DeepSpace00/DeepSpace-KiCad-Global-Source/README.md

# DeepSpace-KiCad-Global-Source
DeepSpace global symbols and footprints for KiCad

# Licnese
Licenced under the [Creative Commons CC-BY-SA 4.0 Licence](https://github.com/Destination-SPACE/DS-KiCad-Global-Source/blob/main/LICENSE) or as referenced

(c) DeepSpace00 2024
