DeepSpace00/DeepSpace-KiCad-Global-Source/DS_models/Connector_JST/JST-XH SMD Parameter Editor.png

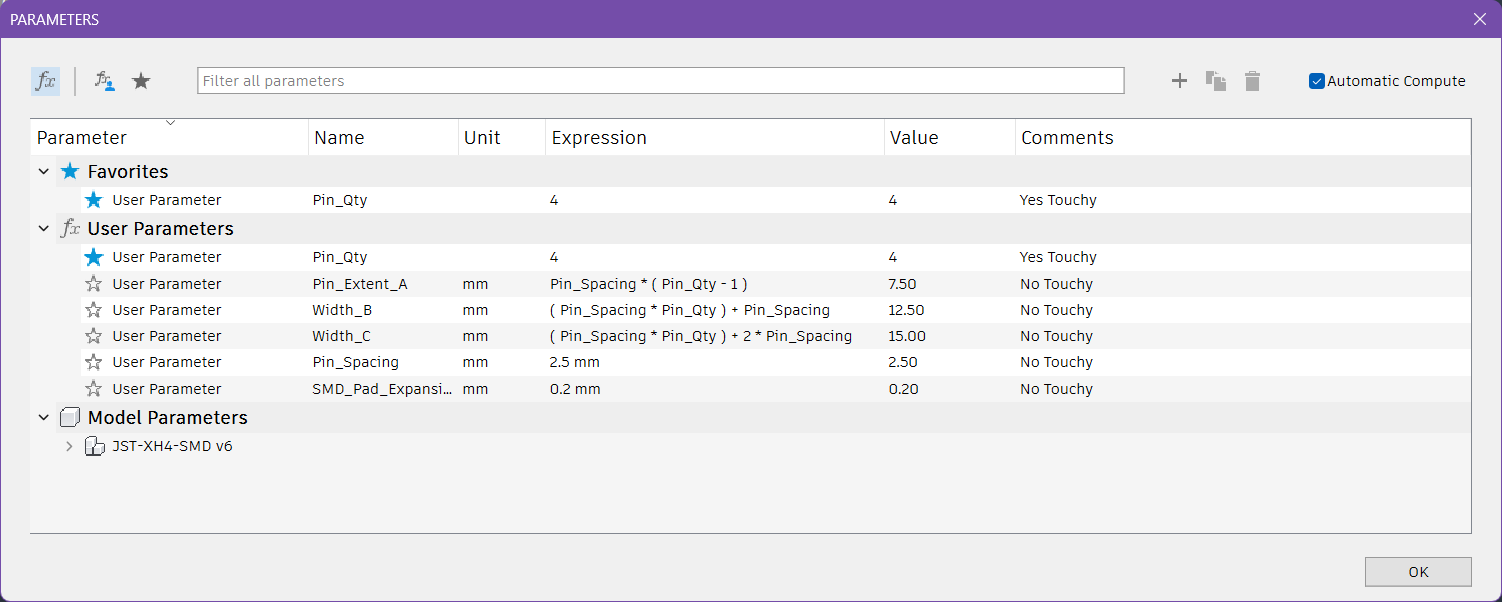
DS_models/Connector_JST/JST-XH SMD Parameter Editor.png
