DeepSpace00/DeepSpace-KiCad-Global-Source/DS_models/xiaoC6-Assembly.step

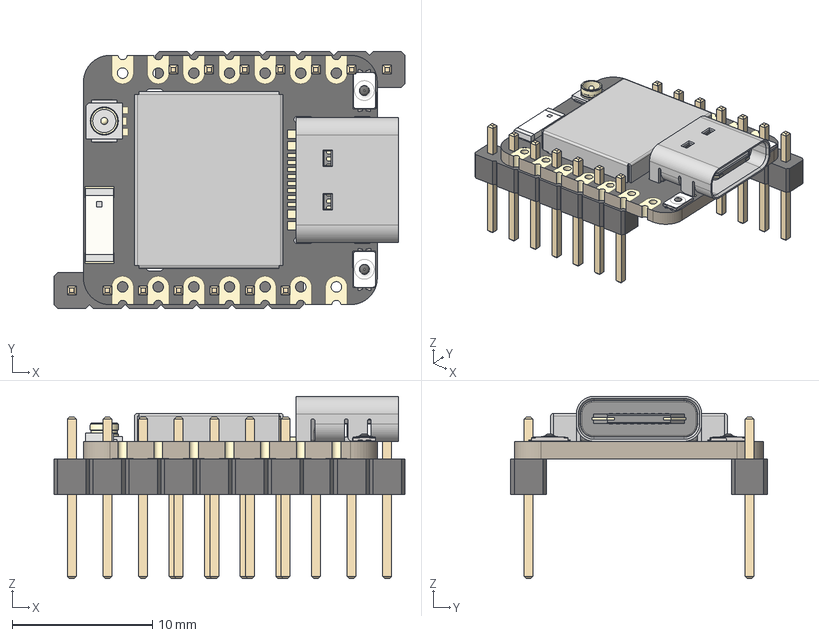
[picture p2: CAD file, 2025-07-27]
DS_models/xiaoC6-Assembly.step
25.0 x 18.3 x 13.0 mm
BOSS-EXTRUDE14_8_
BOSS-EXTRUDE7_4_
BOSS-EXTRUDE7_3_
BOSS-EXTRUDE14_4_
BOSS-EXTRUDE14_2_
BOSS-EXTRUDE14_11_
BOSS-EXTRUDE7_7_
BOSS-EXTRUDE14_9_
BOSS-EXTRUDE14_3_
BOSS-EXTRUDE14_7_
MIRROR2
BOSS-EXTRUDE14_5_
BOSS-EXTRUDE14_12_
BOSS-EXTRUDE7_8_
BOSS-EXTRUDE7_1_
BOSS-EXTRUDE14_10_
BOSS-EXTRUDE7_9_
BOSS-EXTRUDE14_6_
BOSS-EXTRUDE14_1_
BOSS-EXTRUDE7_6_
BOSS-EXTRUDE7_2_
CUT-EXTRUDE5
BOSS-EXTRUDE7_5_
U.FL Connector v1
U.FL Connector v002
U.FL Connector v003
Shield
SKTAAAE010 v1 x 2
KH5220-A36 (Ceramic Antenna) v2
KH5220-A36 (Ceramic Antenna) v003
KH5220-A36 (Ceramic Antenna) v004
KH5220-A36 (Ceramic Antenna) v005
PinHeader_1x07_P254mm_Vertical x 2
