DeepSpace00/DeepSpace-KiCad-Global-Source/DS_models/Battery/bh-98-1.stp

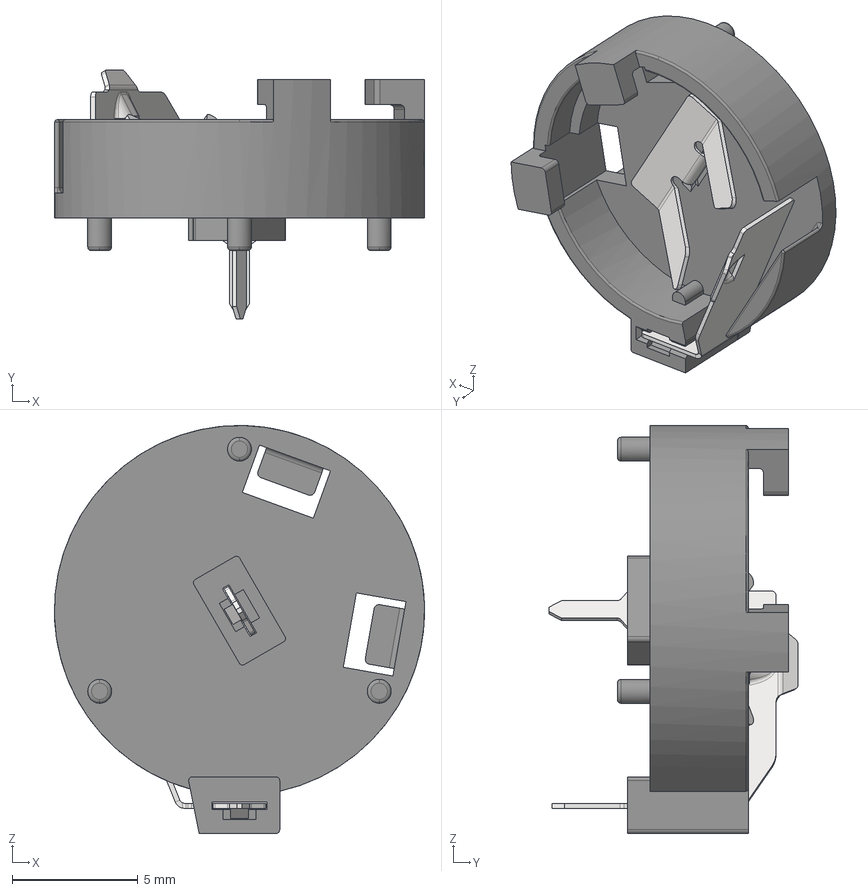
[picture p3: CAD file, 2024-09-05]
DS_models/Battery/bh-98-1.stp
14.7 x 9.88 x 16.2 mm
