DeepSpace00/DeepSpace-KiCad-Global-Source/DS_models/Button_Switch_SMD/PTS647SM38SMTR2LFS.stp

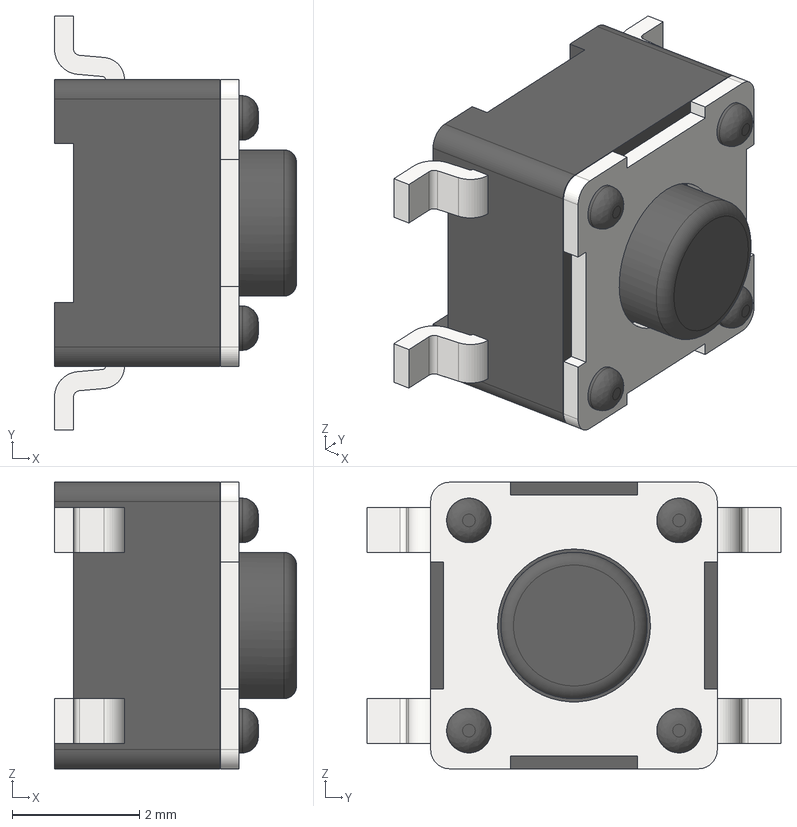
[picture p5: CAD file, 2024-09-05]
DS_models/Button_Switch_SMD/PTS647SM38SMTR2LFS.stp
3.80 x 6.50 x 4.50 mm
