DeepSpace00/DeepSpace-KiCad-Global-Source/DS_models/Buzzer/CUI_DEVICES_CMI-1240-SMT.step

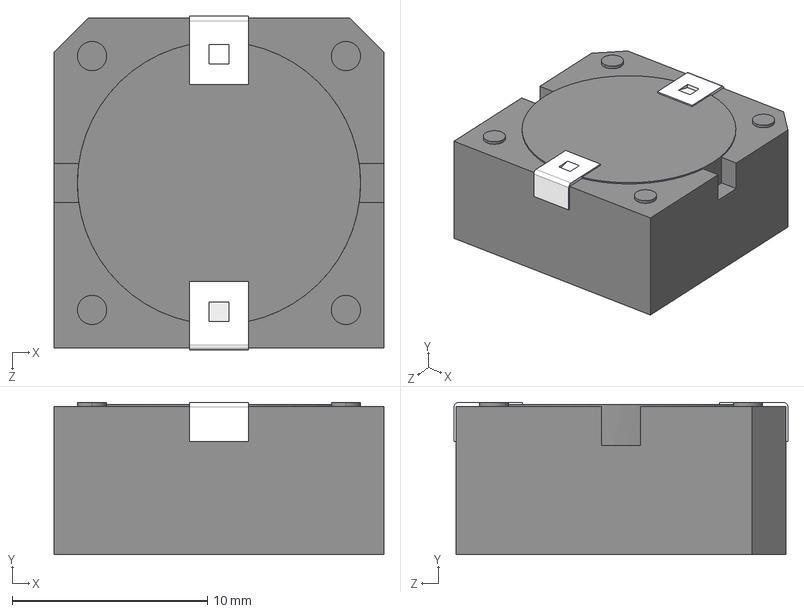
[picture p6: CAD file, 2024-09-05]
DS_models/Buzzer/CUI_DEVICES_CMI-1240-SMT.step
16.9 x 7.80 x 17.1 mm
