DeepSpace00/DeepSpace-KiCad-Global-Source/DS_models/Capacitor_Ceramic_SMD/GRM21BR71A475KE51K.STEP

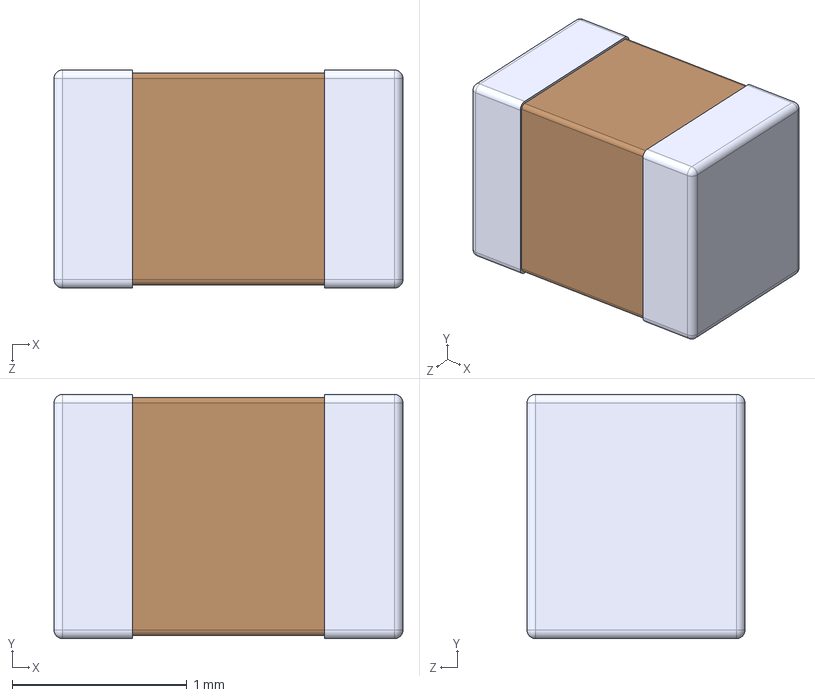
[picture p7: CAD file, 2025-07-27]
DS_models/Capacitor_Ceramic_SMD/GRM21BR71A475KE51K.STEP
2.00 x 1.40 x 1.25 mm
