DeepSpace00/DeepSpace-KiCad-Global-Source/DS_models/Capacitor_Electrolytic_SMD/EXV-9D_KEM.step

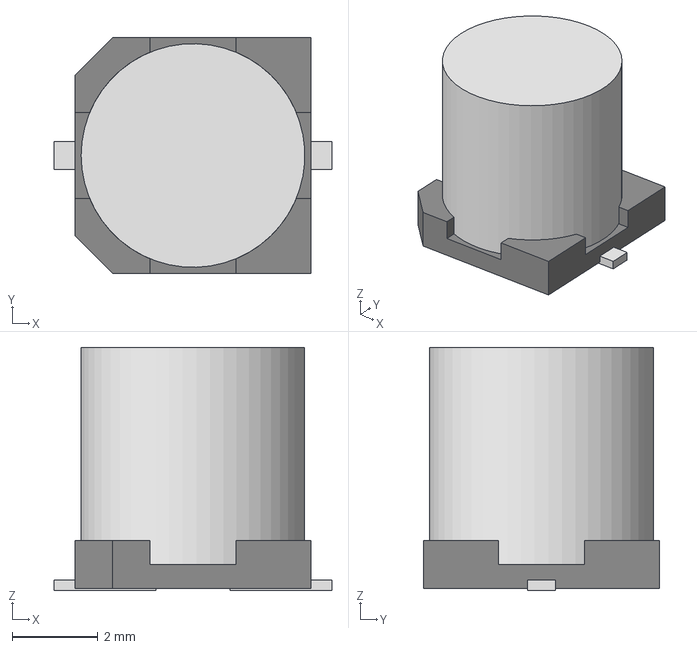
[picture p8: CAD file, 2024-09-05]
DS_models/Capacitor_Electrolytic_SMD/EXV-9D_KEM.step
6.50 x 5.51 x 5.69 mm
