DeepSpace00/DeepSpace-KiCad-Global-Source/DS_models/Connector_Card/XKTF-015-N.stp

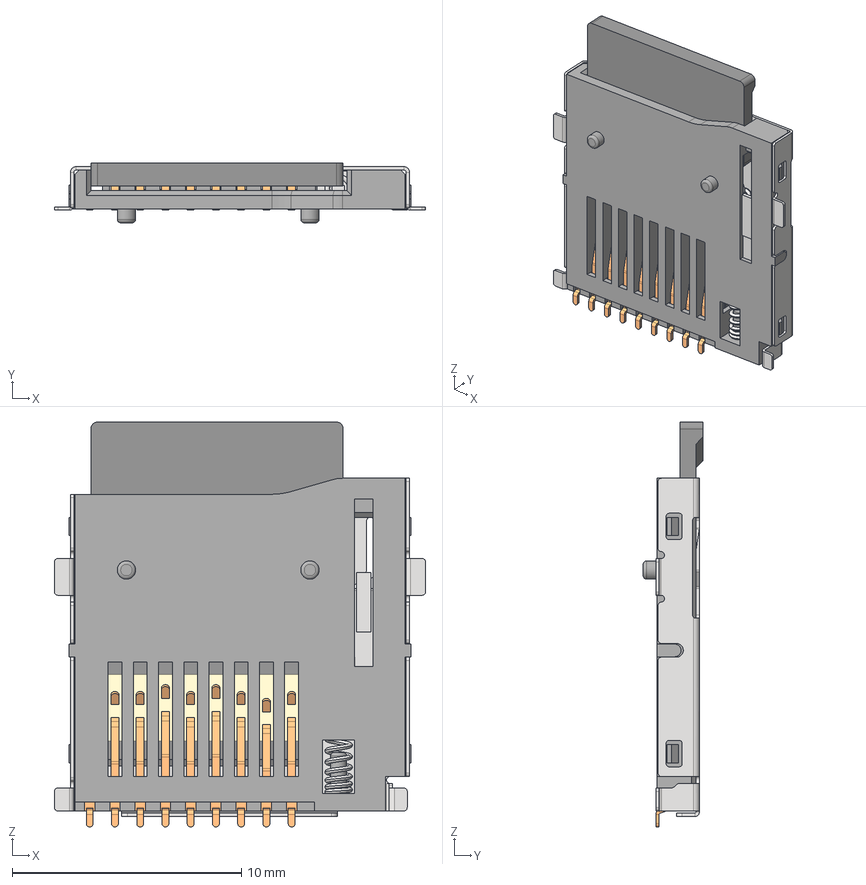
[picture p9: CAD file, 2024-09-05]
DS_models/Connector_Card/XKTF-015-N.stp
16.2 x 2.60 x 17.7 mm
HOUSING
SLIDER
CONNCD_AF0
CONN08_AF2
CONN08_AF4
CONN08_02 x 5
CONN08_03
BAR
SPRING
T-FLASH_CARD
