DeepSpace00/DeepSpace-KiCad-Global-Source/DS_models/Connector_JST/JST-XH4-SMD.step

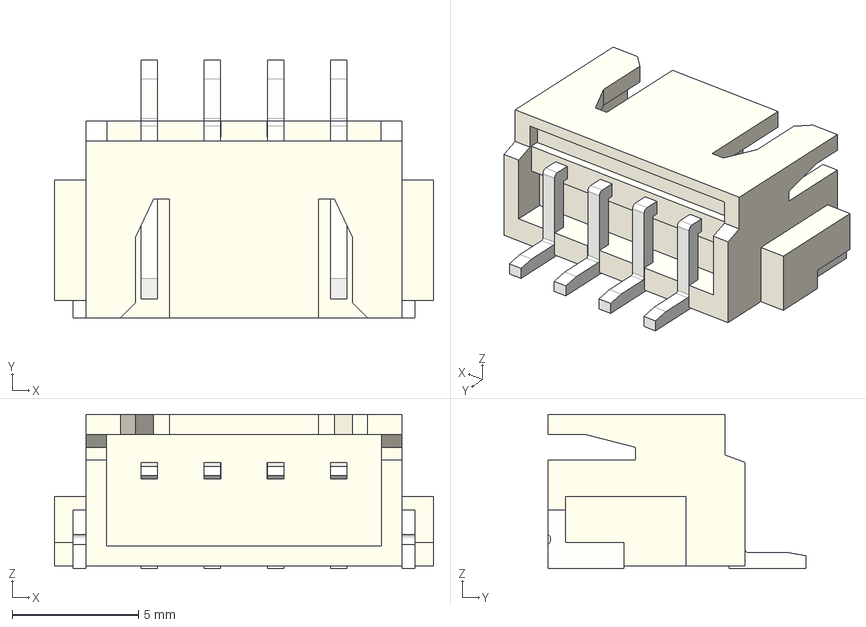
[picture p10: CAD file, 2024-11-03]
DS_models/Connector_JST/JST-XH4-SMD.step
15.0 x 10.2 x 6.10 mm
