DeepSpace00/DeepSpace-KiCad-Global-Source/DS_models/Connector_pinSocket_2.54mm/2041-1X08G00SA.STEP

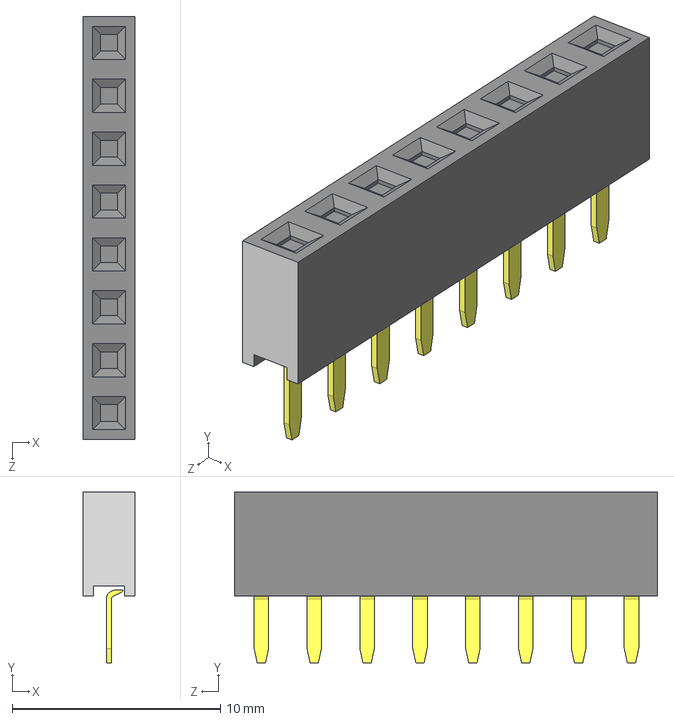
[picture p12: CAD file, 2024-09-05]
DS_models/Connector_pinSocket_2.54mm/2041-1X08G00SA.STEP
2.50 x 8.20 x 20.3 mm
2041-1XxxB_1
2041-Pin-S_1 x 8
