DeepSpace00/DeepSpace-KiCad-Global-Source/DS_models/Connector_USB/USB4105--3DModel-STEP-56544.STEP

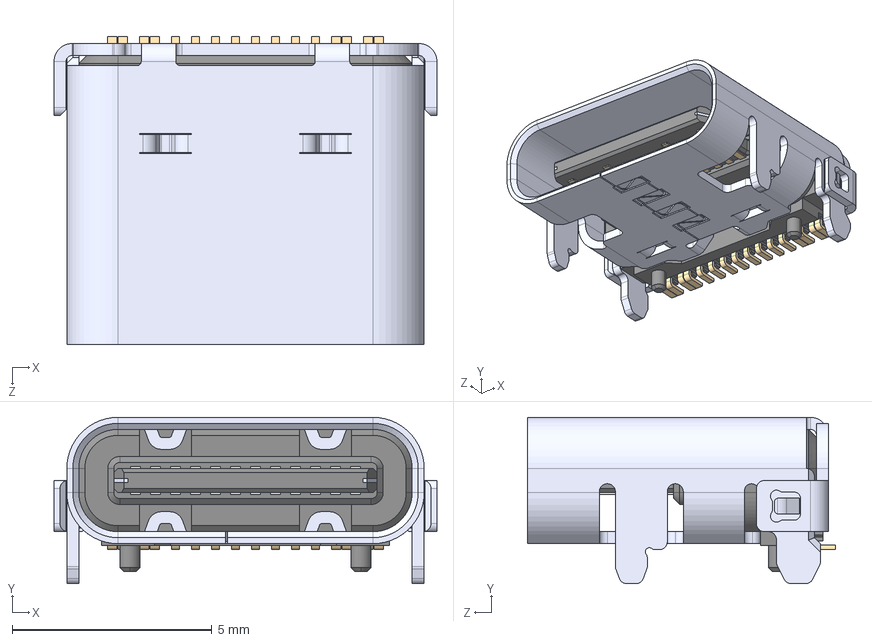
[picture p13: CAD file, 2024-09-05]
DS_models/Connector_USB/USB4105--3DModel-STEP-56544.STEP
9.58 x 4.16 x 7.71 mm
