DeepSpace00/DeepSpace-KiCad-Global-Source/DS_models/Crystal/445I23D12M00000_CTS.step

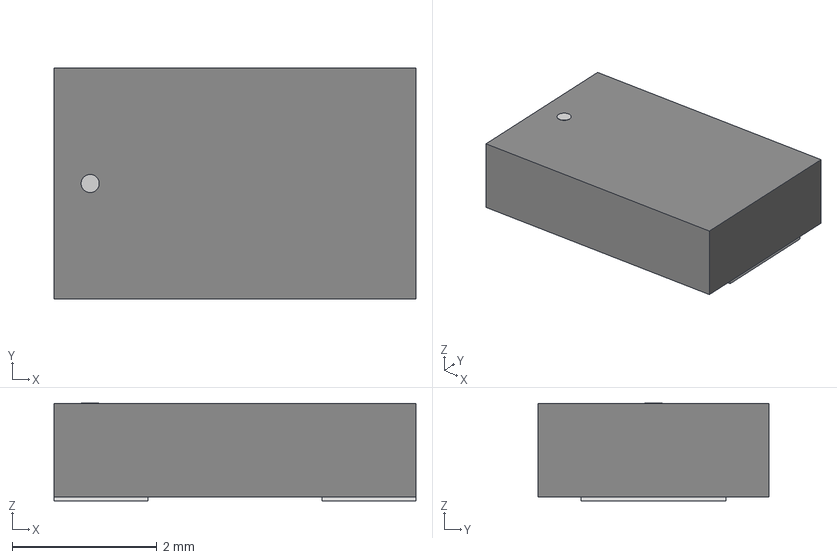
[picture p14: CAD file, 2024-09-05]
DS_models/Crystal/445I23D12M00000_CTS.step
5.00 x 3.20 x 1.35 mm
