DeepSpace00/DeepSpace-KiCad-Global-Source/DS_models/Diode_SMD/DFN1006-2.STEP

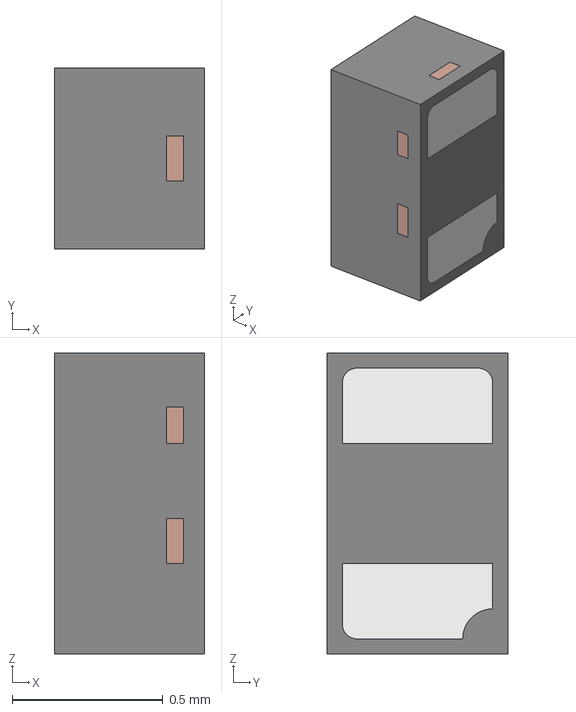
[picture p15: CAD file, 2025-04-04]
DS_models/Diode_SMD/DFN1006-2.STEP
0.5 x 0.6 x 1.00 mm
LDF
