DeepSpace00/DeepSpace-KiCad-Global-Source/DS_models/Display/ZJY114IPS.stp

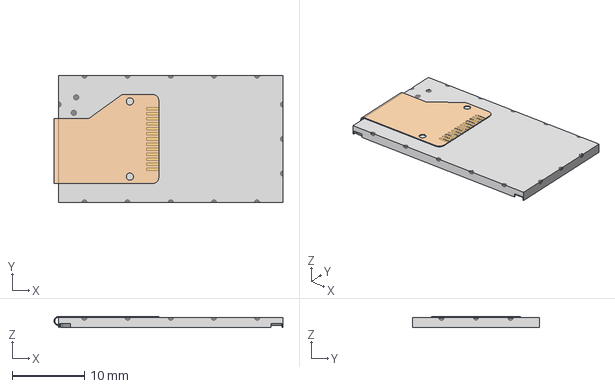
[picture p16: CAD file, 2024-09-05]
DS_models/Display/ZJY114IPS.stp
31.7 x 17.6 x 1.52 mm
