DeepSpace00/DeepSpace-KiCad-Global-Source/DS_models/Fuse/ERB-RD0R50X.STEP

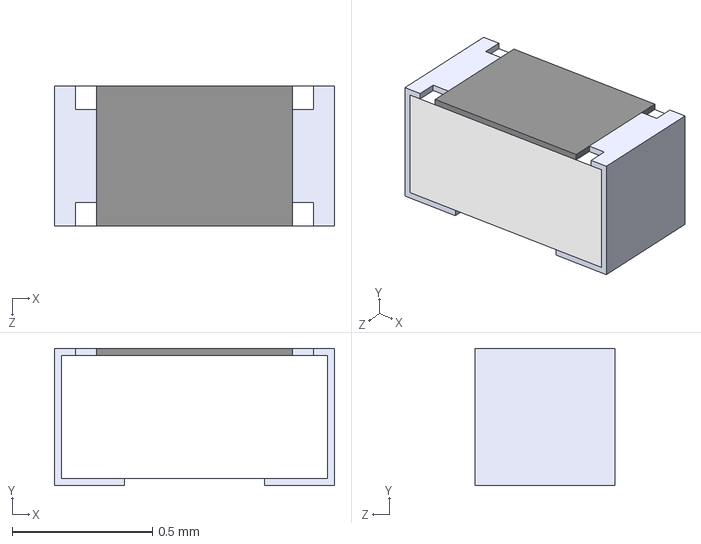
[picture p17: CAD file, 2024-09-05]
DS_models/Fuse/ERB-RD0R50X.STEP
1 x 0.49 x 0.5 mm
