DeepSpace00/DeepSpace-KiCad-Global-Source/DS_models/Inductor_SMD/WE-XHMI-4040.STEP

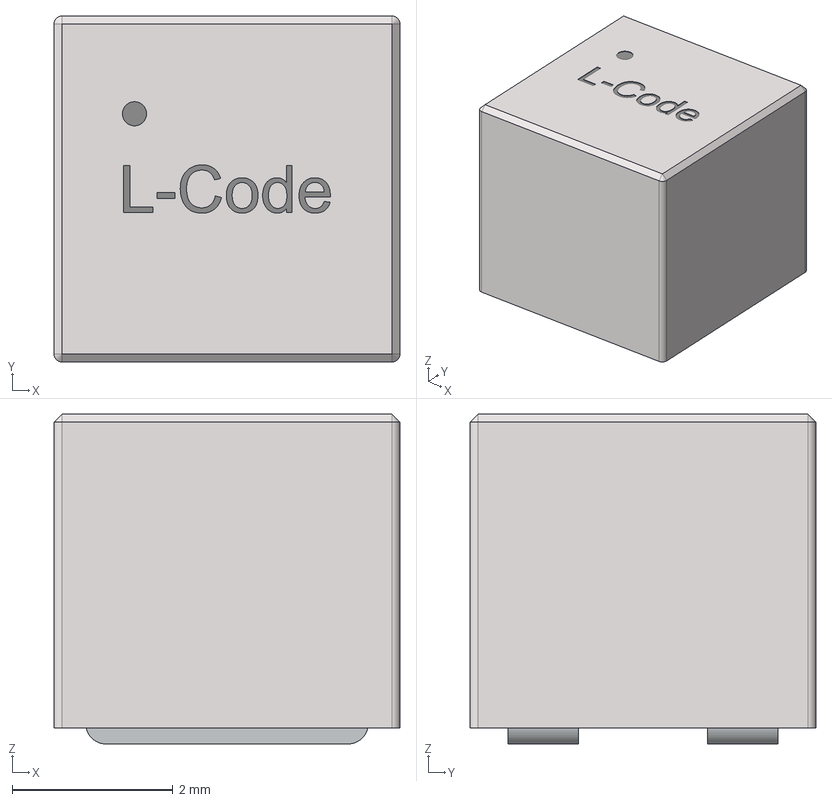
[picture p18: CAD file, 2025-04-14]
DS_models/Inductor_SMD/WE-XHMI-4040.STEP
4.30 x 4.30 x 4.10 mm
