DeepSpace00/DeepSpace-KiCad-Global-Source/DS_models/LED_SMD/LTST-C190K.STEP

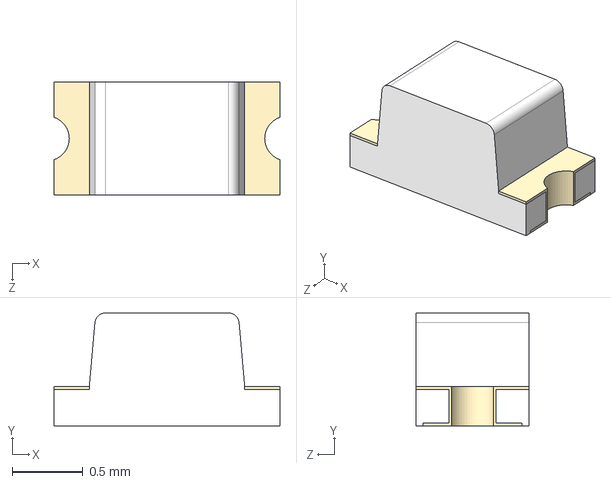
[picture p19: CAD file, 2025-07-27]
DS_models/LED_SMD/LTST-C190K.STEP
1.60 x 0.8 x 0.8 mm
