DeepSpace00/DeepSpace-KiCad-Global-Source/DS_models/Package_QFN/RTY0016A.stp

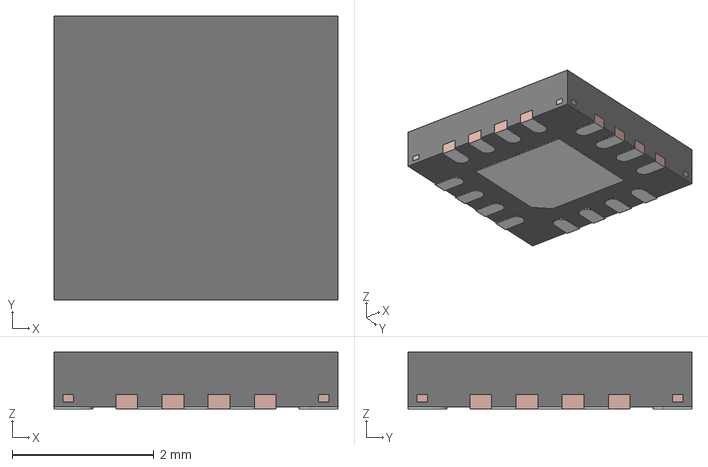
[picture p20: CAD file, 2024-09-05]
DS_models/Package_QFN/RTY0016A.stp
4.00 x 4.00 x 0.8 mm
FRAME
