DeepSpace00/DeepSpace-KiCad-Global-Source/DS_models/Package_SO/SOT23F.STEP

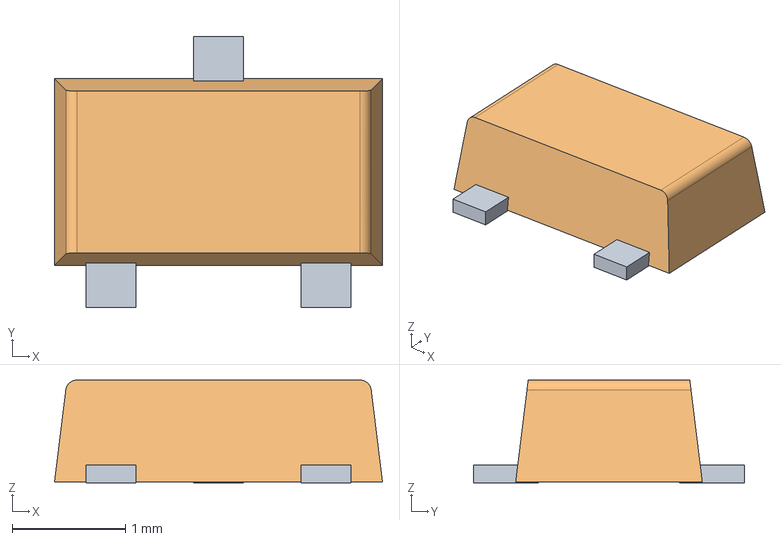
[picture p21: CAD file, 2025-04-04]
DS_models/Package_SO/SOT23F.STEP
2.90 x 2.40 x 0.91 mm
