DeepSpace00/DeepSpace-KiCad-Global-Source/DS_models/Package_SON/DRV8835DSSR--3DModel-STEP-56544.STEP

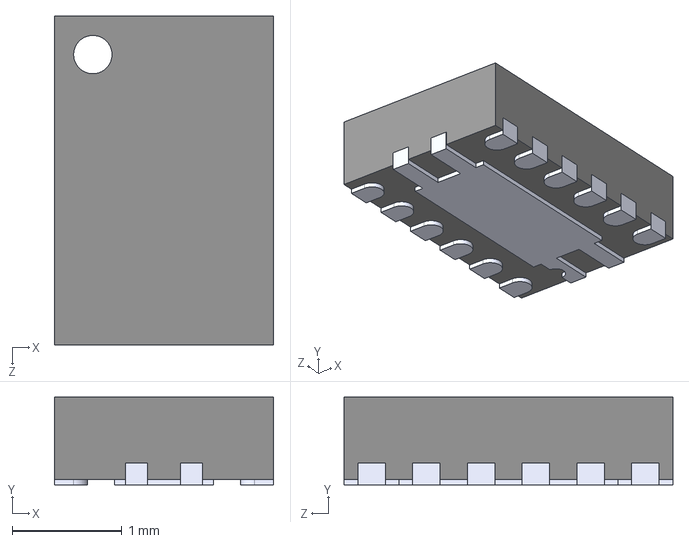
[picture p22: CAD file, 2024-09-05]
DS_models/Package_SON/DRV8835DSSR--3DModel-STEP-56544.STEP
2.00 x 0.8 x 3.00 mm
