DeepSpace00/DeepSpace-KiCad-Global-Source/DS_models/Package_TO_SOT_SMD/DMP2035UVTQ-7.stp

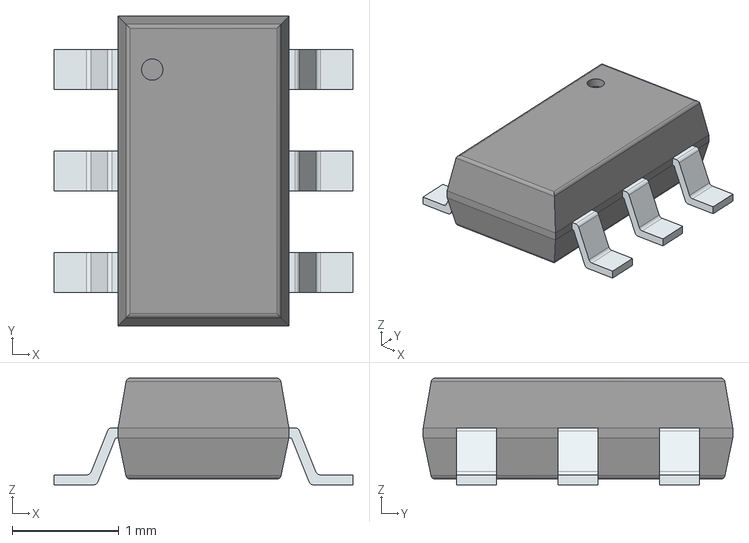
[picture p23: CAD file, 2024-09-05]
DS_models/Package_TO_SOT_SMD/DMP2035UVTQ-7.stp
2.80 x 2.90 x 1.00 mm
PinsArrayLR
