DeepSpace00/DeepSpace-KiCad-Global-Source/DS_models/Resistor_SMD/WSR4527.STEP

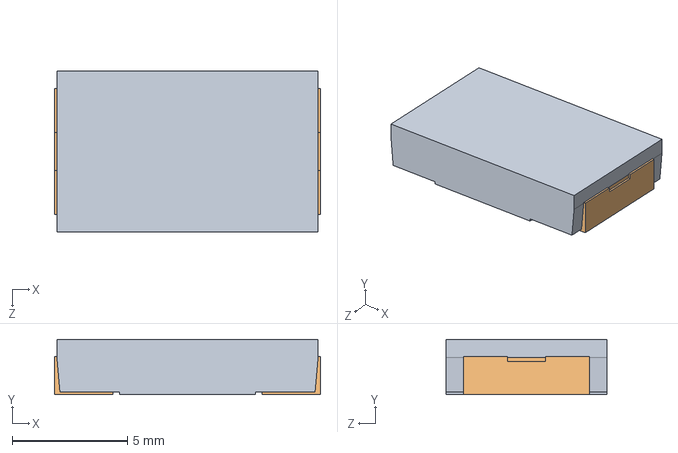
[picture p24: CAD file, 2025-04-04]
DS_models/Resistor_SMD/WSR4527.STEP
11.6 x 2.41 x 6.98 mm
