DeepSpace00/DeepSpace-KiCad-Global-Source/DS_models/RF_Module/ESP32-S3-MINI-1-N8--3DModel-STEP-1.STEP

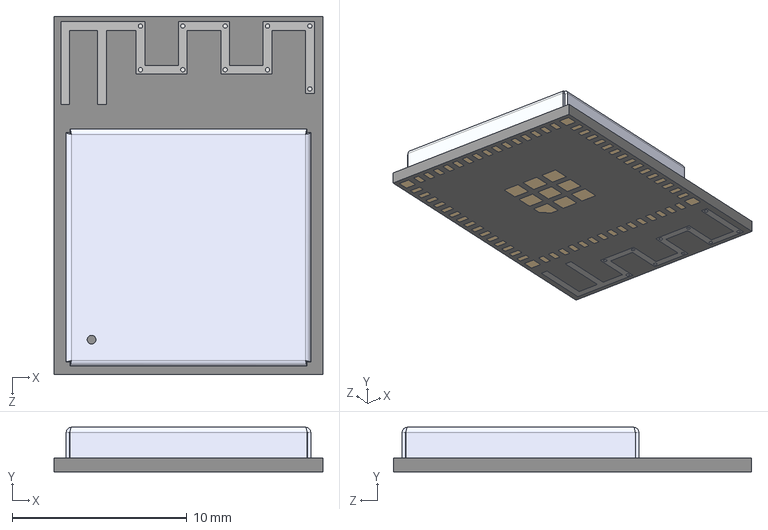
[picture p25: CAD file, 2024-09-05]
DS_models/RF_Module/ESP32-S3-MINI-1-N8--3DModel-STEP-1.STEP
15.4 x 2.55 x 20.5 mm
