DeepSpace00/DeepSpace-KiCad-Global-Source/DS_models/RF_Receivers/zed-f9p.STEP

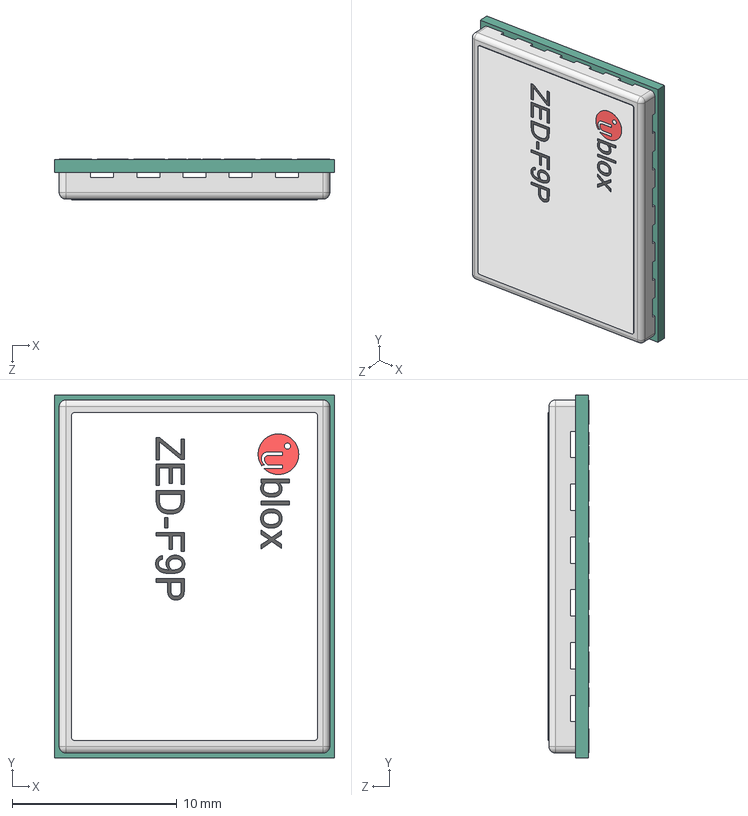
[picture p26: CAD file, 2024-09-05]
DS_models/RF_Receivers/zed-f9p.STEP
17.0 x 22.0 x 2.50 mm
Imported
Imported_2
Imported_3
Imported_4
Imported_5
Imported_6
