DeepSpace00/DeepSpace-KiCad-Global-Source/DS_models/Sensors_Environmental/SHT41-AD1B-R3--3DModel-STEP-369182.STEP

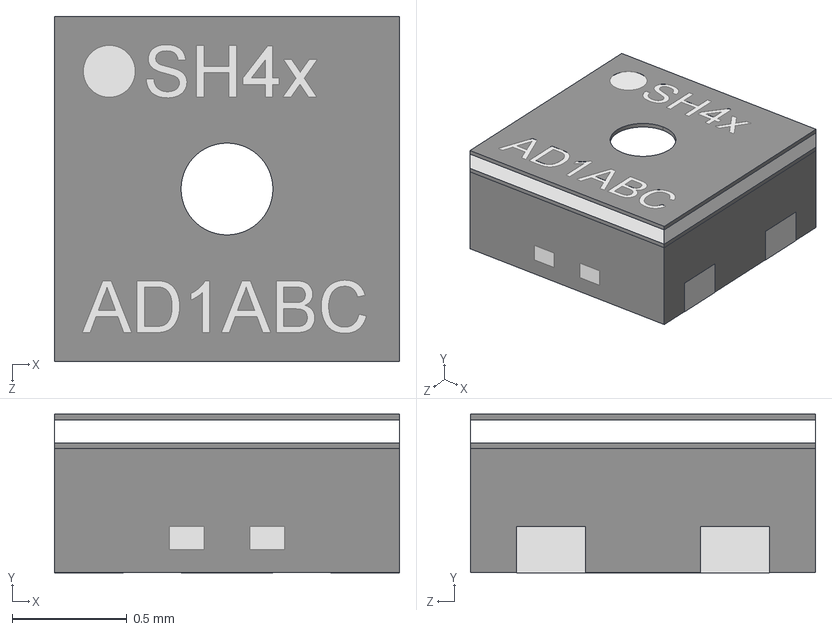
[picture p28: CAD file, 2024-09-05]
DS_models/Sensors_Environmental/SHT41-AD1B-R3--3DModel-STEP-369182.STEP
1.50 x 0.691 x 1.50 mm
