DeepSpace00/DeepSpace-KiCad-Global-Source/DS_models/Sensors_Inertial/LIS3MDLTR--3DModel-STEP-56544.STEP

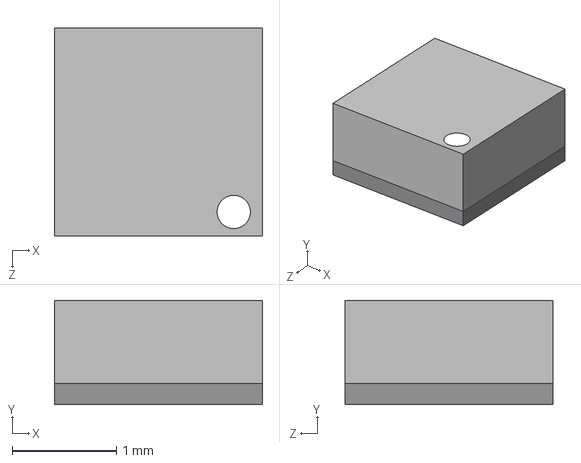
[picture p29: CAD file, 2024-09-05]
DS_models/Sensors_Inertial/LIS3MDLTR--3DModel-STEP-56544.STEP
2.00 x 1.00 x 2.00 mm
