DeepSpace00/DeepSpace-KiCad-Global-Source/DS_models/Battery/2479_short_leads.stp

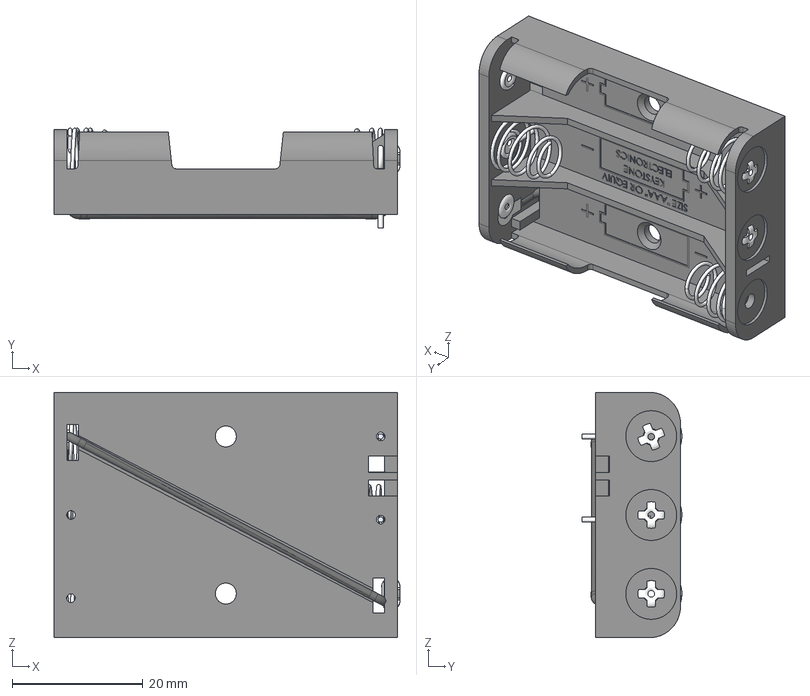
[picture p30: CAD file, 2024-09-05]
DS_models/Battery/2479_short_leads.stp
52.9 x 15.3 x 37.5 mm
