DeepSpace00/DeepSpace-KiCad-Global-Source/DS_models/Breakout_Board/xiaoRP2040.step

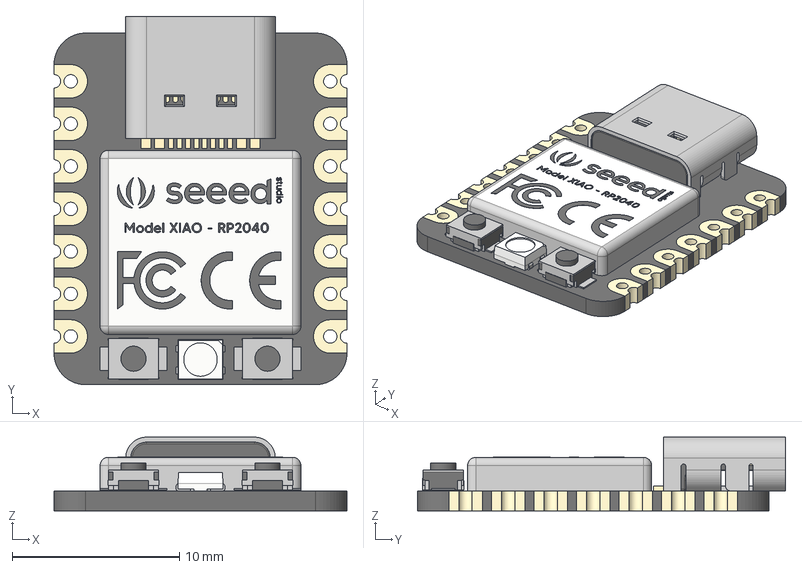
[picture p31: CAD file, 2024-09-05]
DS_models/Breakout_Board/xiaoRP2040.step
17.5 x 22.0 x 4.40 mm
type-c v2
smd_button v3
DOUT
DIN
VSS
VDD
smd_button v3(Mirror)
