DeepSpace00/DeepSpace-KiCad-Global-Source/DS_models/Button_Switch_SMD/KMR221GLFS.STEP

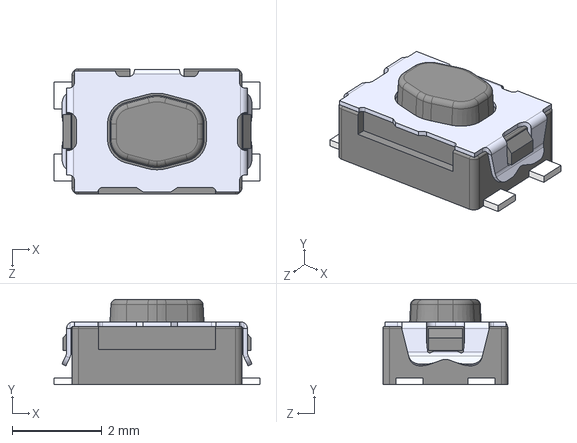
[picture p32: CAD file, 2024-09-05]
DS_models/Button_Switch_SMD/KMR221GLFS.STEP
4.60 x 1.90 x 2.80 mm
