DeepSpace00/DeepSpace-KiCad-Global-Source/DS_models/Capacitor_Ceramic_SMD/GCM32ER71E106KA57L.STEP

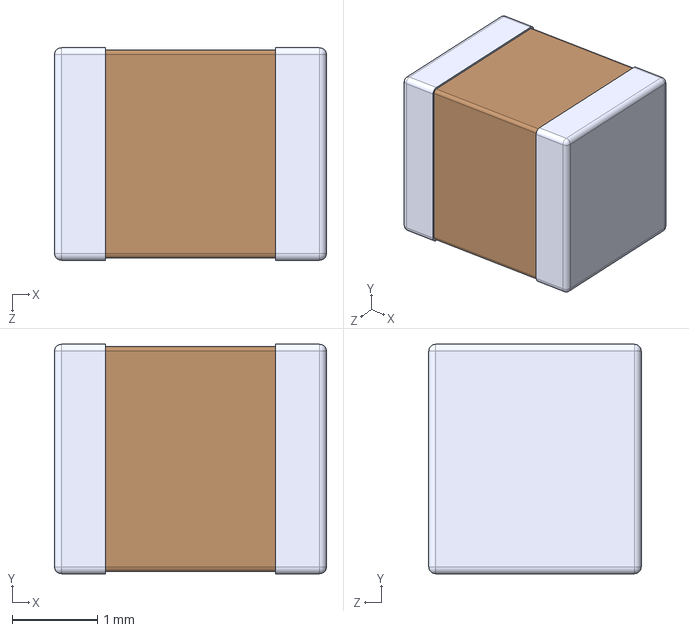
[picture p33: CAD file, 2025-04-04]
DS_models/Capacitor_Ceramic_SMD/GCM32ER71E106KA57L.STEP
3.20 x 2.70 x 2.50 mm
