DeepSpace00/DeepSpace-KiCad-Global-Source/DS_models/Connector_Card/MEM2051-00-195-00-A.step

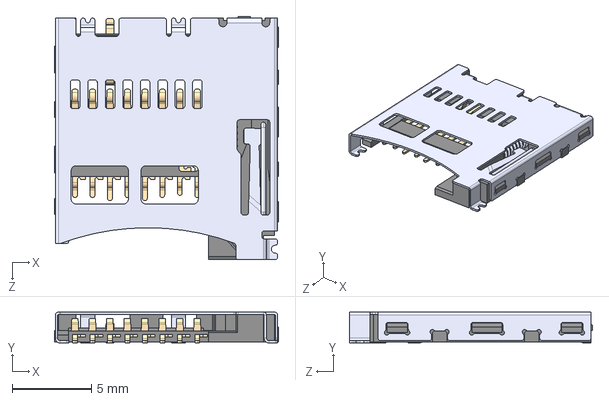
[picture p34: CAD file, 2024-09-05]
DS_models/Connector_Card/MEM2051-00-195-00-A.step
14.1 x 1.95 x 15.3 mm
