DeepSpace00/DeepSpace-KiCad-Global-Source/DS_models/Connector_JST/JST-XH3-SMD.step

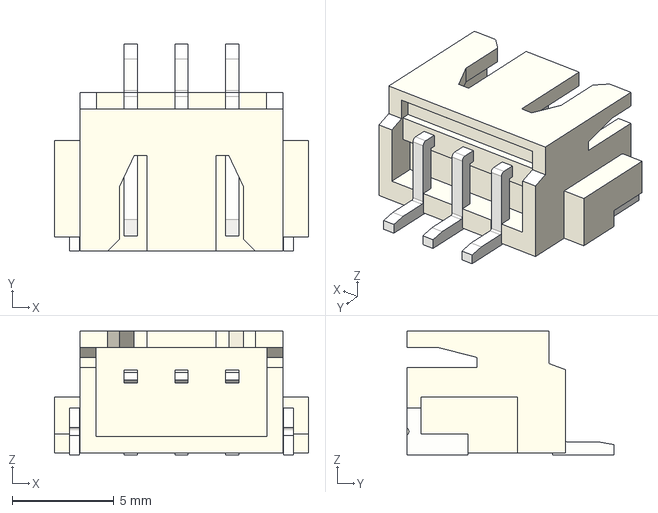
[picture p35: CAD file, 2024-11-03]
DS_models/Connector_JST/JST-XH3-SMD.step
12.5 x 10.2 x 6.10 mm
