DeepSpace00/DeepSpace-KiCad-Global-Source/DS_models/Connector_PinHeader_2.54mm/PinHeader_1x35_P2.54mm_Vertical_SMD_Pin1Right.step

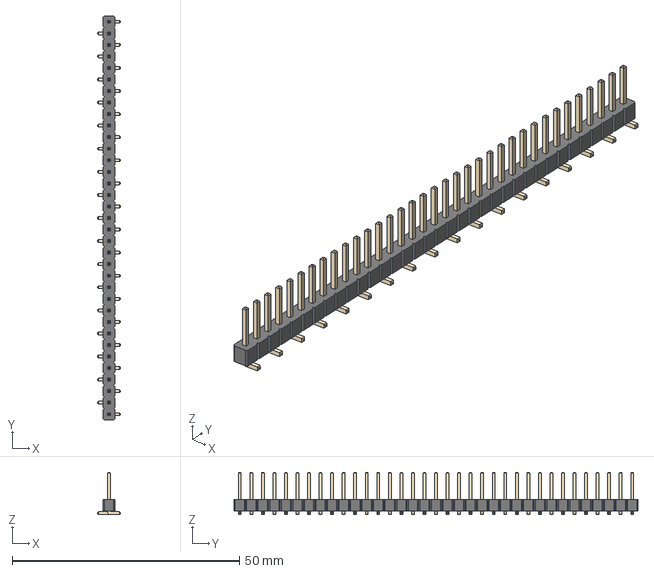
[picture p36: CAD file, 2025-07-27]
DS_models/Connector_PinHeader_2.54mm/PinHeader_1x35_P2.54mm_Vertical_SMD_Pin1Right.step
5.00 x 88.9 x 9.30 mm
