DeepSpace00/DeepSpace-KiCad-Global-Source/DS_models/Connector_pinSocket_2.54mm/1x12ShortHeader.stp

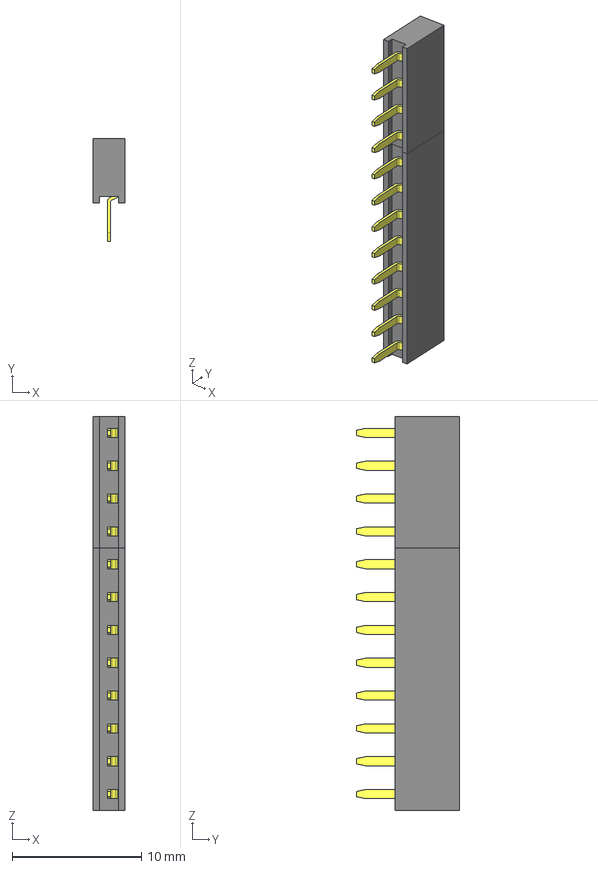
[picture p37: CAD file, 2024-09-05]
DS_models/Connector_pinSocket_2.54mm/1x12ShortHeader.stp
2.50 x 8.00 x 30.5 mm
2041-1XxxB_1
2041-Pin-S_1 x 12
2041-1XxxB_1_1
2041-Pin-S_1_1
2041-Pin-S_1_2
2041-Pin-S_1_3
2041-Pin-S_1_4
