DeepSpace00/DeepSpace-KiCad-Global-Source/DS_models/Connector_USB/1-292303-1.step

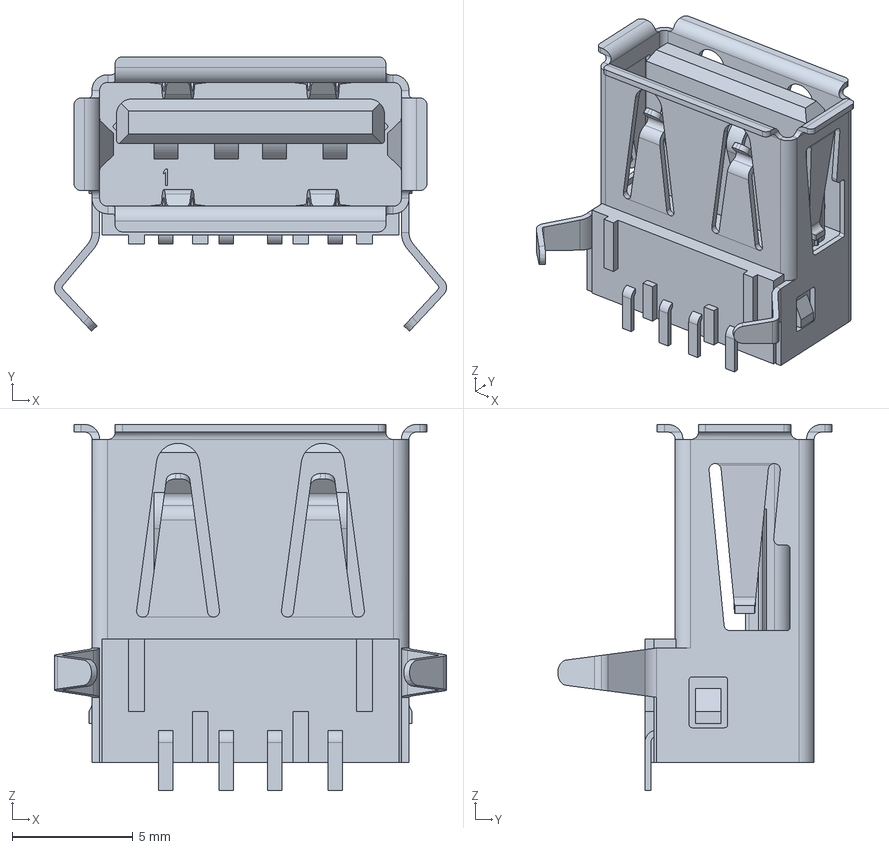
[picture p38: CAD file, 2024-09-05]
DS_models/Connector_USB/1-292303-1.step
16.2 x 11.4 x 15.2 mm
