DeepSpace00/DeepSpace-KiCad-Global-Source/DS_models/Crystal/CTS_-_445C25D12M00000.step

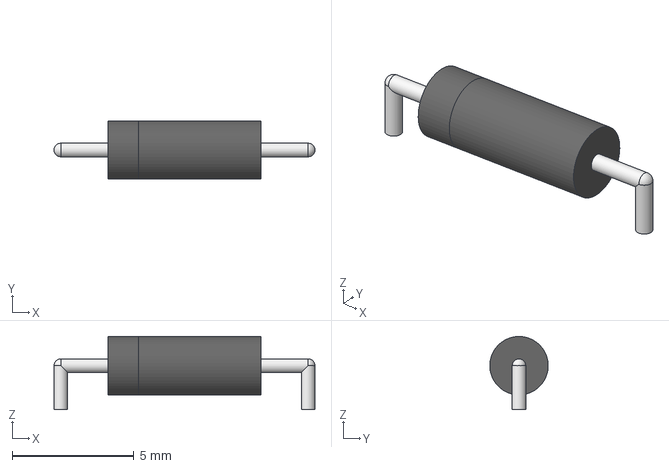
[picture p39: CAD file, 2024-09-05]
DS_models/Crystal/CTS_-_445C25D12M00000.step
10.7 x 2.40 x 3.00 mm
