DeepSpace00/DeepSpace-KiCad-Global-Source/DS_models/Diode_SMD/SOD523.STEP

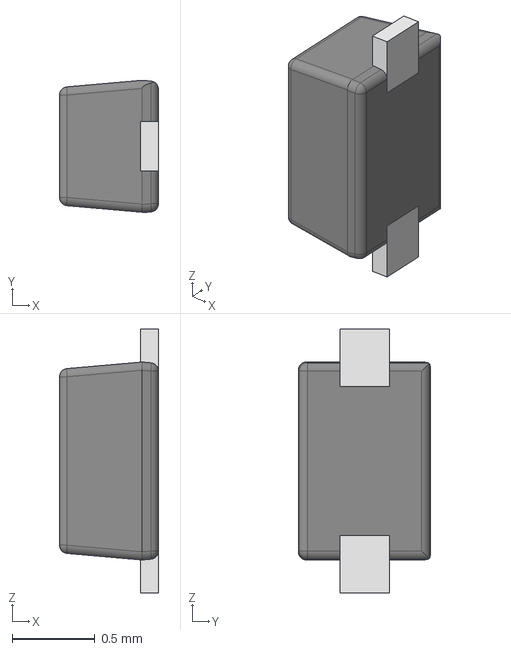
[picture p40: CAD file, 2025-04-04]
DS_models/Diode_SMD/SOD523.STEP
0.6 x 0.803 x 1.60 mm
SOD523 LF
SOD523 compound
