DeepSpace00/DeepSpace-KiCad-Global-Source/DS_models/Inductor_SMD/WE-XHMI-7070.STEP

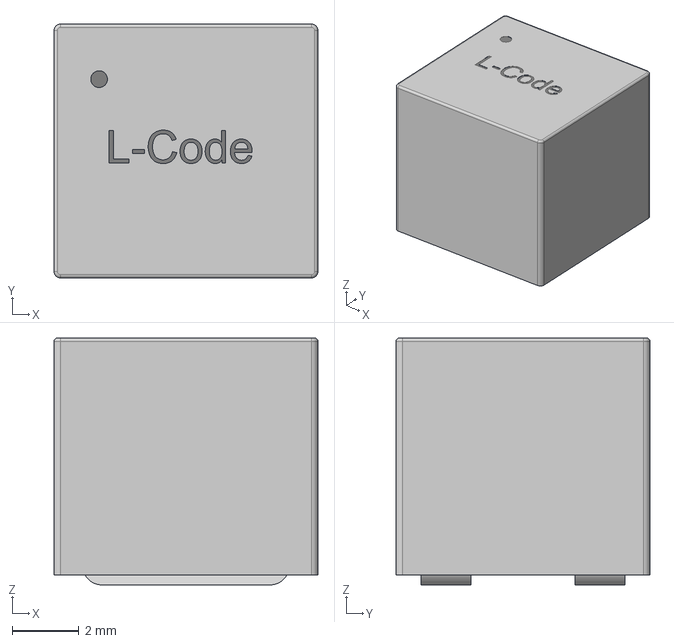
[picture p41: CAD file, 2025-04-14]
DS_models/Inductor_SMD/WE-XHMI-7070.STEP
7.90 x 7.60 x 7.39 mm
