DeepSpace00/DeepSpace-KiCad-Global-Source/DS_models/LED_SMD/LTST-C150.STEP

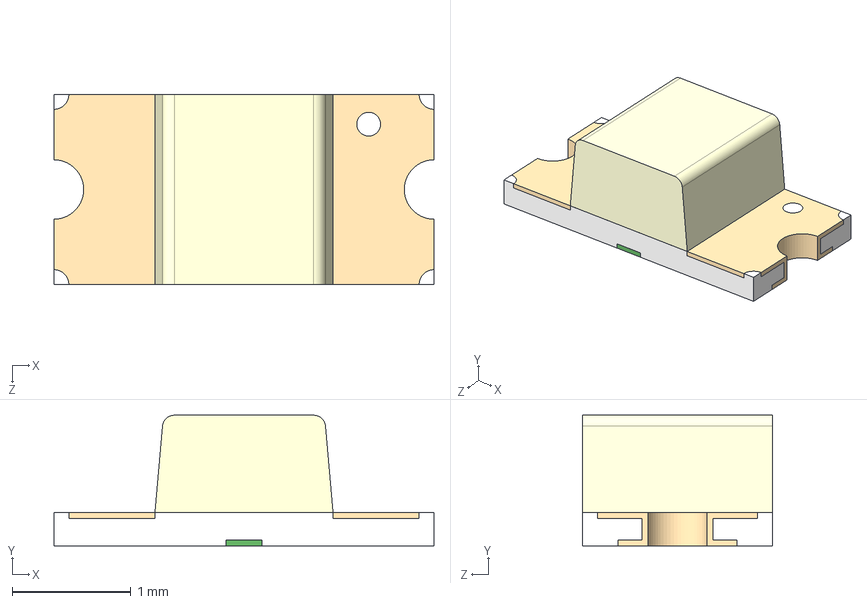
[picture p42: CAD file, 2024-11-03]
DS_models/LED_SMD/LTST-C150.STEP
3.20 x 1.10 x 1.60 mm
