DeepSpace00/DeepSpace-KiCad-Global-Source/DS_models/Package_QFN/RNR0011A.stp

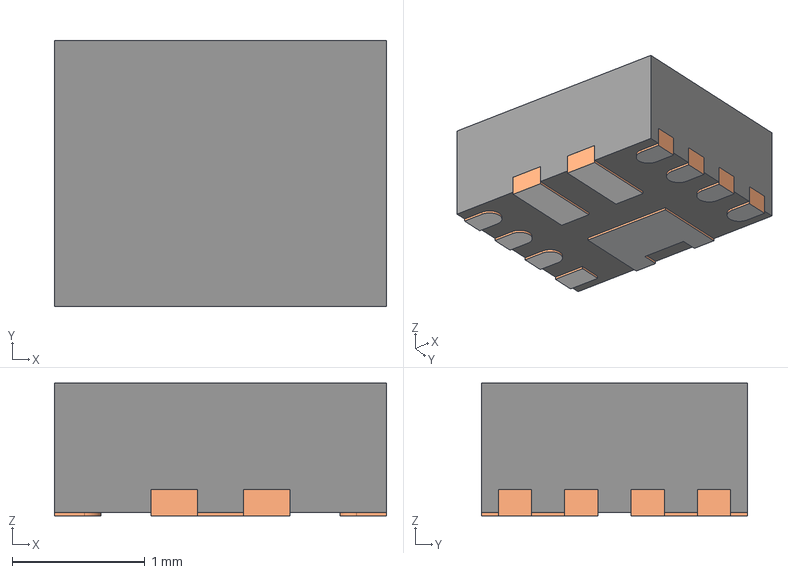
[picture p43: CAD file, 2024-09-05]
DS_models/Package_QFN/RNR0011A.stp
2.50 x 2.00 x 1.00 mm
FRAME-RNR0011A
BODY-QFN
PIN1-ID
