DeepSpace00/DeepSpace-KiCad-Global-Source/DS_models/Package_SO/SOT563.STEP

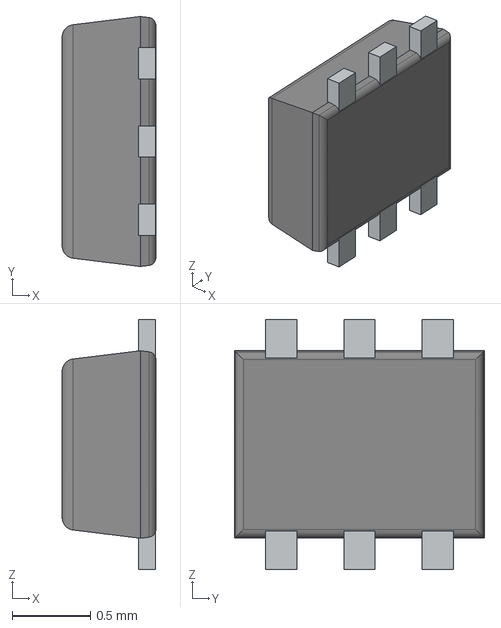
[picture p44: CAD file, 2025-04-04]
DS_models/Package_SO/SOT563.STEP
0.6 x 1.60 x 1.60 mm
LDF
Mold
