DeepSpace00/DeepSpace-KiCad-Global-Source/DS_models/Package_SON/USON_3X2_WIN.step

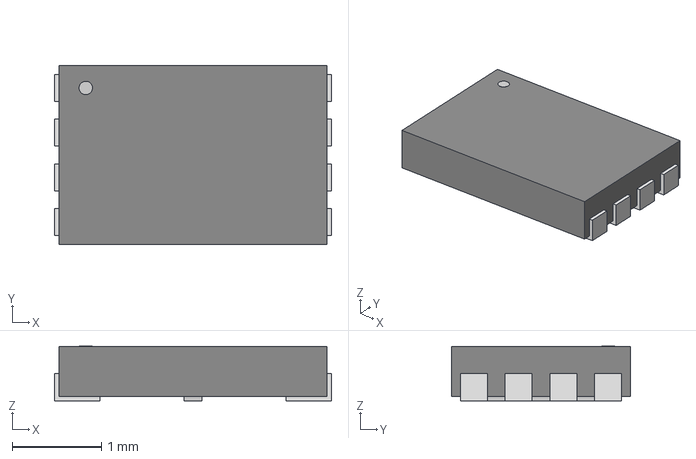
[picture p45: CAD file, 2024-09-05]
DS_models/Package_SON/USON_3X2_WIN.step
3.10 x 2.01 x 0.612 mm
