DeepSpace00/DeepSpace-KiCad-Global-Source/DS_models/Package_TO_SOT_SMD/DBV0005A.stp

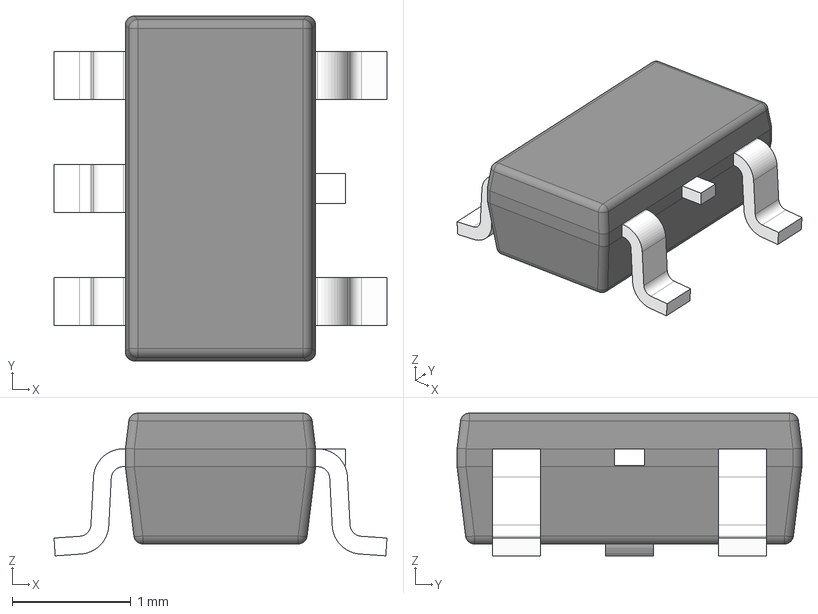
[picture p46: CAD file, 2024-09-05]
DS_models/Package_TO_SOT_SMD/DBV0005A.stp
2.80 x 2.90 x 1.20 mm
BODY-SOT
LEAD-SOT x 5
LEAD-DUMMY
