DeepSpace00/DeepSpace-KiCad-Global-Source/DS_models/Resistor_SMD/WSL1020.STEP

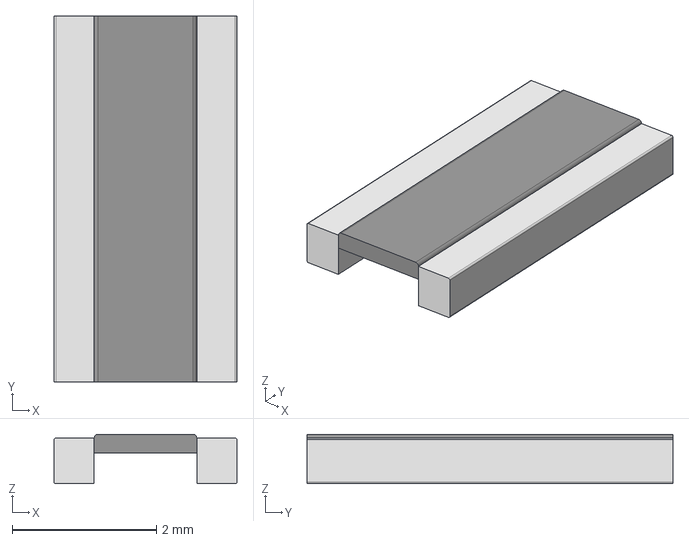
[picture p47: CAD file, 2024-12-22]
DS_models/Resistor_SMD/WSL1020.STEP
2.54 x 5.08 x 0.685 mm
