DeepSpace00/DeepSpace-KiCad-Global-Source/DS_models/Sensor_Current/INA3221AIRGVR--3DModel-STEP-56544.STEP

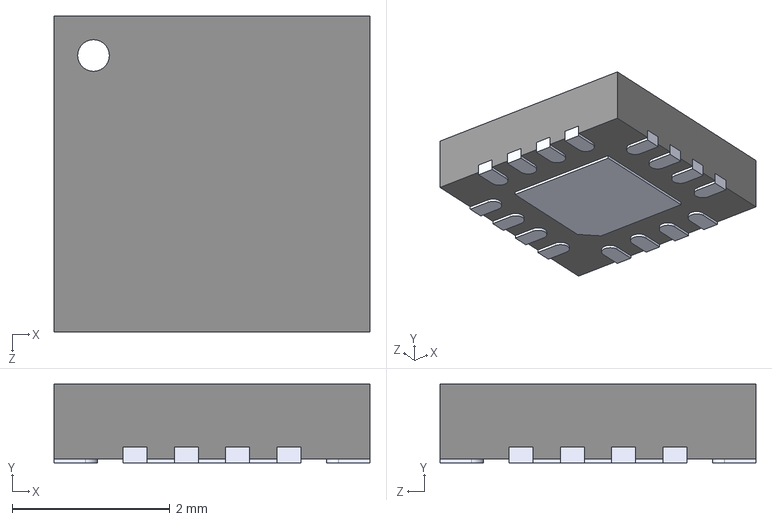
[picture p48: CAD file, 2024-09-05]
DS_models/Sensor_Current/INA3221AIRGVR--3DModel-STEP-56544.STEP
4.00 x 1.00 x 4.00 mm
