DeepSpace00/DeepSpace-KiCad-Global-Source/DS_models/Sensors_Environmental/LPS22HH.step

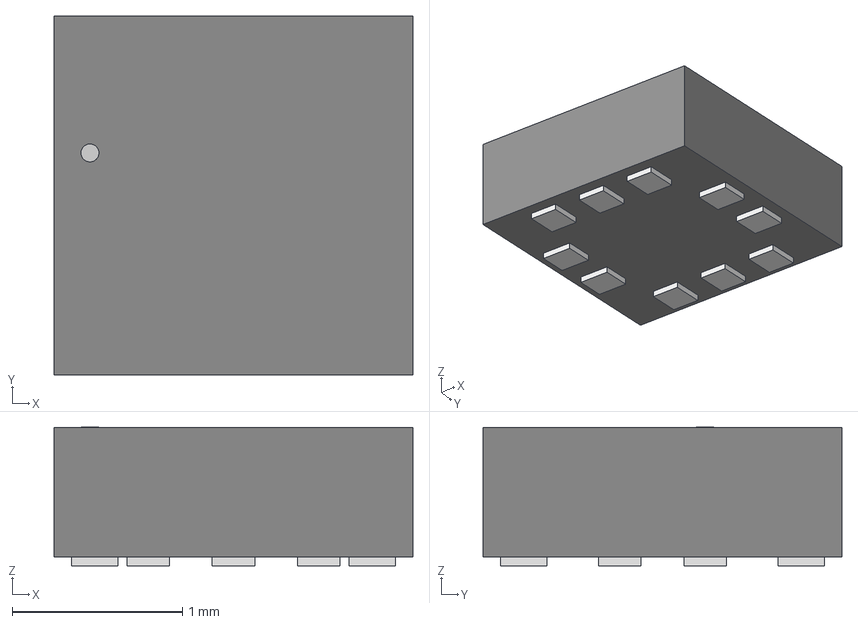
[picture p49: CAD file, 2024-09-05]
DS_models/Sensors_Environmental/LPS22HH.step
2.11 x 2.11 x 0.815 mm
