DeepSpace00/DeepSpace-KiCad-Global-Source/DS_models/Sensors_Inertial/BNO055--3DModel-STEP-56544.STEP

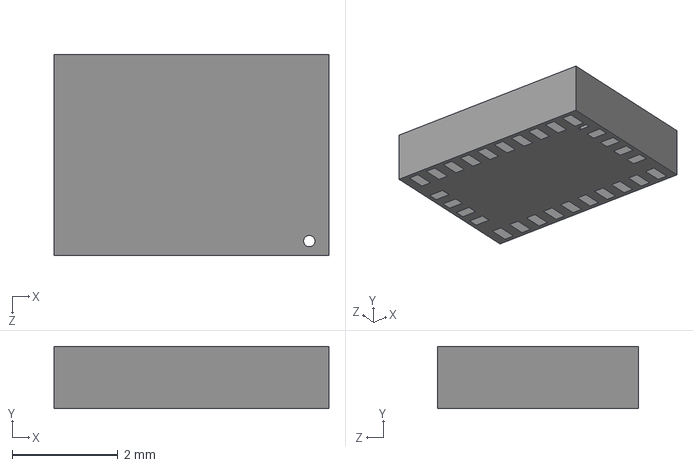
[picture p50: CAD file, 2024-09-05]
DS_models/Sensors_Inertial/BNO055--3DModel-STEP-56544.STEP
5.20 x 1.18 x 3.80 mm
