DeepSpace00/DeepSpace-KiCad-Global-Source/DS_models/Breakout_Board/qtpyRP2040_with_pins.stp

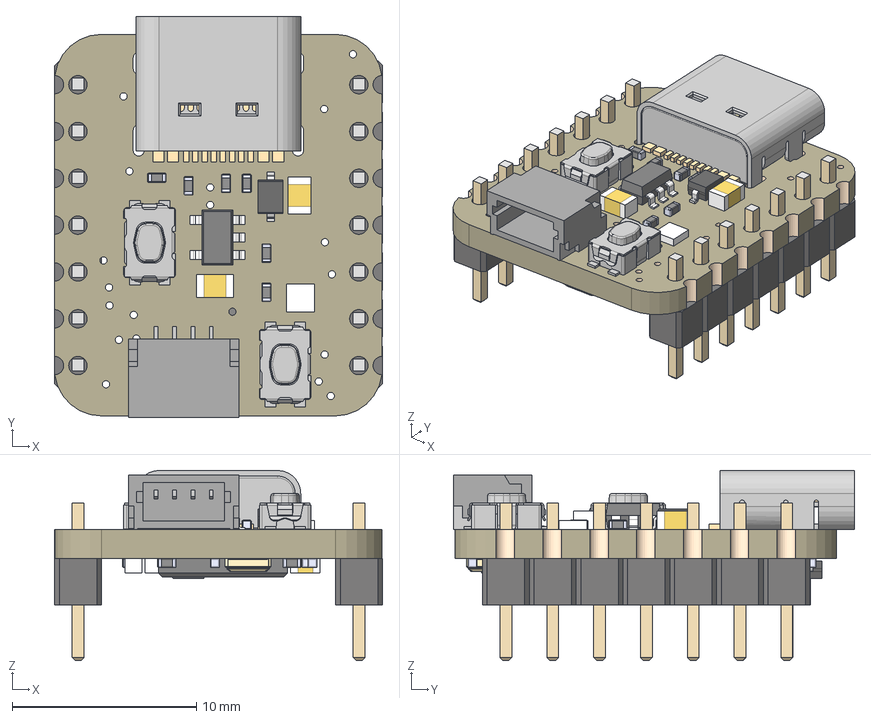
[picture p51: CAD file, 2024-09-05]
DS_models/Breakout_Board/qtpyRP2040_with_pins.stp
17.8 x 21.8 x 10.3 mm
4900 QTPY-RP2040
PinHeader_1x07_P254mm_Vertical
PinHeader_1x07_P254mm_Vertical_1
