DeepSpace00/DeepSpace-KiCad-Global-Source/DS_models/Capacitor_Ceramic_SMD/GCM31CR71A226ME02L.STEP

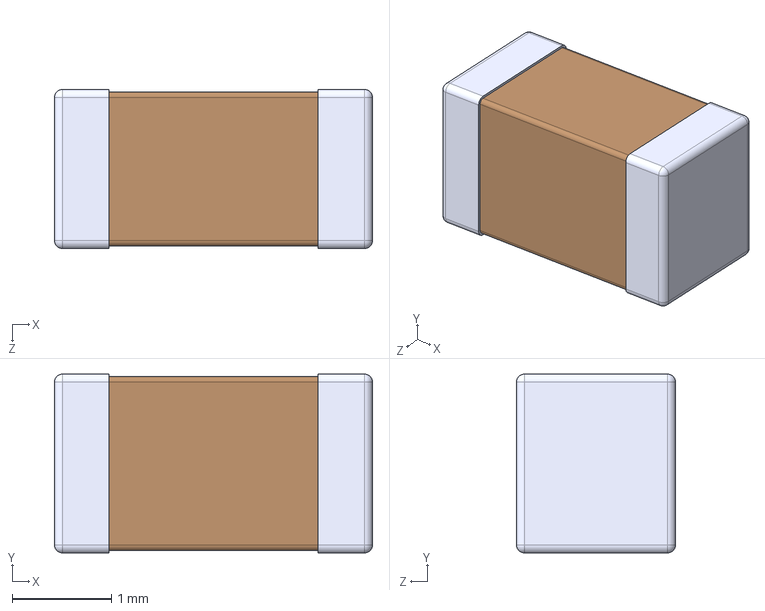
[picture p52: CAD file, 2025-04-04]
DS_models/Capacitor_Ceramic_SMD/GCM31CR71A226ME02L.STEP
3.20 x 1.80 x 1.60 mm
