DeepSpace00/DeepSpace-KiCad-Global-Source/DS_models/Connector_pinSocket_2.54mm/C161LFBN-RC.stp

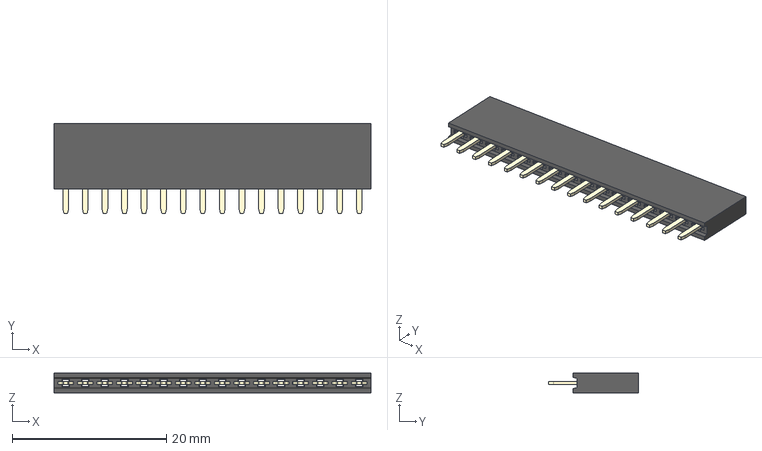
[picture p55: CAD file, 2024-09-05]
DS_models/Connector_pinSocket_2.54mm/C161LFBN-RC.stp
41.1 x 11.7 x 2.54 mm
