DeepSpace00/DeepSpace-KiCad-Global-Source/DS_models/Connector_USB/DX07S016JA1R1500.step

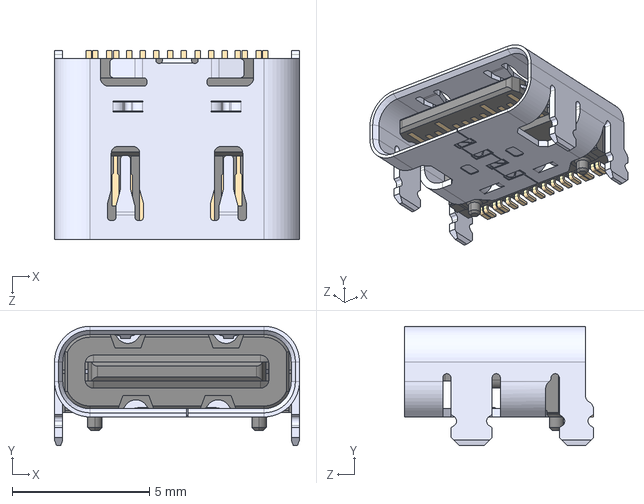
[picture p56: CAD file, 2024-09-05]
DS_models/Connector_USB/DX07S016JA1R1500.step
8.94 x 4.36 x 6.90 mm
