DeepSpace00/DeepSpace-KiCad-Global-Source/DS_models/Diode_SMD/B330B-13-F.STEP

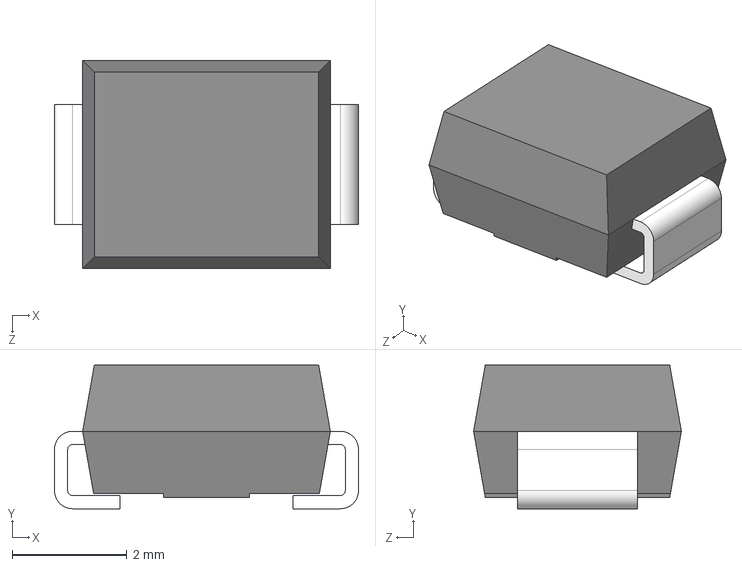
[picture p57: CAD file, 2024-09-05]
DS_models/Diode_SMD/B330B-13-F.STEP
5.30 x 2.50 x 3.62 mm
