DeepSpace00/DeepSpace-KiCad-Global-Source/DS_models/Inductor_SMD/WE-XHMI-1090.STEP

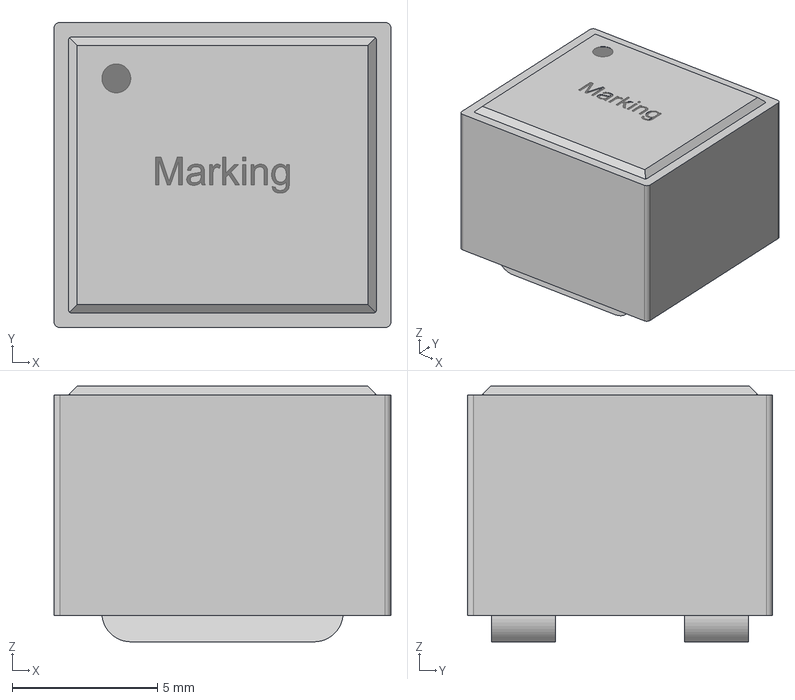
[picture p58: CAD file, 2025-04-04]
DS_models/Inductor_SMD/WE-XHMI-1090.STEP
11.6 x 10.5 x 8.80 mm
