DeepSpace00/DeepSpace-KiCad-Global-Source/DS_models/LED_SMD/OF-SMD3528WC--3DModel-STEP-269445.STEP

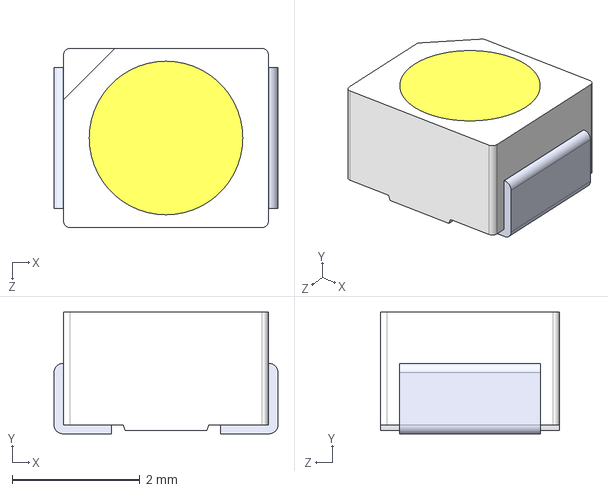
[picture p59: CAD file, 2024-09-05]
DS_models/LED_SMD/OF-SMD3528WC--3DModel-STEP-269445.STEP
3.50 x 1.90 x 2.80 mm
