DeepSpace00/DeepSpace-KiCad-Global-Source/DS_models/Package_QFN/IC57_RP2040.step

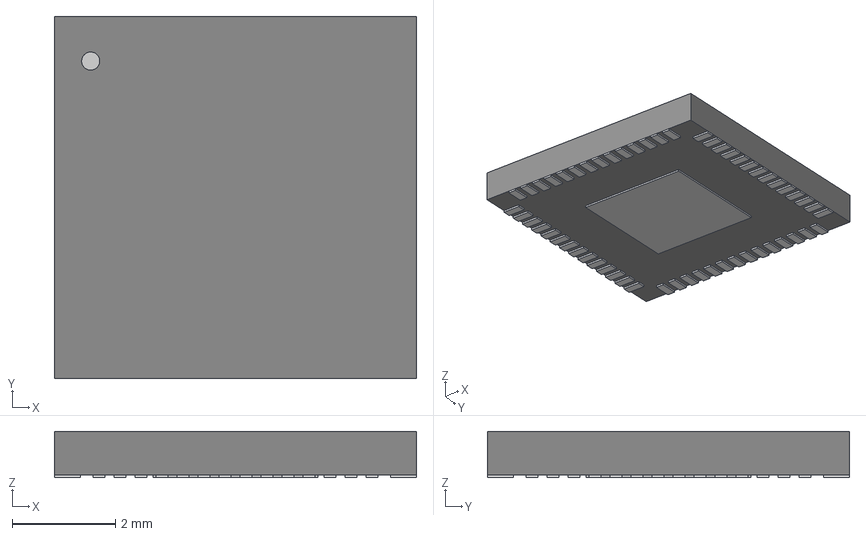
[picture p60: CAD file, 2024-09-05]
DS_models/Package_QFN/IC57_RP2040.step
7.01 x 7.01 x 0.892 mm
