DeepSpace00/DeepSpace-KiCad-Global-Source/DS_models/Package_SO/W25Q128JVSIQTR.STEP

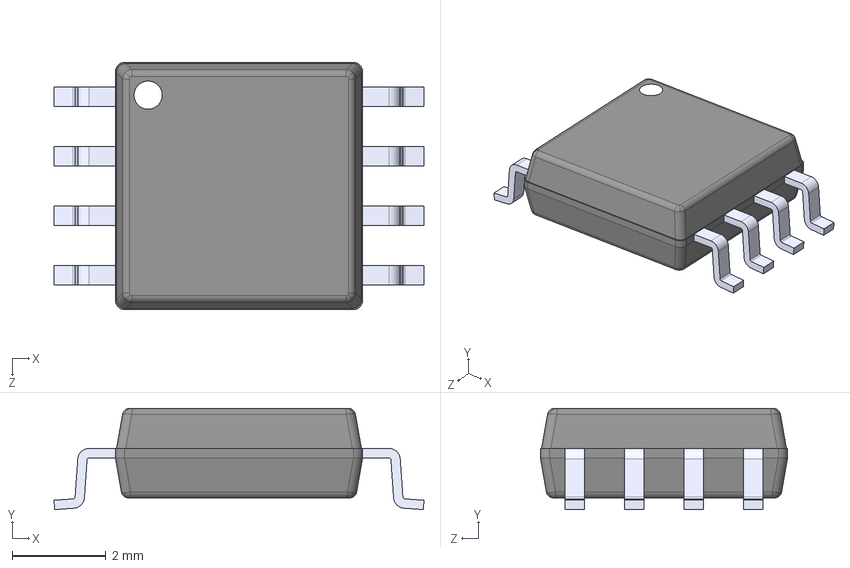
[picture p61: CAD file, 2024-09-05]
DS_models/Package_SO/W25Q128JVSIQTR.STEP
7.90 x 2.16 x 5.28 mm
