DeepSpace00/DeepSpace-KiCad-Global-Source/DS_models/Package_TO_SOT_SMD/AP2112K-3.3TRG1--3DModel-STEP-1.STEP

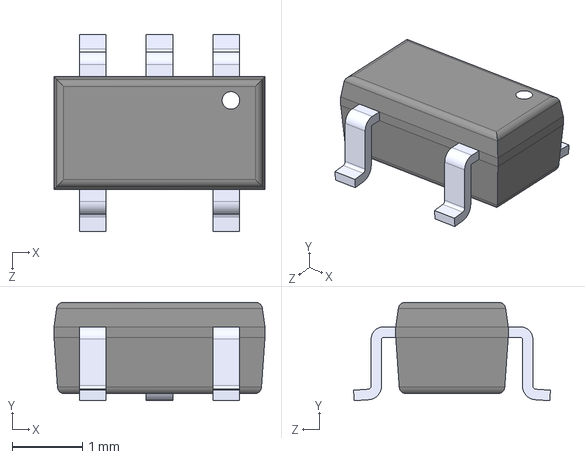
[picture p62: CAD file, 2024-09-05]
DS_models/Package_TO_SOT_SMD/AP2112K-3.3TRG1--3DModel-STEP-1.STEP
3.00 x 1.40 x 2.80 mm
