DeepSpace00/DeepSpace-KiCad-Global-Source/DS_models/Resistor_SMD/WSL0612.STEP

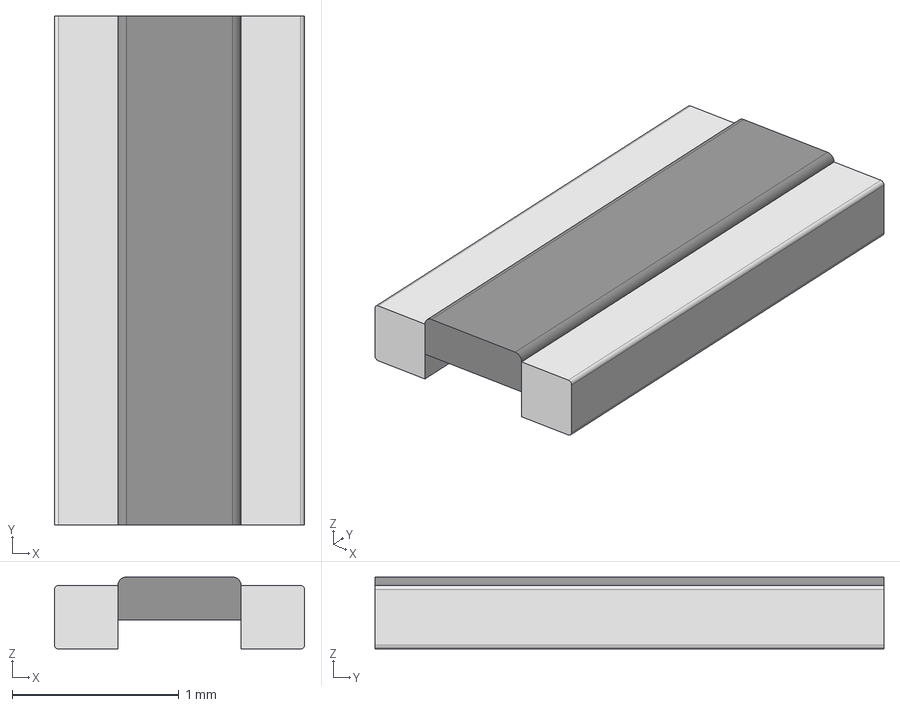
[picture p63: CAD file, 2024-12-22]
DS_models/Resistor_SMD/WSL0612.STEP
1.50 x 3.05 x 0.431 mm
