DeepSpace00/DeepSpace-KiCad-Global-Source/DS_models/Sensors_Environmental/BME280--3DModel-STEP-56544.STEP

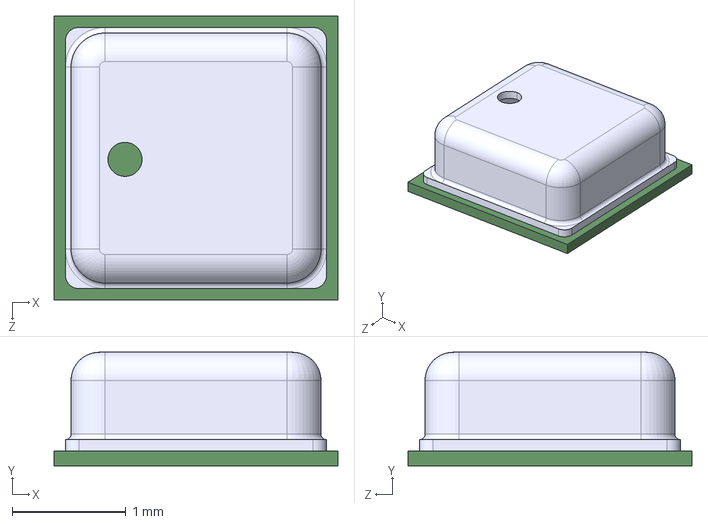
[picture p64: CAD file, 2024-09-05]
DS_models/Sensors_Environmental/BME280--3DModel-STEP-56544.STEP
2.50 x 1.00 x 2.50 mm
