DeepSpace00/DeepSpace-KiCad-Global-Source/DS_models/Sensors_Inertial/LSM6DS3TR--3DModel-STEP-56544.STEP

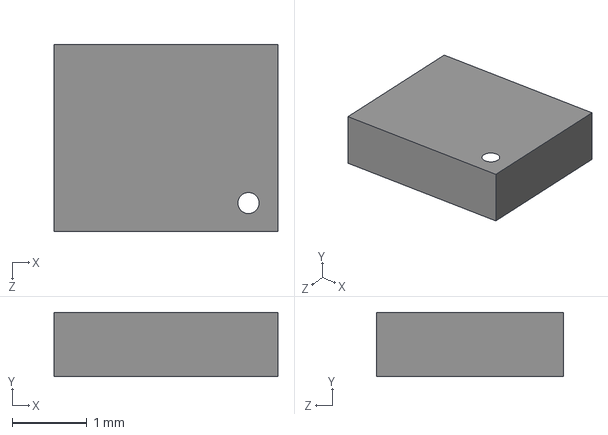
[picture p65: CAD file, 2024-09-05]
DS_models/Sensors_Inertial/LSM6DS3TR--3DModel-STEP-56544.STEP
3.00 x 0.86 x 2.50 mm
