DeepSpace00/DeepSpace-KiCad-Global-Source/DS_models/Breakout_Board/xiaoRP2040_with_pins.stp

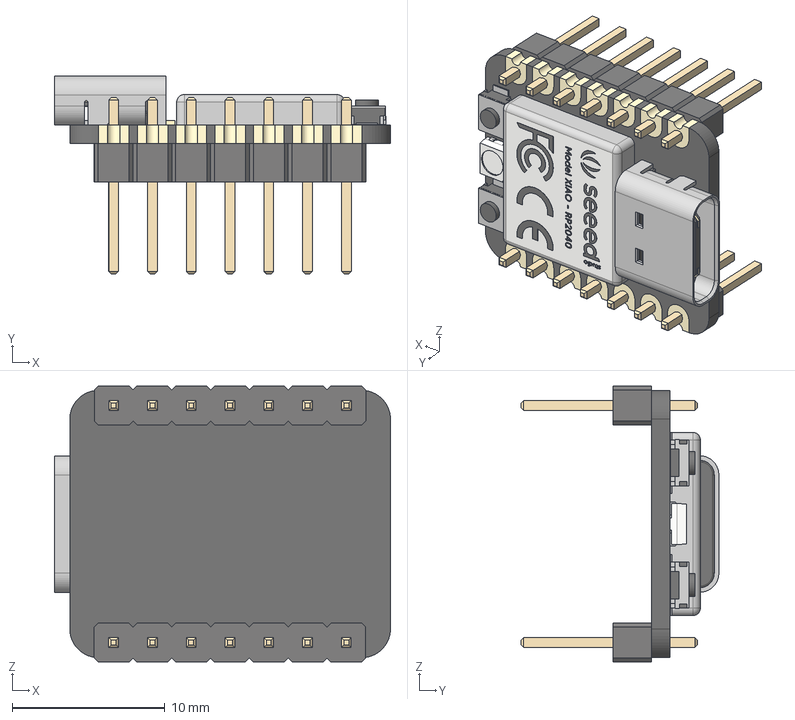
[picture p66: CAD file, 2024-09-05]
DS_models/Breakout_Board/xiaoRP2040_with_pins.stp
22.0 x 12.9 x 18.1 mm
type-c v2
smd_button v3
DOUT
DIN
VSS
VDD
smd_button v3(Mirror)
PinHeader_1x07_P254mm_Vertical x 2
