DeepSpace00/DeepSpace-KiCad-Global-Source/DS_models/Button_Switch_SMD/STP_450405020524.stp

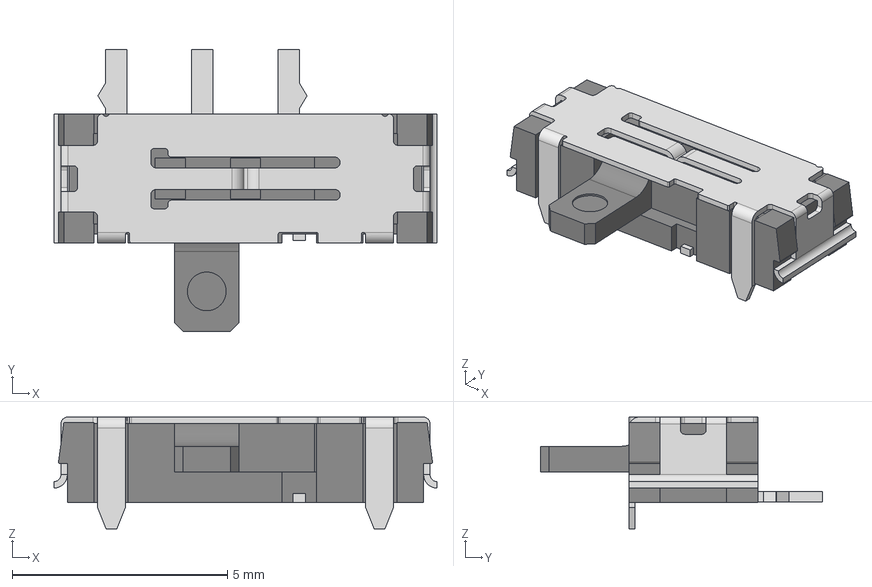
[picture p67: CAD file, 2024-09-05]
DS_models/Button_Switch_SMD/STP_450405020524.stp
8.90 x 6.55 x 2.60 mm
Frame
Cover
Pin 2
Pin 4
Slider 1
Pin 1
Pin 3
Slider
Pin 5
