DeepSpace00/DeepSpace-KiCad-Global-Source/DS_models/Connector_PinHeader_2.54mm/PinHeader_1x18_P2.54mm_Vertical_SMD_Pin1Left.step

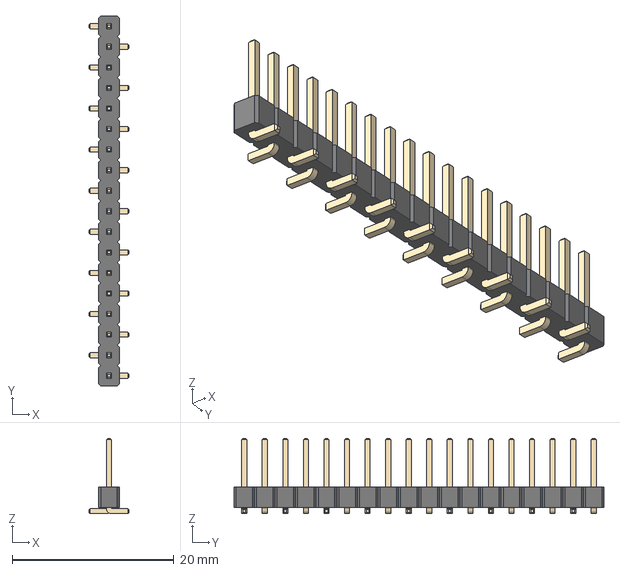
[picture p69: CAD file, 2025-07-27]
DS_models/Connector_PinHeader_2.54mm/PinHeader_1x18_P2.54mm_Vertical_SMD_Pin1Left.step
5.00 x 45.7 x 9.30 mm
