DeepSpace00/DeepSpace-KiCad-Global-Source/DS_models/Connector_pinSocket_2.54mm/C121LFBN-RC.stp

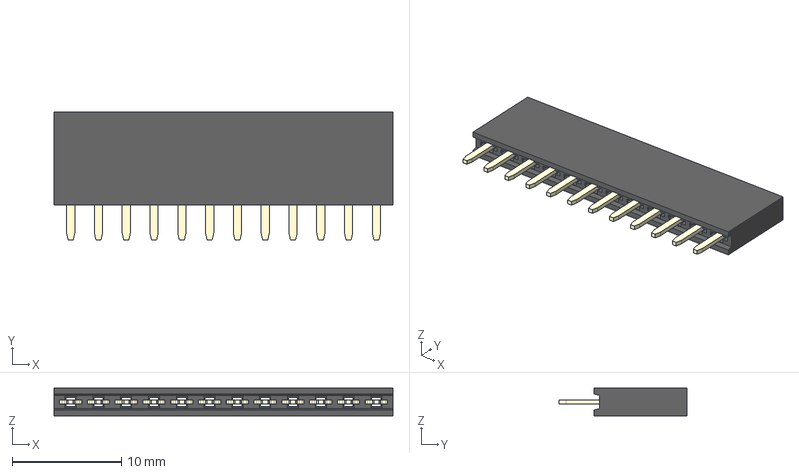
[picture p70: CAD file, 2024-09-05]
DS_models/Connector_pinSocket_2.54mm/C121LFBN-RC.stp
31.0 x 11.7 x 2.54 mm
