DeepSpace00/DeepSpace-KiCad-Global-Source/DS_models/Diode_SMD/T521B105M050ATE200.STEP

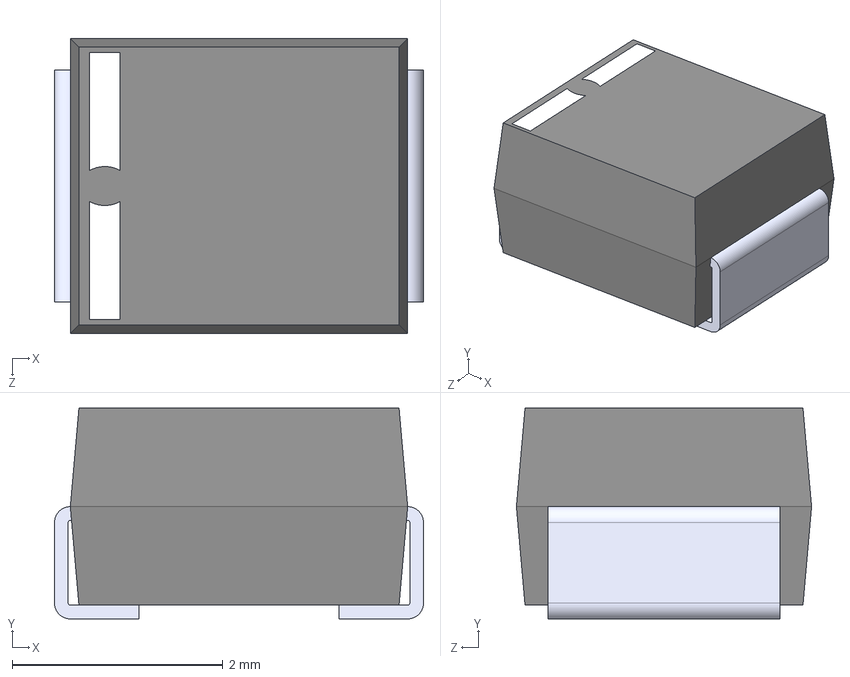
[picture p71: CAD file, 2024-09-05]
DS_models/Diode_SMD/T521B105M050ATE200.STEP
3.50 x 2.00 x 2.80 mm
