DeepSpace00/DeepSpace-KiCad-Global-Source/DS_models/Inductor_SMD/WE-XHMI-8080.STEP

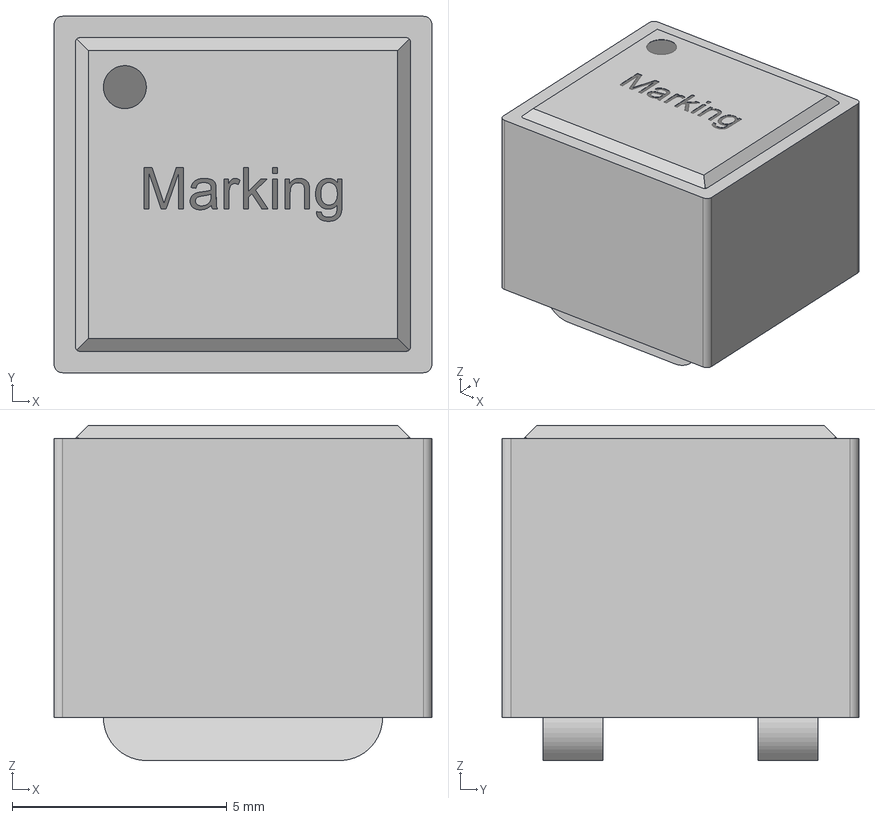
[picture p72: CAD file, 2025-04-04]
DS_models/Inductor_SMD/WE-XHMI-8080.STEP
8.80 x 8.30 x 7.80 mm
