DeepSpace00/DeepSpace-KiCad-Global-Source/DS_models/LED_SMD/LTST-C193TGKT-5A.STEP

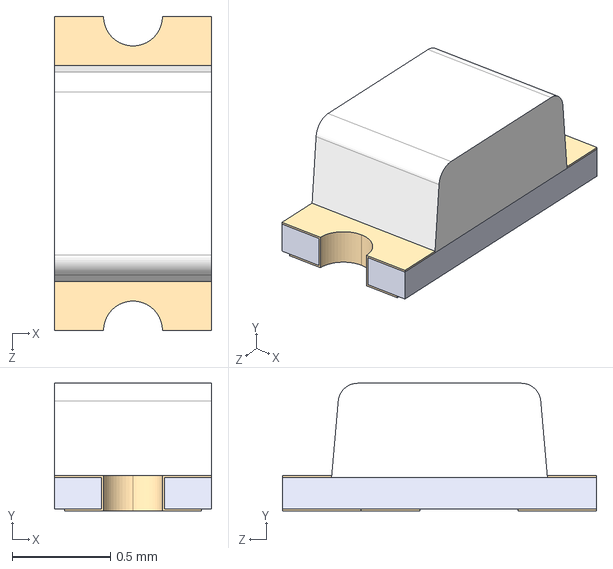
[picture p73: CAD file, 2024-09-05]
DS_models/LED_SMD/LTST-C193TGKT-5A.STEP
0.8 x 0.65 x 1.60 mm
