DeepSpace00/DeepSpace-KiCad-Global-Source/DS_models/Package_QFN/DRV8833CRTET.STEP

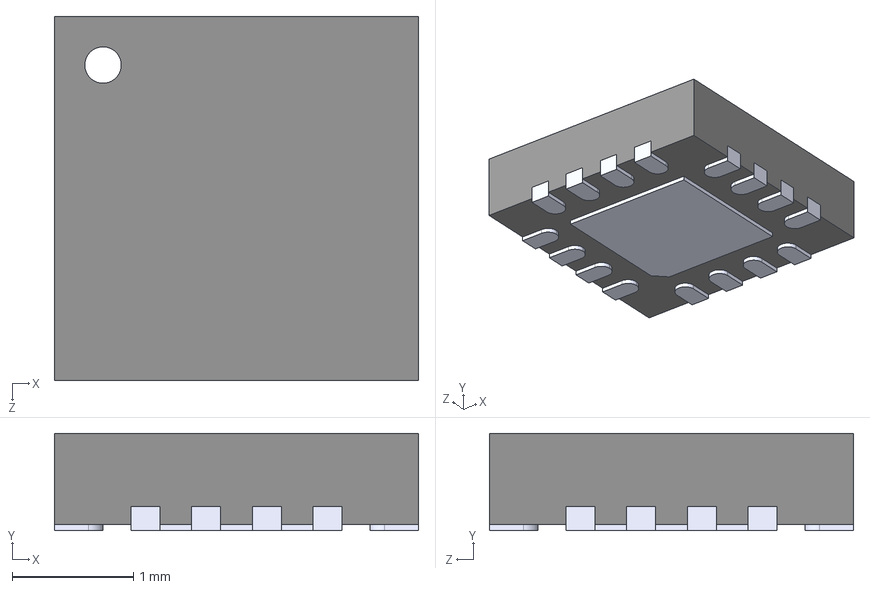
[picture p74: CAD file, 2024-09-05]
DS_models/Package_QFN/DRV8833CRTET.STEP
3.00 x 0.8 x 3.00 mm
