DeepSpace00/DeepSpace-KiCad-Global-Source/DS_models/Package_SO/TL1963A_DCYR.stp

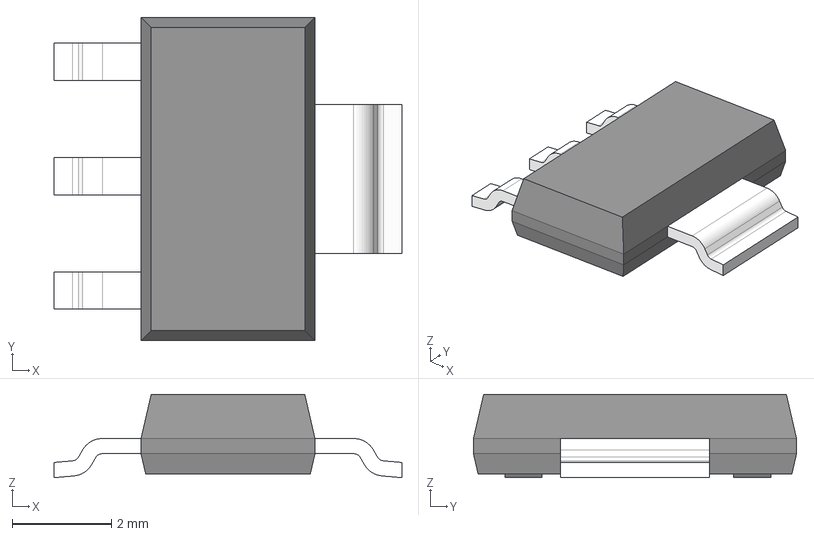
[picture p75: CAD file, 2024-09-05]
DS_models/Package_SO/TL1963A_DCYR.stp
7.00 x 6.50 x 1.68 mm
BODY-SOT
LEAD-SOT x 3
LEAD-SOT-WIDE
PIN1-ID
