DeepSpace00/DeepSpace-KiCad-Global-Source/DS_models/Package_TO_SOT_SMD/IRLML6244TRPBF.STEP

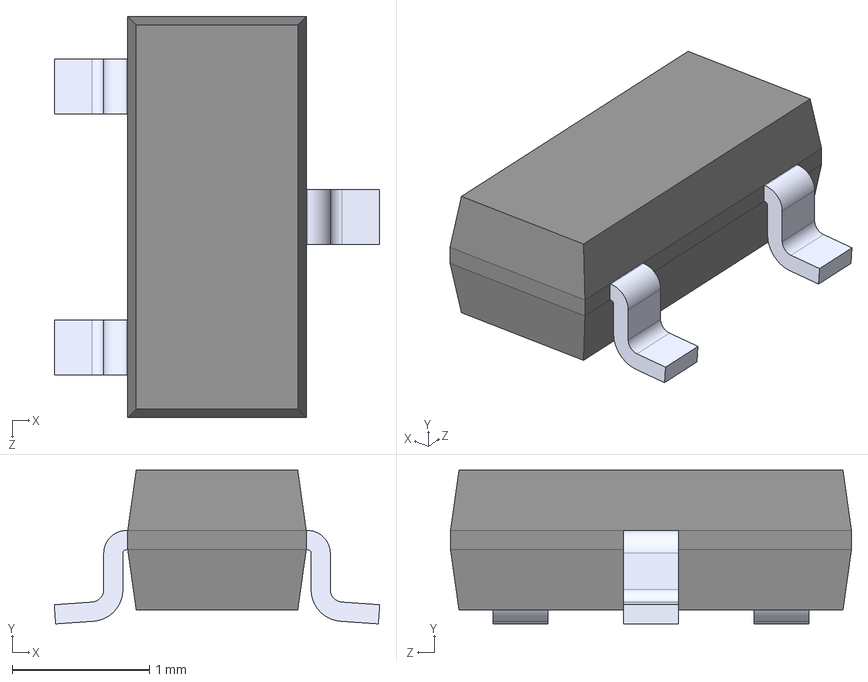
[picture p76: CAD file, 2024-09-05]
DS_models/Package_TO_SOT_SMD/IRLML6244TRPBF.STEP
2.37 x 1.12 x 2.92 mm
