DeepSpace00/DeepSpace-KiCad-Global-Source/DS_models/Sensors_Environmental/BMP388--3DModel-STEP-56544.STEP

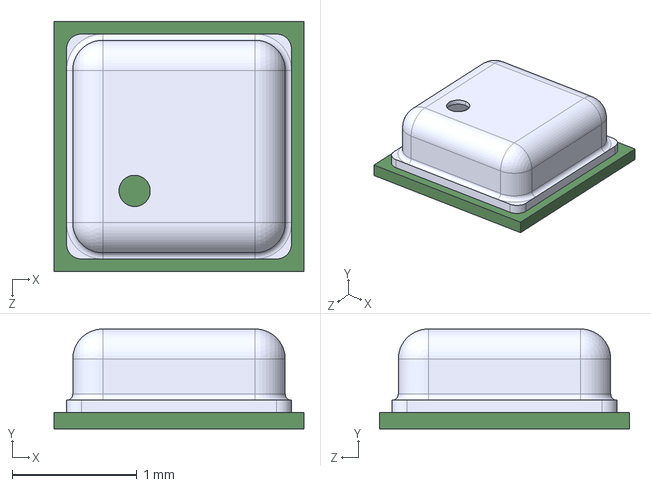
[picture p78: CAD file, 2024-09-05]
DS_models/Sensors_Environmental/BMP388--3DModel-STEP-56544.STEP
2.00 x 0.8 x 2.00 mm
