DeepSpace00/DeepSpace-KiCad-Global-Source/DS_models/1x16ShortHeader.stp

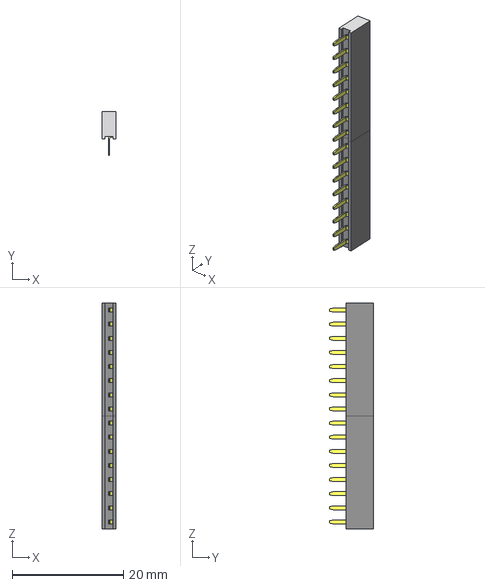
[picture p79: CAD file, 2024-09-05]
DS_models/1x16ShortHeader.stp
2.50 x 8.00 x 40.6 mm
2041-1XxxB_1 x 2
2041-Pin-S_1 x 16
