DeepSpace00/DeepSpace-KiCad-Global-Source/DS_models/Button_Switch_SMD/PTS810-SJK-250-SMTR-LFS.STEP

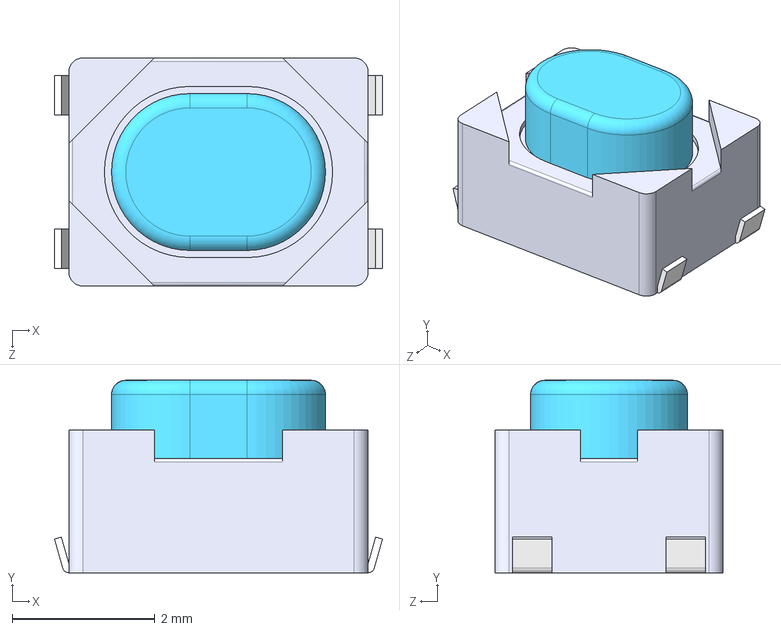
[picture p80: CAD file, 2024-09-05]
DS_models/Button_Switch_SMD/PTS810-SJK-250-SMTR-LFS.STEP
4.60 x 2.70 x 3.20 mm
