DeepSpace00/DeepSpace-KiCad-Global-Source/DS_models/Capacitor_Ceramic_SMD/GRT155R71H104KE01D.STEP

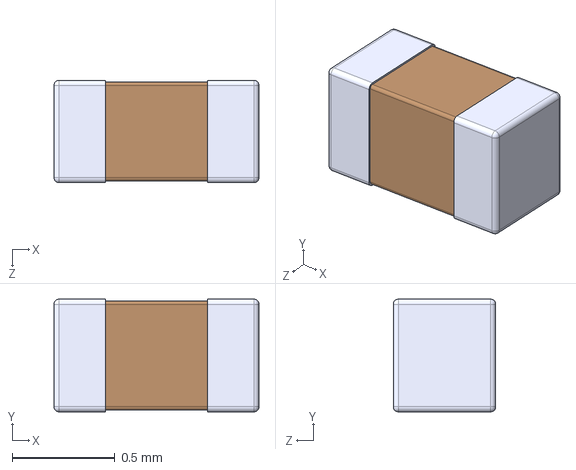
[picture p81: CAD file, 2025-04-04]
DS_models/Capacitor_Ceramic_SMD/GRT155R71H104KE01D.STEP
1.00 x 0.55 x 0.5 mm
