DeepSpace00/DeepSpace-KiCad-Global-Source/DS_models/Connector_JST/JST-XH2-SMD.step

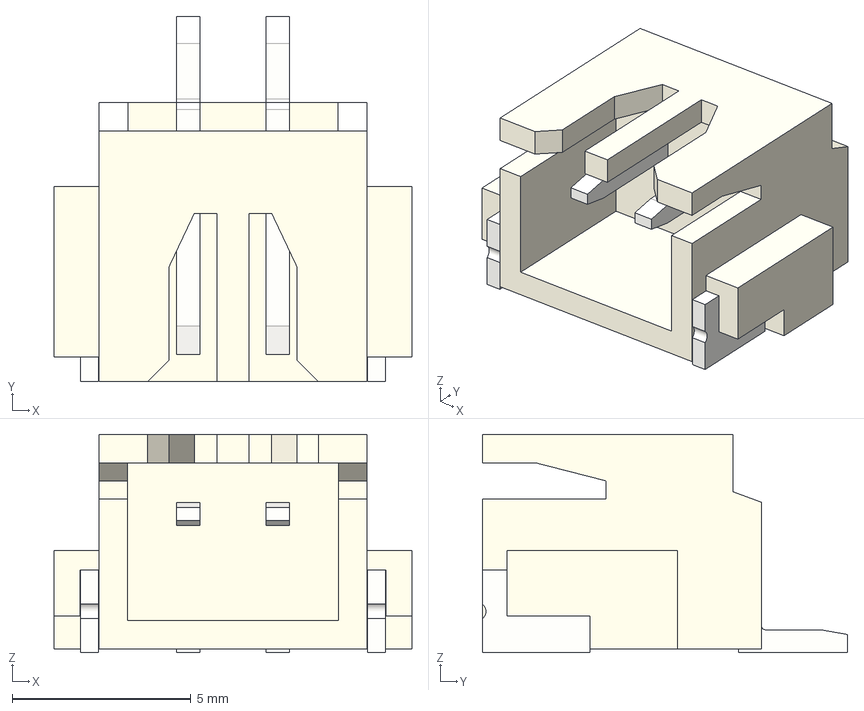
[picture p82: CAD file, 2024-11-03]
DS_models/Connector_JST/JST-XH2-SMD.step
10.0 x 10.2 x 6.10 mm
