DeepSpace00/DeepSpace-KiCad-Global-Source/DS_models/Connector_PinHeader_2.54mm/PinHeader_2x03_P2.54mm_Vertical.step

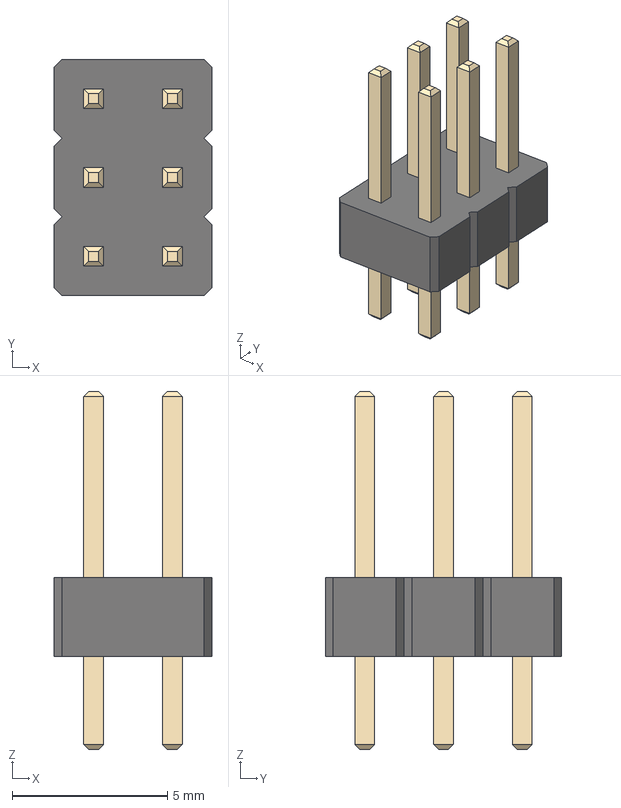
[picture p83: CAD file, 2025-07-27]
DS_models/Connector_PinHeader_2.54mm/PinHeader_2x03_P2.54mm_Vertical.step
5.08 x 7.62 x 11.5 mm
