DeepSpace00/DeepSpace-KiCad-Global-Source/DS_models/Connector_USB/USB-A-S-S-B-SM2-TR.stp

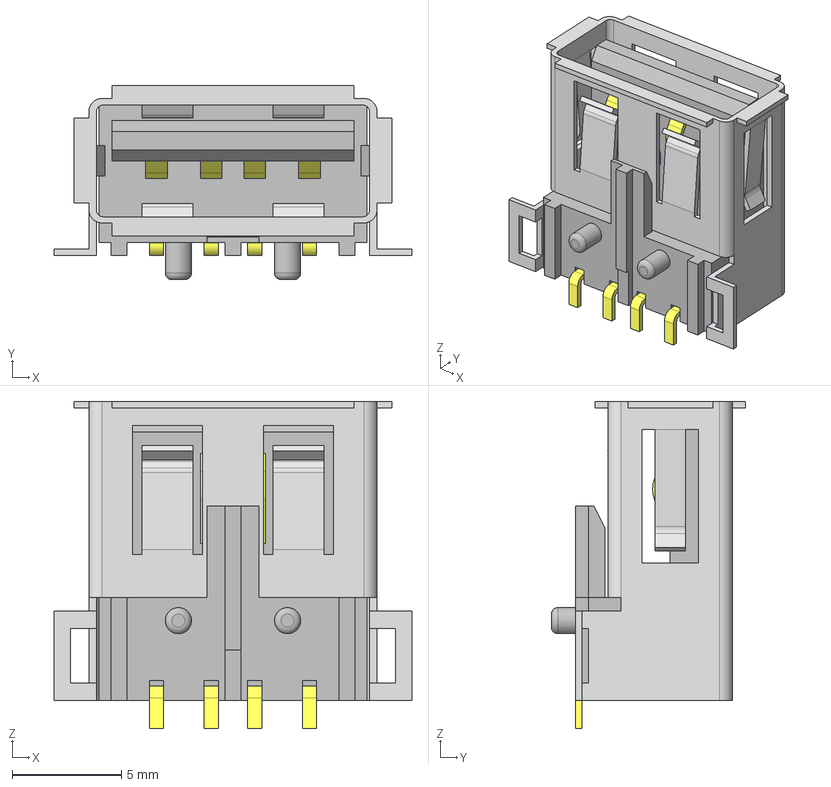
[picture p84: CAD file, 2024-09-05]
DS_models/Connector_USB/USB-A-S-S-B-SM2-TR.stp
16.4 x 8.90 x 15.0 mm
USB-A-S-SM2_S
USB-A-S-B-SM2_B
USB-A-S-SM2_P
