DeepSpace00/DeepSpace-KiCad-Global-Source/DS_models/Diode_SMD/SOD-123.STEP

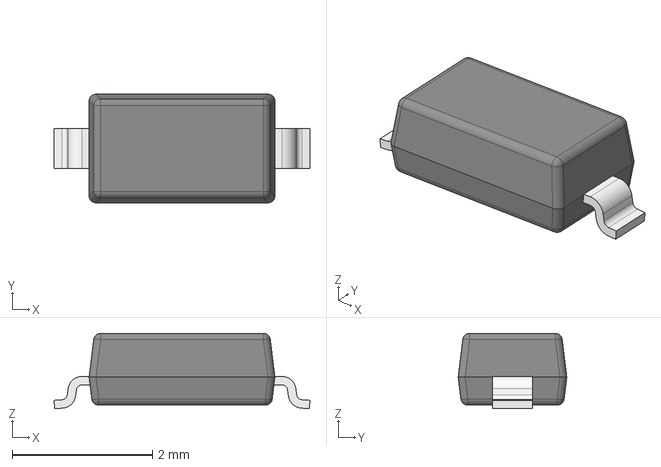
[picture p85: CAD file, 2024-09-05]
DS_models/Diode_SMD/SOD-123.STEP
3.65 x 1.55 x 1.08 mm
CPD
LDF
