DeepSpace00/DeepSpace-KiCad-Global-Source/DS_models/Inductor_SMD/L_0603.STEP

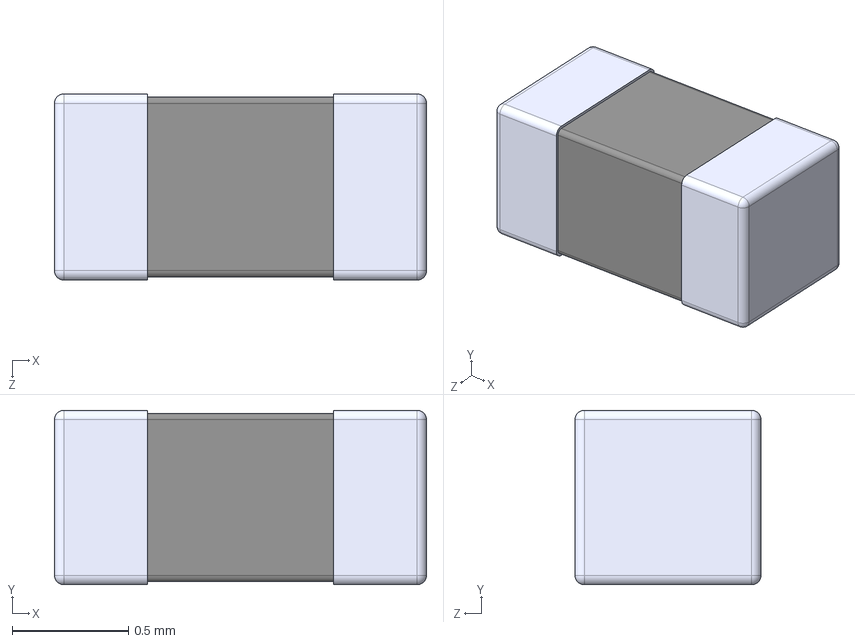
[picture p86: CAD file, 2025-04-04]
DS_models/Inductor_SMD/L_0603.STEP
1.60 x 0.75 x 0.8 mm
