DeepSpace00/DeepSpace-KiCad-Global-Source/DS_models/LED_SMD/User Library-WS2812-2020.step

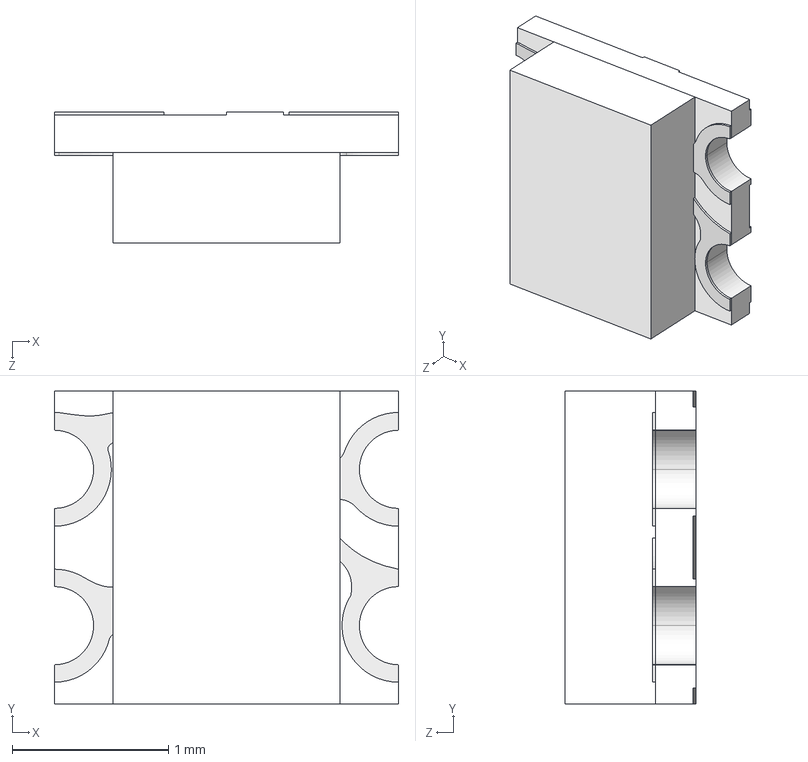
[picture p87: CAD file, 2024-09-05]
DS_models/LED_SMD/User Library-WS2812-2020.step
2.20 x 2.00 x 0.84 mm
