DeepSpace00/DeepSpace-KiCad-Global-Source/DS_models/Package_QFN/RUG0010A.stp

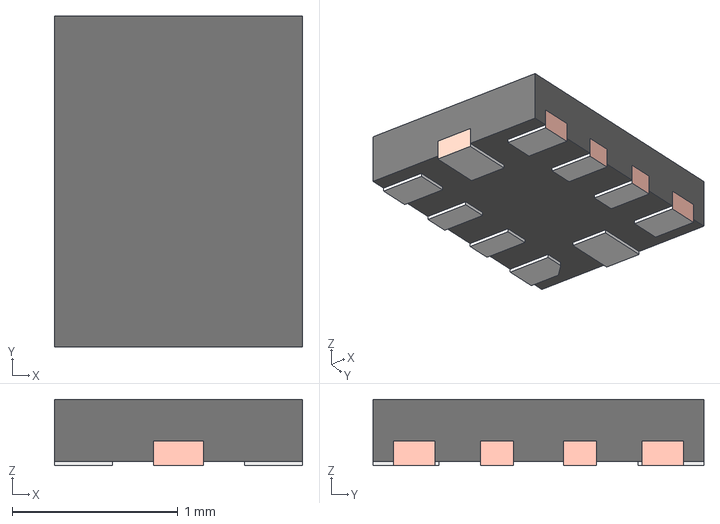
[picture p88: CAD file, 2024-09-05]
DS_models/Package_QFN/RUG0010A.stp
1.50 x 2.00 x 0.4 mm
FRAME_RUG0010A
BODY_RUG0010A
