DeepSpace00/DeepSpace-KiCad-Global-Source/DS_models/Package_TO_SOT_SMD/LP2985-33DBVR.STEP

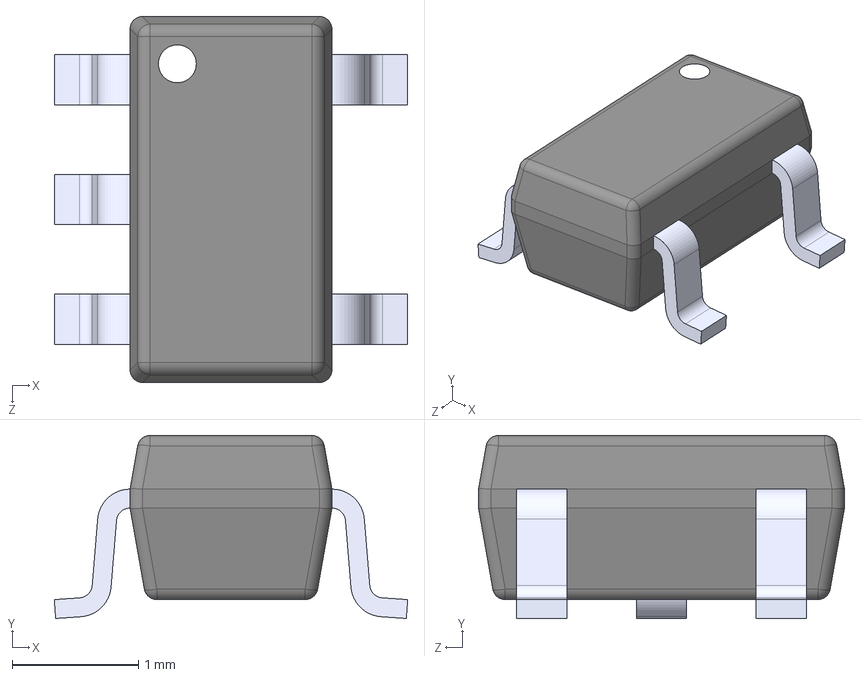
[picture p89: CAD file, 2024-09-05]
DS_models/Package_TO_SOT_SMD/LP2985-33DBVR.STEP
2.80 x 1.45 x 2.90 mm
