DeepSpace00/DeepSpace-KiCad-Global-Source/DS_models/Resistor_SMD/WSK2512 (0.001 to 0.0049).STEP

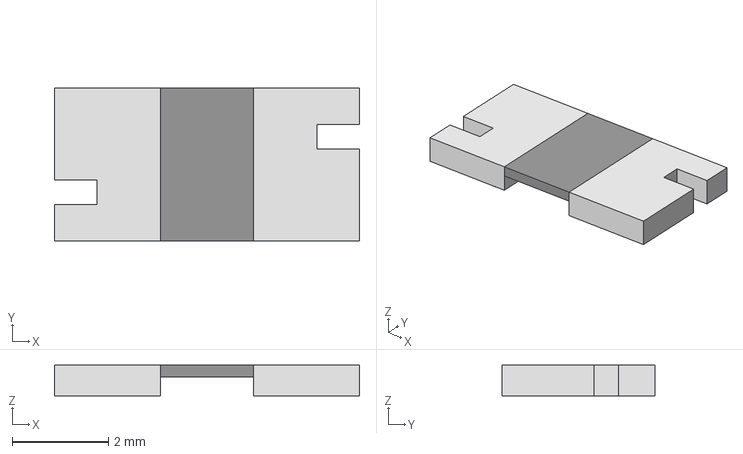
[picture p90: CAD file, 2024-11-28]
DS_models/Resistor_SMD/WSK2512 (0.001 to 0.0049).STEP
6.35 x 3.18 x 0.635 mm
