DeepSpace00/DeepSpace-KiCad-Global-Source/DS_models/Sensors_Environmental/ENS160.stp

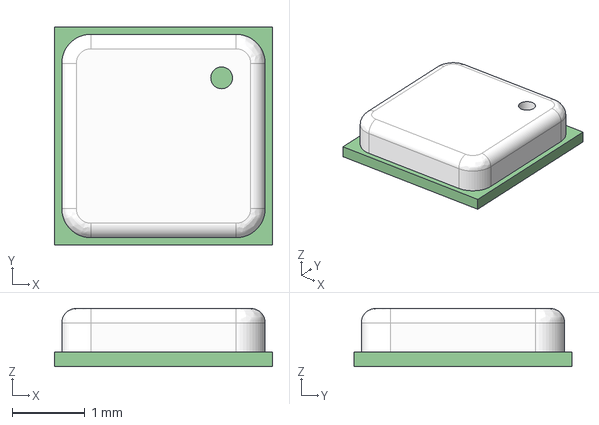
[picture p91: CAD file, 2024-09-05]
DS_models/Sensors_Environmental/ENS160.stp
3.00 x 3.00 x 0.8 mm
