DeepSpace00/DeepSpace-KiCad-Global-Source/DS_models/Button_Switch_SMD/SS-12F44.stp

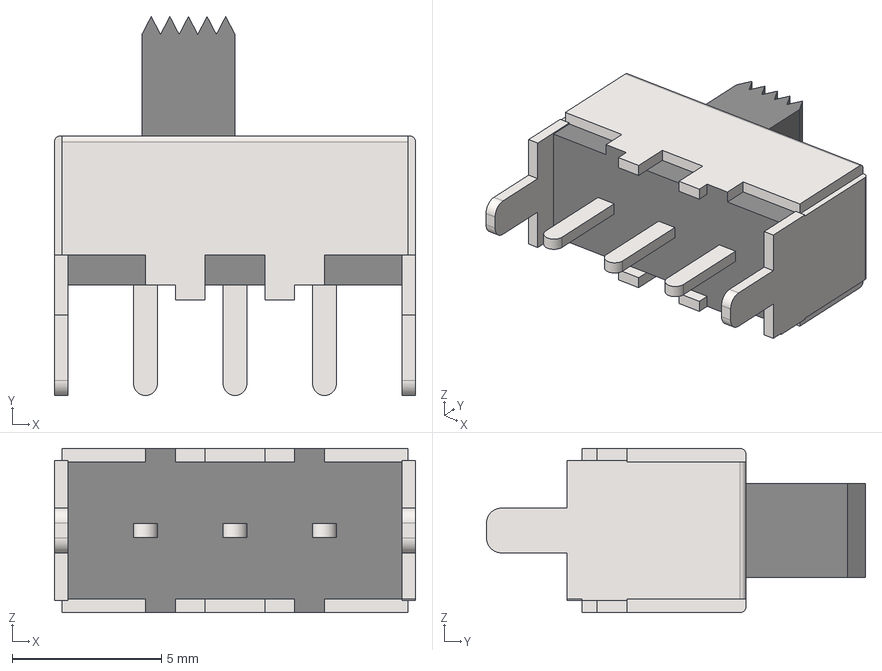
[picture p92: CAD file, 2024-09-05]
DS_models/Button_Switch_SMD/SS-12F44.stp
12.1 x 12.7 x 5.50 mm
