DeepSpace00/DeepSpace-KiCad-Global-Source/DS_models/Capacitor_Ceramic_SMD/GRT188R71E105KE13D.STEP

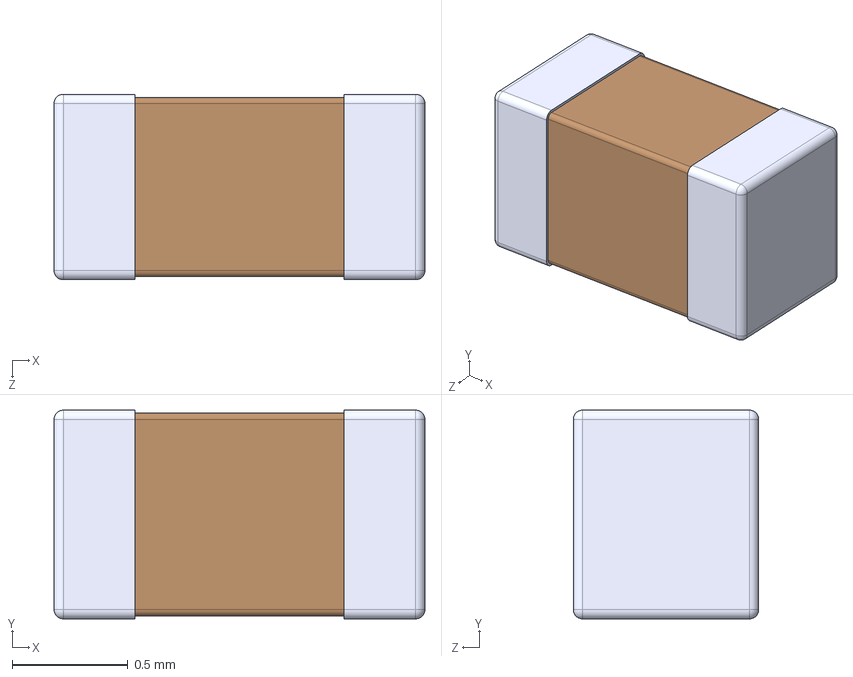
[picture p93: CAD file, 2025-04-04]
DS_models/Capacitor_Ceramic_SMD/GRT188R71E105KE13D.STEP
1.60 x 0.9 x 0.8 mm
