DeepSpace00/DeepSpace-KiCad-Global-Source/DS_models/Connector_PinHeader_2.54mm/PinHeader_1x34_P2.54mm_Vertical.step

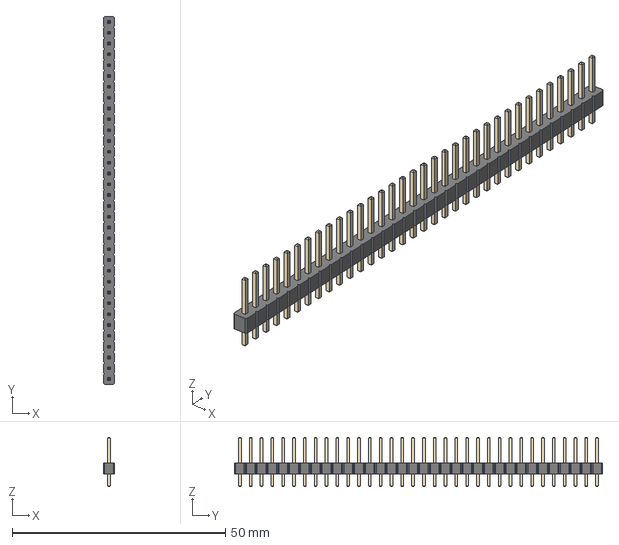
[picture p95: CAD file, 2025-07-27]
DS_models/Connector_PinHeader_2.54mm/PinHeader_1x34_P2.54mm_Vertical.step
2.54 x 86.4 x 11.5 mm
