DeepSpace00/DeepSpace-KiCad-Global-Source/DS_models/Diode_SMD/B340A-13-F.STEP

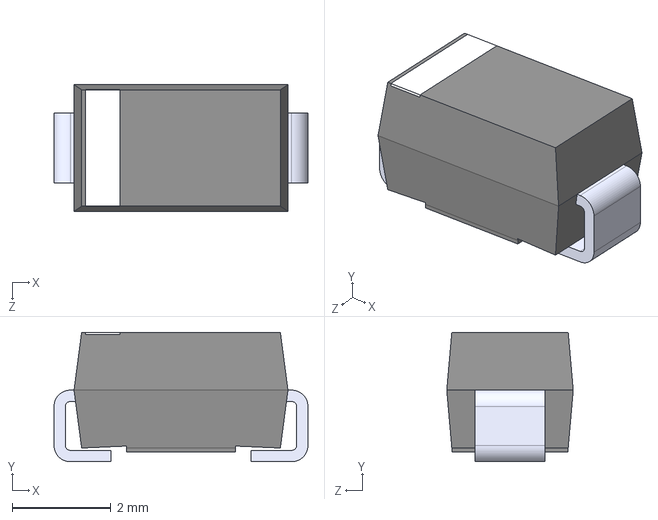
[picture p96: CAD file, 2024-09-05]
DS_models/Diode_SMD/B340A-13-F.STEP
5.14 x 2.62 x 2.56 mm
