DeepSpace00/DeepSpace-KiCad-Global-Source/DS_models/Inductor_SMD/WE-XHMI-1510.STEP

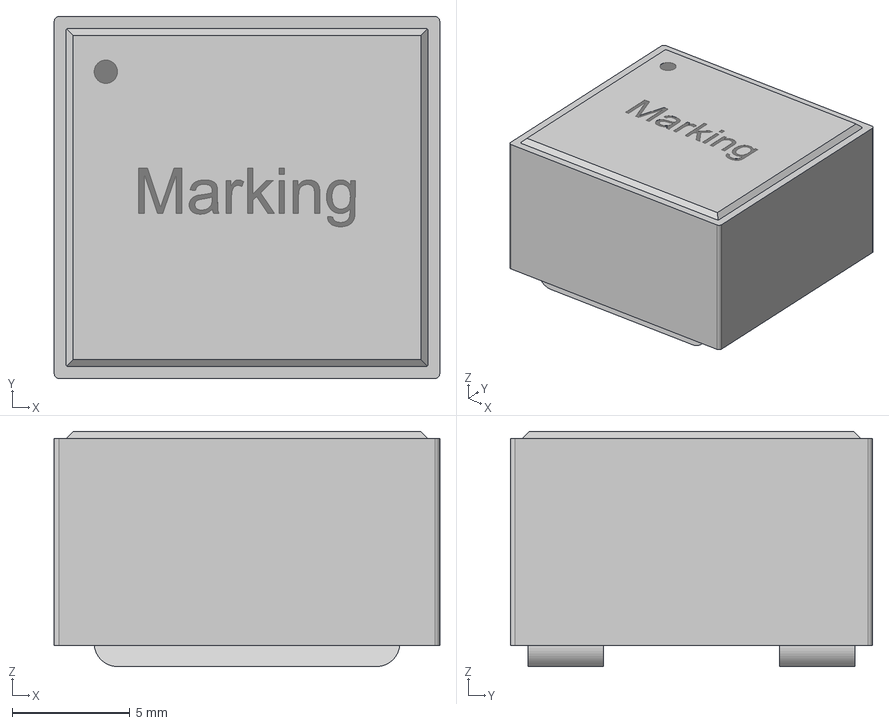
[picture p97: CAD file, 2025-04-04]
DS_models/Inductor_SMD/WE-XHMI-1510.STEP
16.4 x 15.4 x 10.0 mm
