DeepSpace00/DeepSpace-KiCad-Global-Source/DS_models/LED_SMD/IPIXELSK6805-E-J_ADA.step

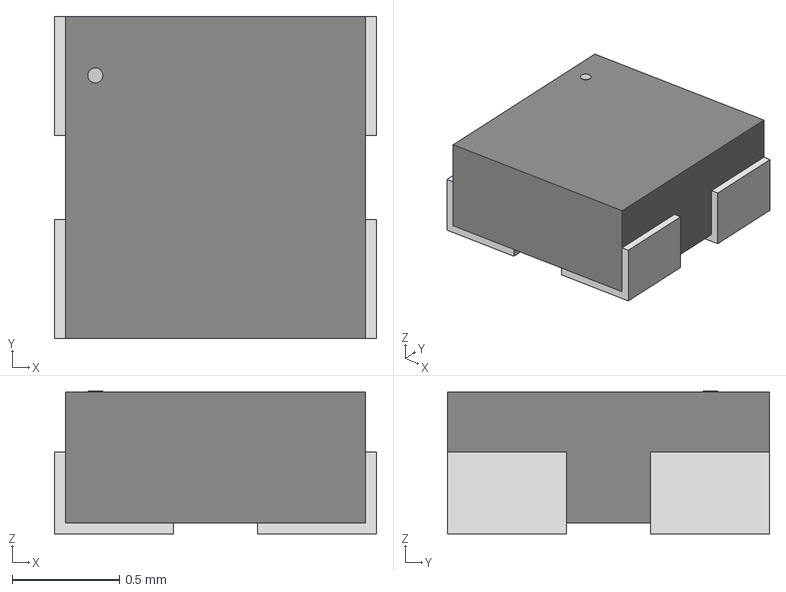
[picture p98: CAD file, 2024-09-05]
DS_models/LED_SMD/IPIXELSK6805-E-J_ADA.step
1.50 x 1.50 x 0.663 mm
