DeepSpace00/DeepSpace-KiCad-Global-Source/DS_models/Package_QFN/QFN-24_UF_LIT.step

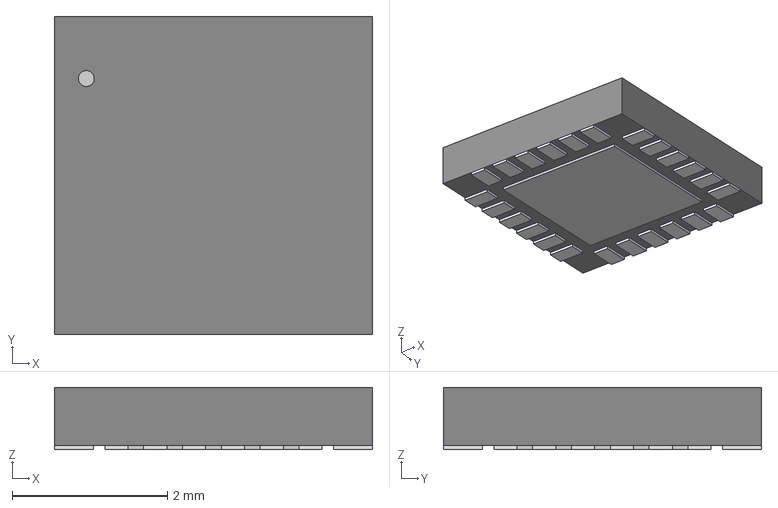
[picture p99: CAD file, 2024-09-05]
DS_models/Package_QFN/QFN-24_UF_LIT.step
4.10 x 4.10 x 0.803 mm
