DeepSpace00/DeepSpace-KiCad-Global-Source/DS_models/Package_SO/SOD323.stp

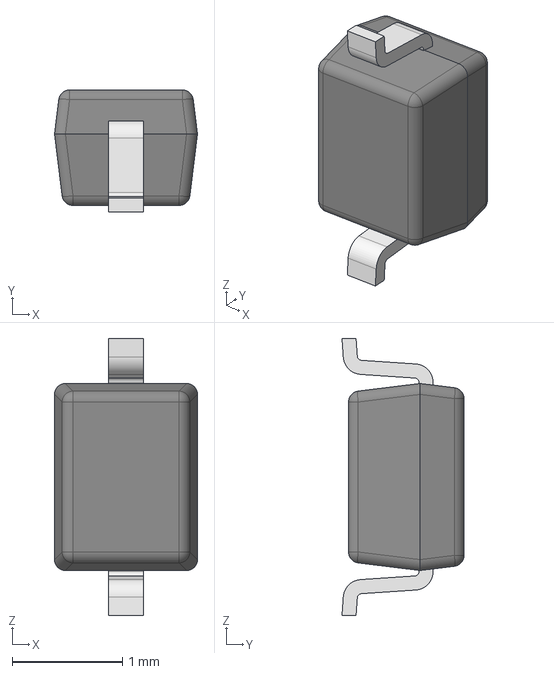
[picture p100: CAD file, 2024-09-05]
DS_models/Package_SO/SOD323.stp
1.30 x 1.11 x 2.52 mm
SOD323-PCB-001
SOD323-LP-001
