DeepSpace00/DeepSpace-KiCad-Global-Source/DS_models/Package_TO_SOT_SMD/BSS138 RFG--3DModel-STEP-269445.STEP

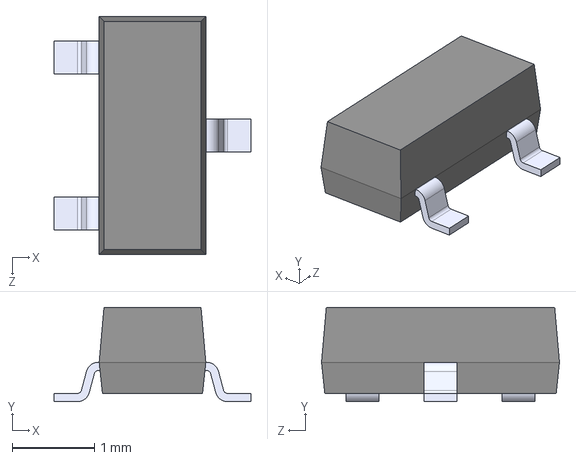
[picture p101: CAD file, 2024-09-05]
DS_models/Package_TO_SOT_SMD/BSS138 RFG--3DModel-STEP-269445.STEP
2.40 x 1.15 x 2.90 mm
