DeepSpace00/DeepSpace-KiCad-Global-Source/DS_models/Resistor_SMD/WSK2512 (0.0005 to 0.00099).STEP

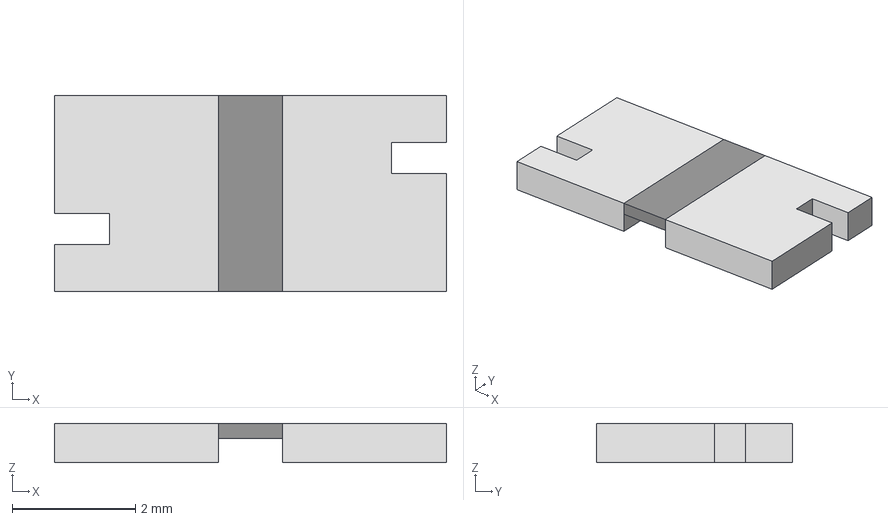
[picture p102: CAD file, 2024-11-28]
DS_models/Resistor_SMD/WSK2512 (0.0005 to 0.00099).STEP
6.35 x 3.18 x 0.635 mm
