DeepSpace00/DeepSpace-KiCad-Global-Source/DS_models/Capacitor_Ceramic_SMD/KAM0402.STEP

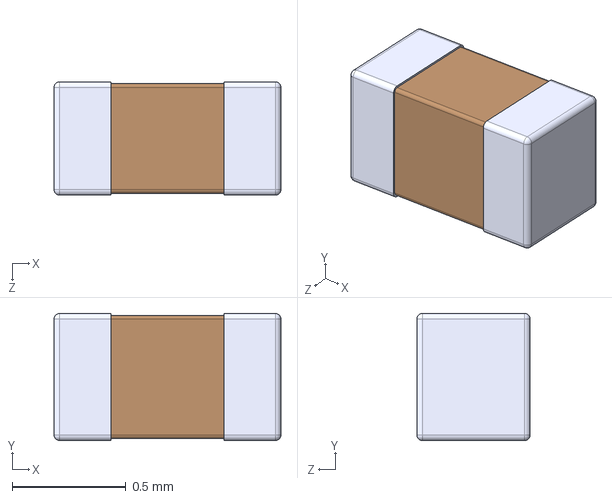
[picture p103: CAD file, 2024-11-22]
DS_models/Capacitor_Ceramic_SMD/KAM0402.STEP
1.00 x 0.56 x 0.5 mm
