DeepSpace00/DeepSpace-KiCad-Global-Source/DS_models/Connector_JST/BM04B-SRSS-TB-LF--SN---3DModel-STEP-56544.STEP

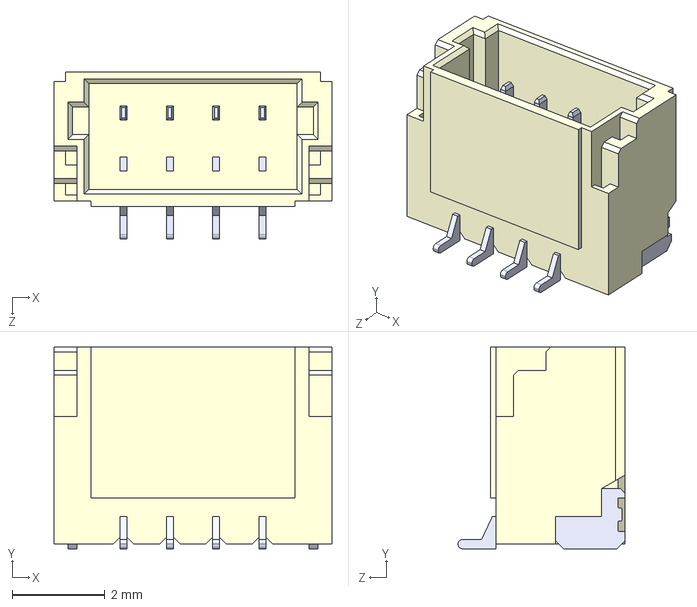
[picture p104: CAD file, 2024-09-05]
DS_models/Connector_JST/BM04B-SRSS-TB-LF--SN---3DModel-STEP-56544.STEP
6.00 x 4.35 x 3.60 mm
