DeepSpace00/DeepSpace-KiCad-Global-Source/DS_models/Diode_SMD/DSS14UTR.STEP

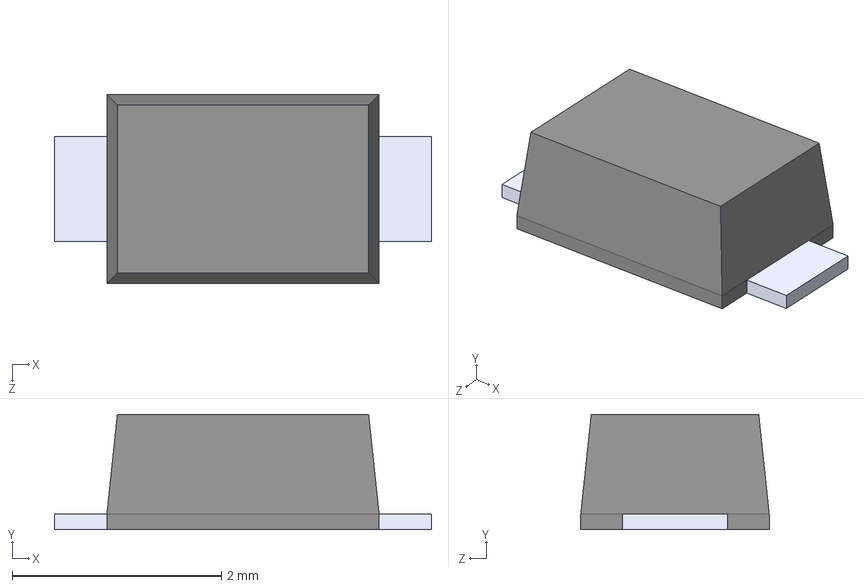
[picture p106: CAD file, 2024-09-05]
DS_models/Diode_SMD/DSS14UTR.STEP
3.60 x 1.10 x 1.80 mm
