DeepSpace00/DeepSpace-KiCad-Global-Source/DS_models/Inductor_SMD/WE-XHMI-4030.STEP

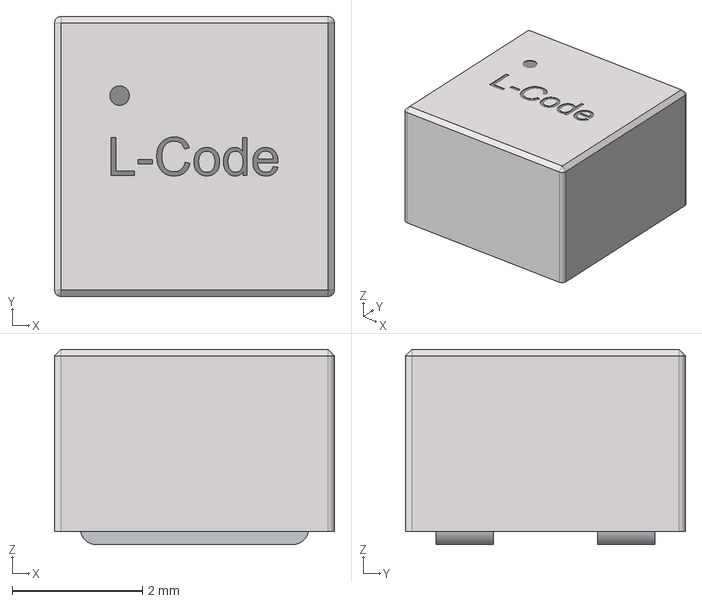
[picture p107: CAD file, 2025-04-04]
DS_models/Inductor_SMD/WE-XHMI-4030.STEP
4.30 x 4.30 x 3.00 mm
