DeepSpace00/DeepSpace-KiCad-Global-Source/DS_models/LED_SMD/WS2812B-B--3DModel-STEP-56544.STEP

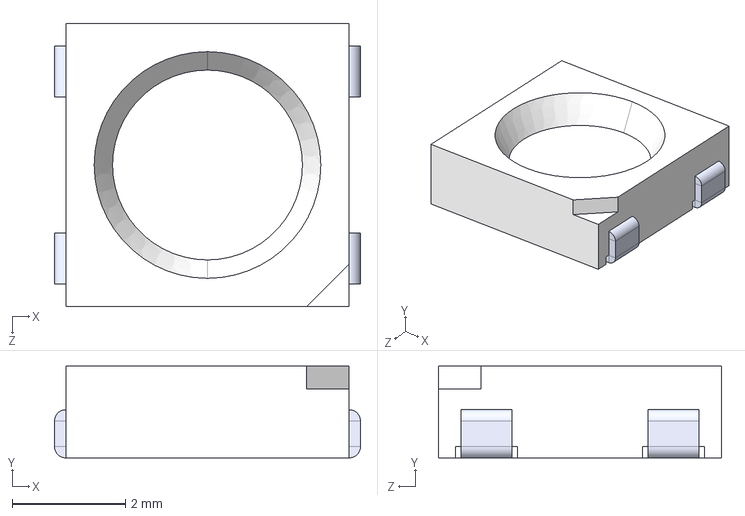
[picture p108: CAD file, 2024-09-05]
DS_models/LED_SMD/WS2812B-B--3DModel-STEP-56544.STEP
5.40 x 1.62 x 5.00 mm
