DeepSpace00/DeepSpace-KiCad-Global-Source/DS_models/Package_QFN/ADS7142IRUGR.STEP

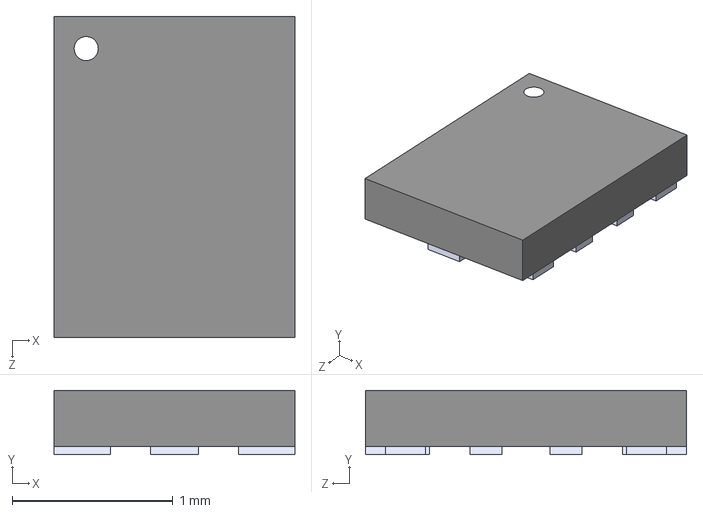
[picture p109: CAD file, 2024-09-05]
DS_models/Package_QFN/ADS7142IRUGR.STEP
1.50 x 0.4 x 2.00 mm
