DeepSpace00/DeepSpace-KiCad-Global-Source/DS_models/Package_SO/SP0503BAHTG--3DModel-STEP-56544.STEP

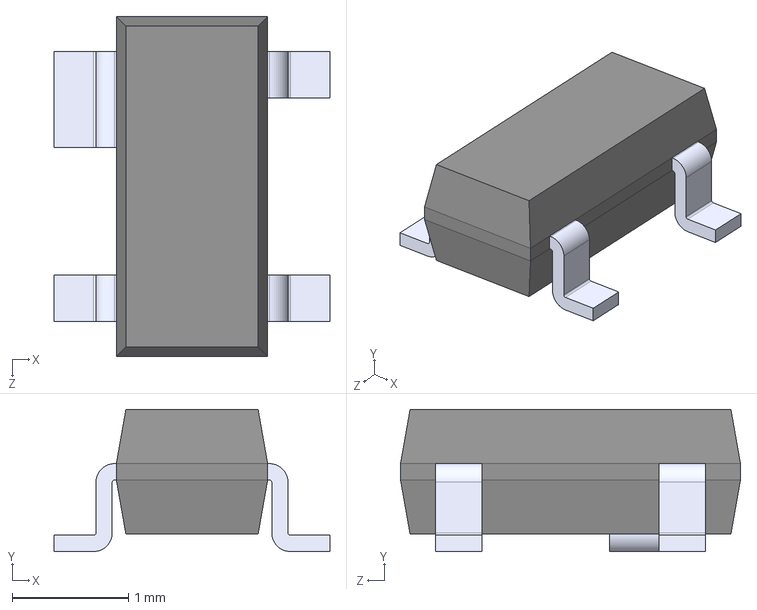
[picture p110: CAD file, 2024-09-05]
DS_models/Package_SO/SP0503BAHTG--3DModel-STEP-56544.STEP
2.37 x 1.22 x 2.92 mm
