DeepSpace00/DeepSpace-KiCad-Global-Source/DS_models/QTPY-RP2040_Headers.stp

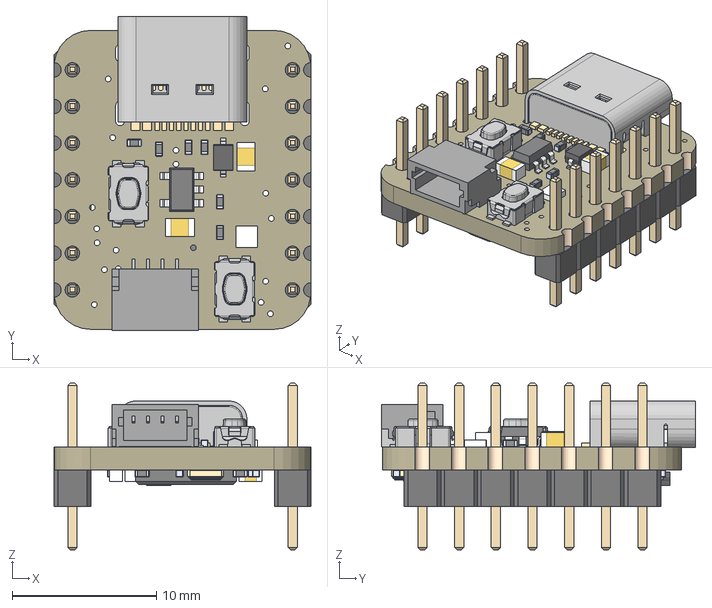
[picture p111: CAD file, 2024-09-05]
DS_models/QTPY-RP2040_Headers.stp
17.8 x 21.8 x 11.5 mm
4900 QTPY-RP2040
PinHeader_1x07_P254mm_Vertical x 2
