DeepSpace00/DeepSpace-KiCad-Global-Source/DS_models/Resistor_SMD/D12-CRCW0805.STEP

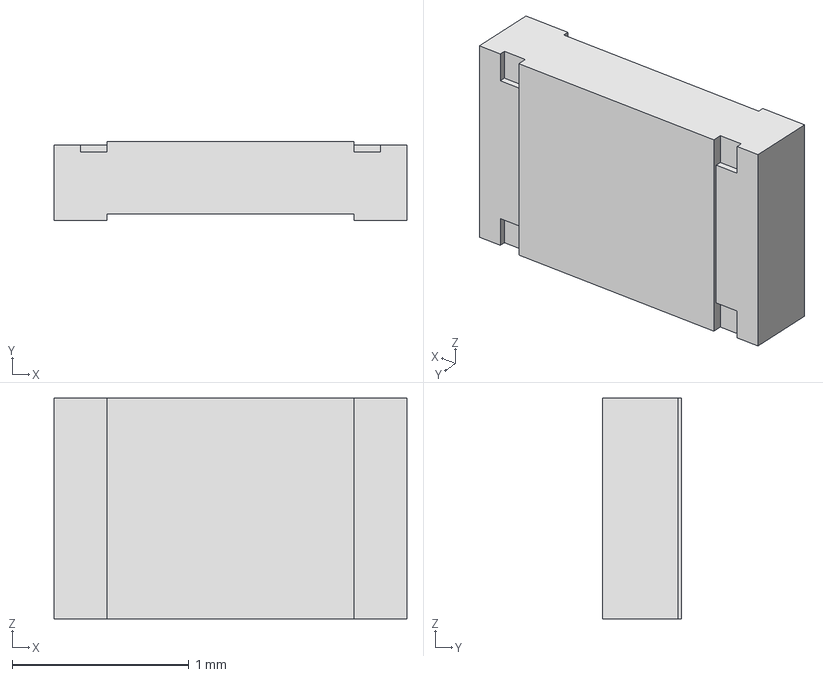
[picture p112: CAD file, 2024-11-03]
DS_models/Resistor_SMD/D12-CRCW0805.STEP
2.00 x 0.45 x 1.25 mm
