DeepSpace00/DeepSpace-KiCad-Global-Source/DS_models/Capacitor_Ceramic_SMD/KAM1210.STEP

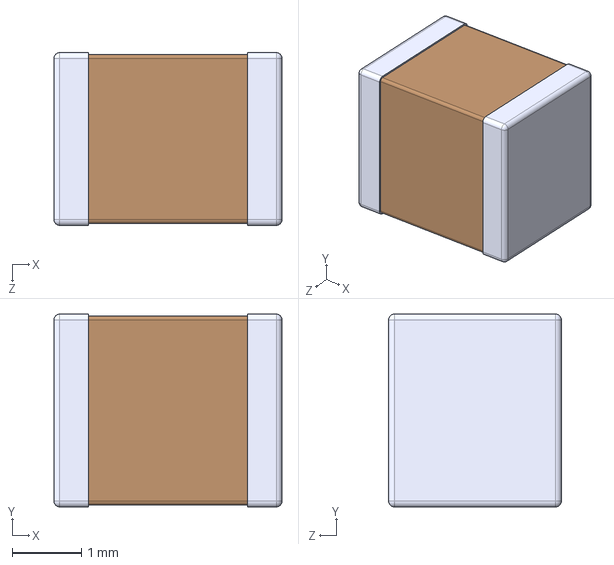
[picture p113: CAD file, 2024-11-03]
DS_models/Capacitor_Ceramic_SMD/KAM1210.STEP
3.30 x 2.79 x 2.50 mm
