DeepSpace00/DeepSpace-KiCad-Global-Source/DS_models/Connector_JST/S4B-PH-SM4-TB--3DModel-STEP-56544.STEP

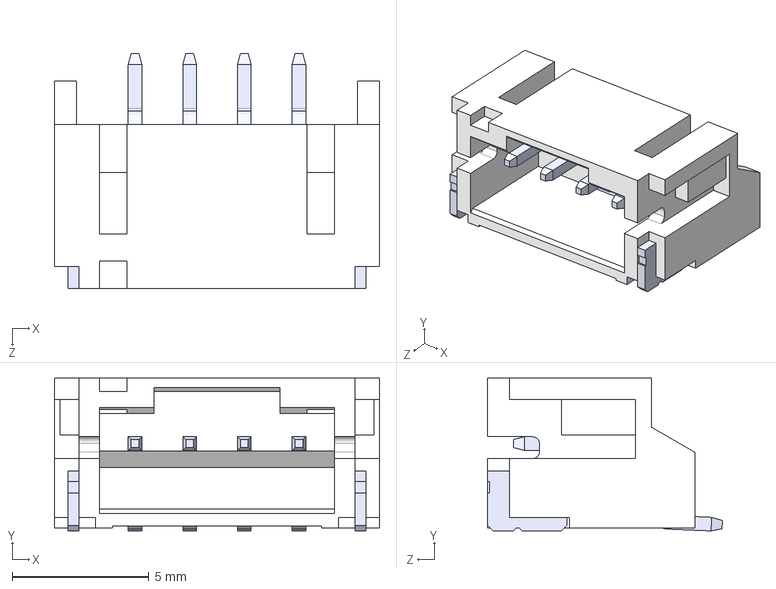
[picture p114: CAD file, 2024-09-05]
DS_models/Connector_JST/S4B-PH-SM4-TB--3DModel-STEP-56544.STEP
11.9 x 5.60 x 8.60 mm
