DeepSpace00/DeepSpace-KiCad-Global-Source/DS_models/Inductor_SMD/IND_IHHP-1008AB-01_VIS.step

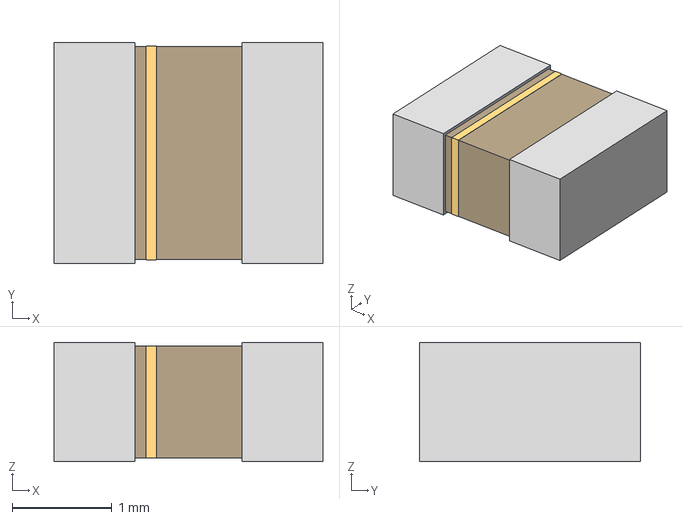
[picture p116: CAD file, 2024-09-05]
DS_models/Inductor_SMD/IND_IHHP-1008AB-01_VIS.step
2.69 x 2.21 x 1.19 mm
