DeepSpace00/DeepSpace-KiCad-Global-Source/DS_models/Package_SO/DBZ0003A.stp

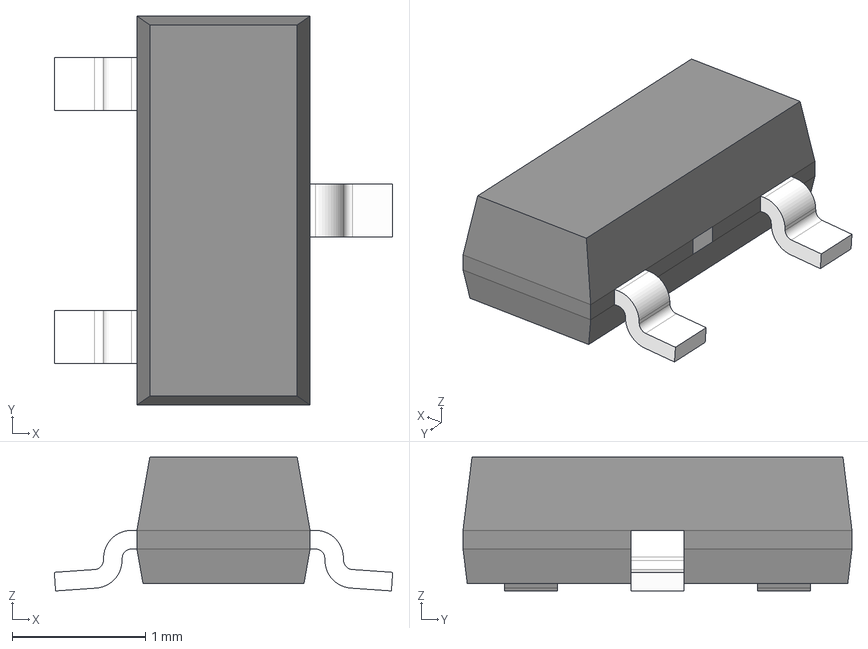
[picture p117: CAD file, 2024-09-05]
DS_models/Package_SO/DBZ0003A.stp
2.54 x 2.92 x 1.01 mm
BODY-SOT
LEAD-SOT x 3
PIN1-ID
TIEBAR
