DeepSpace00/DeepSpace-KiCad-Global-Source/DS_models/Package_TO_SOT_SMD/AP7313-18SAG-7.STEP

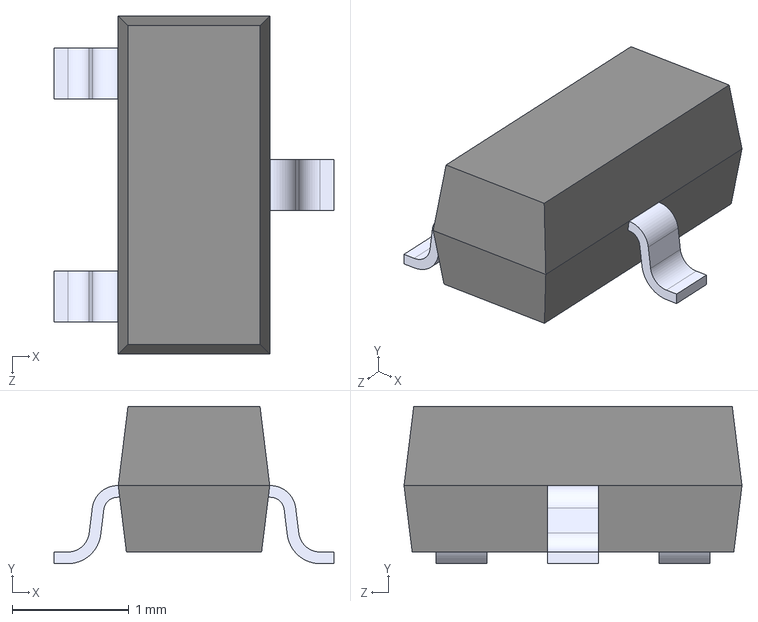
[picture p118: CAD file, 2024-09-05]
DS_models/Package_TO_SOT_SMD/AP7313-18SAG-7.STEP
2.40 x 1.35 x 2.90 mm
