DeepSpace00/DeepSpace-KiCad-Global-Source/DS_models/Resistor_SMD/WSL1206-18-0_002-to-0_0059.STEP

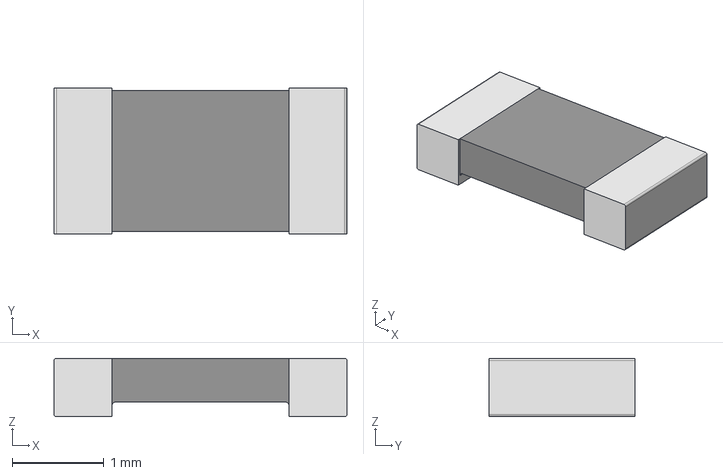
[picture p119: CAD file, 2024-11-03]
DS_models/Resistor_SMD/WSL1206-18-0_002-to-0_0059.STEP
3.20 x 1.60 x 0.635 mm
