DeepSpace00/DeepSpace-KiCad-Global-Source/DS_models/Capacitor_Ceramic_SMD/KGM0805.STEP

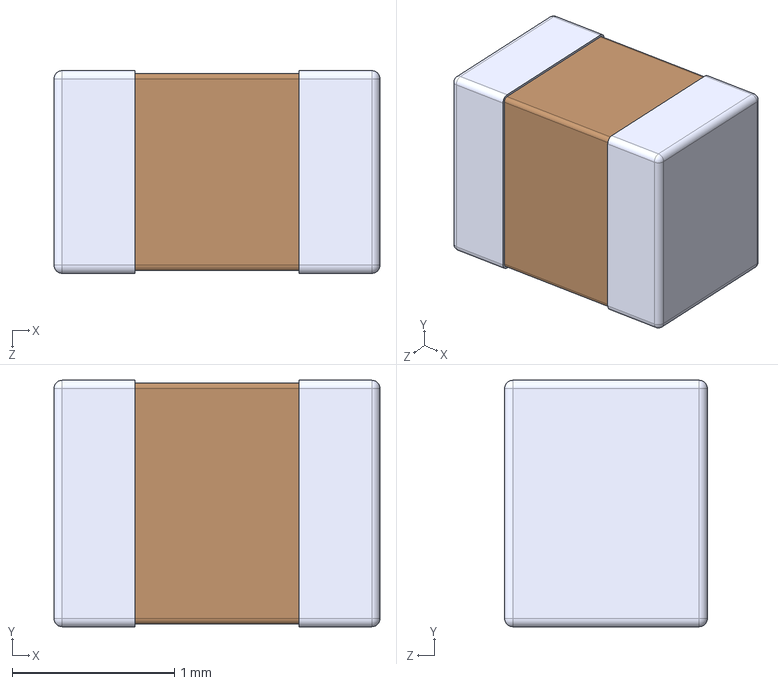
[picture p120: CAD file, 2024-11-03]
DS_models/Capacitor_Ceramic_SMD/KGM0805.STEP
2.01 x 1.52 x 1.25 mm
