DeepSpace00/DeepSpace-KiCad-Global-Source/DS_models/Connector_JST/SM04B-SRSS-TB(LF)(SN)--3DModel-STEP-56544.STEP

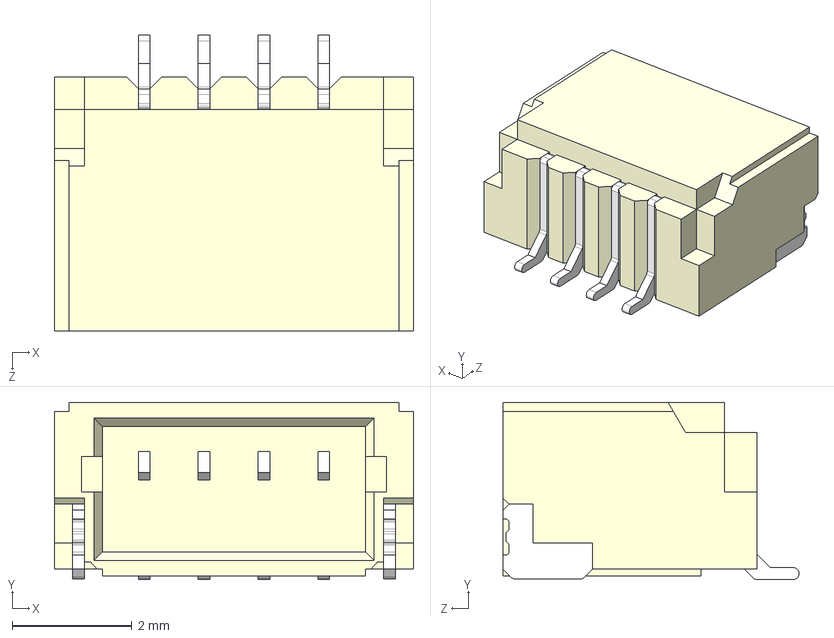
[picture p121: CAD file, 2024-09-05]
DS_models/Connector_JST/SM04B-SRSS-TB(LF)(SN)--3DModel-STEP-56544.STEP
6.00 x 2.96 x 4.95 mm
