DeepSpace00/DeepSpace-KiCad-Global-Source/DS_models/Connector_PinHeader_2.54mm/PinHeader_2x30_P2.54mm_Vertical.step

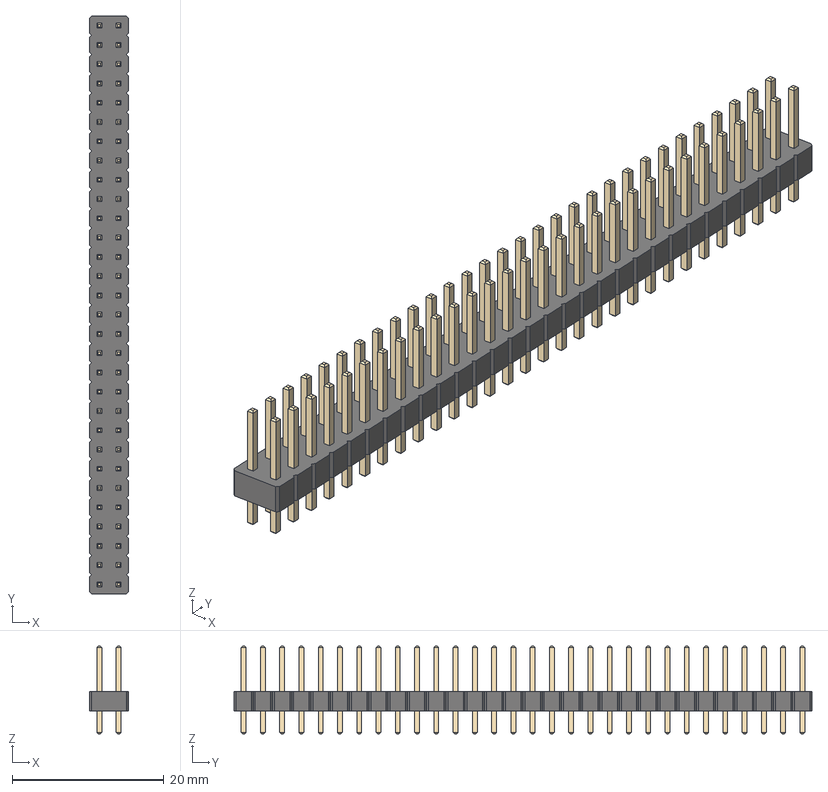
[picture p122: CAD file, 2025-07-27]
DS_models/Connector_PinHeader_2.54mm/PinHeader_2x30_P2.54mm_Vertical.step
5.08 x 76.2 x 11.5 mm
