DeepSpace00/DeepSpace-KiCad-Global-Source/DS_models/Inductor_SMD/DR74-2R2-R--3DModel-STEP-56544.STEP

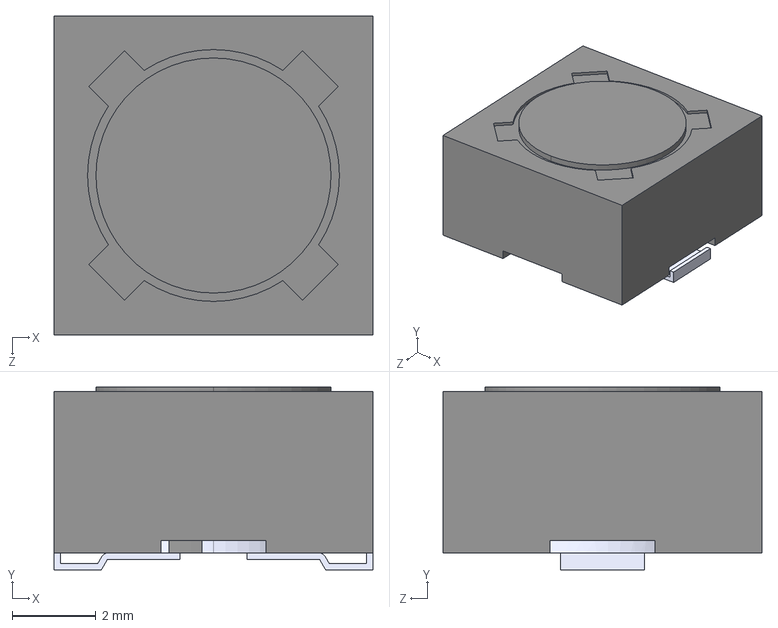
[picture p123: CAD file, 2024-09-05]
DS_models/Inductor_SMD/DR74-2R2-R--3DModel-STEP-56544.STEP
7.60 x 4.35 x 7.60 mm
