DeepSpace00/DeepSpace-KiCad-Global-Source/DS_models/Package_SO/W25Q80DVSSIG.stp

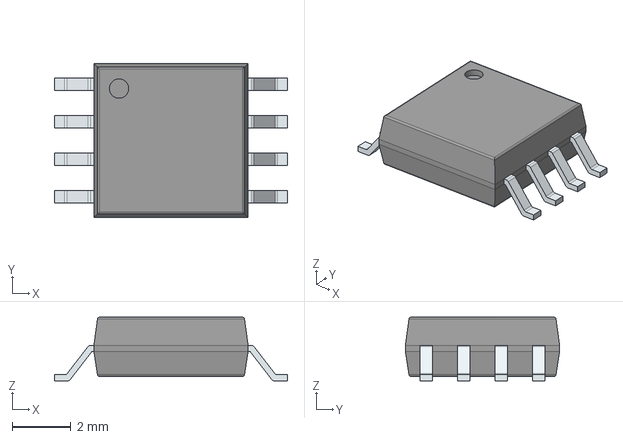
[picture p124: CAD file, 2024-09-05]
DS_models/Package_SO/W25Q80DVSSIG.stp
7.90 x 5.23 x 2.16 mm
PinsArrayLR
