DeepSpace00/DeepSpace-KiCad-Global-Source/DS_models/Package_TO_SOT_SMD/SOT363_1P3X2P15_DIO.step

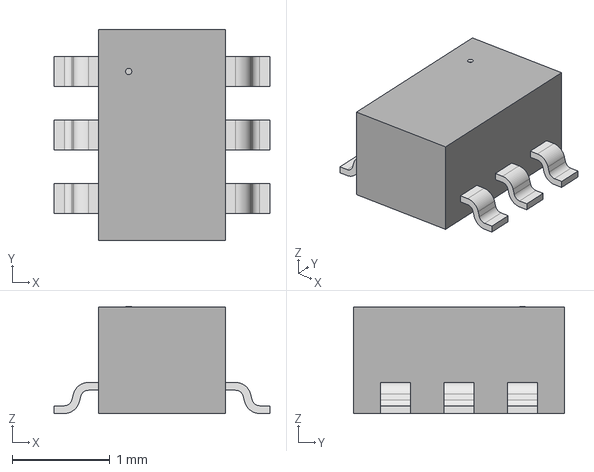
[picture p125: CAD file, 2024-09-05]
DS_models/Package_TO_SOT_SMD/SOT363_1P3X2P15_DIO.step
2.21 x 2.16 x 1.09 mm
