DeepSpace00/DeepSpace-KiCad-Global-Source/DS_models/Resistor_SMD/CRCW1210.STEP

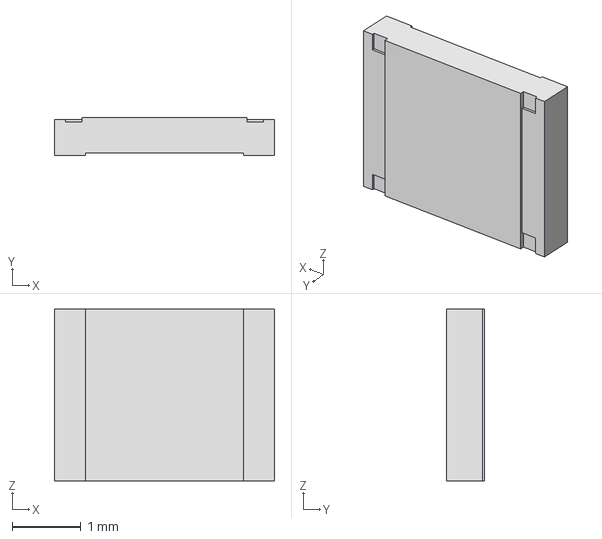
[picture p126: CAD file, 2024-11-03]
DS_models/Resistor_SMD/CRCW1210.STEP
3.20 x 0.55 x 2.50 mm
