DeepSpace00/DeepSpace-KiCad-Global-Source/DS_models/Capacitor_Ceramic_SMD/KAM0603.STEP

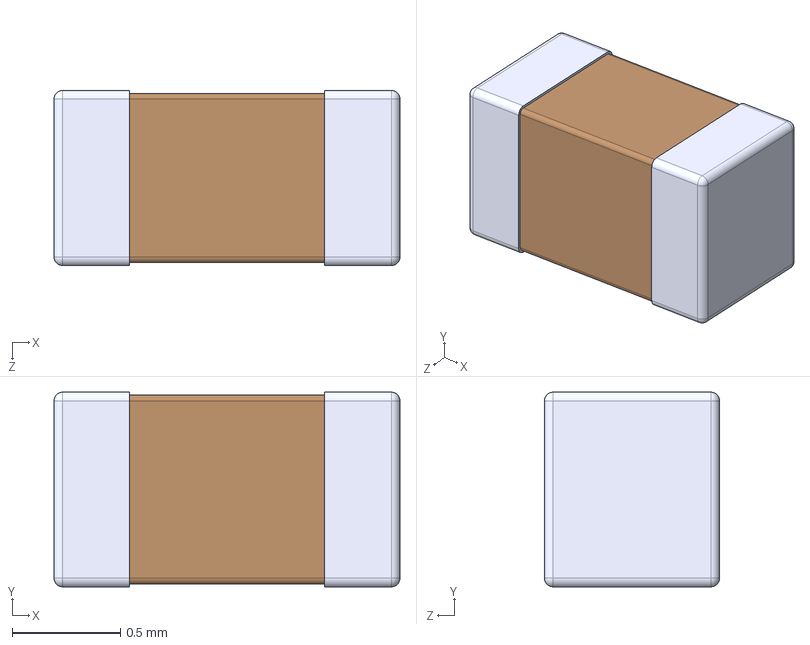
[picture p127: CAD file, 2024-11-03]
DS_models/Capacitor_Ceramic_SMD/KAM0603.STEP
1.60 x 0.9 x 0.81 mm
