DeepSpace00/DeepSpace-KiCad-Global-Source/DS_models/Connector_JST/S2B-PH-SM4-TB(LF)(SN).STEP

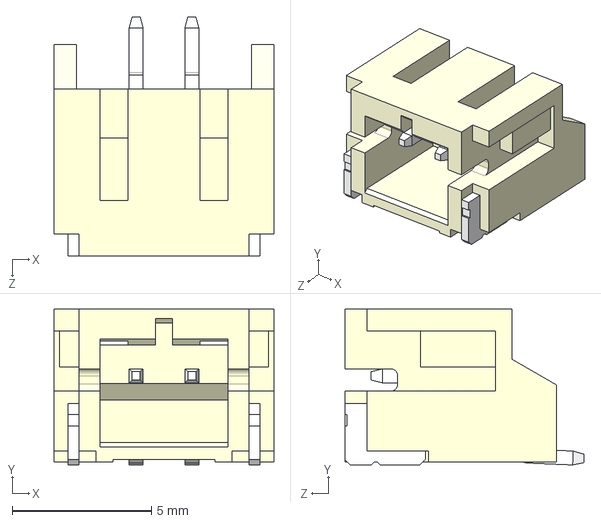
[picture p128: CAD file, 2024-09-05]
DS_models/Connector_JST/S2B-PH-SM4-TB(LF)(SN).STEP
7.90 x 5.60 x 8.60 mm
