DeepSpace00/DeepSpace-KiCad-Global-Source/DS_models/Inductor_SMD/IND_VISHAY_IMC0805-01_VIS.step

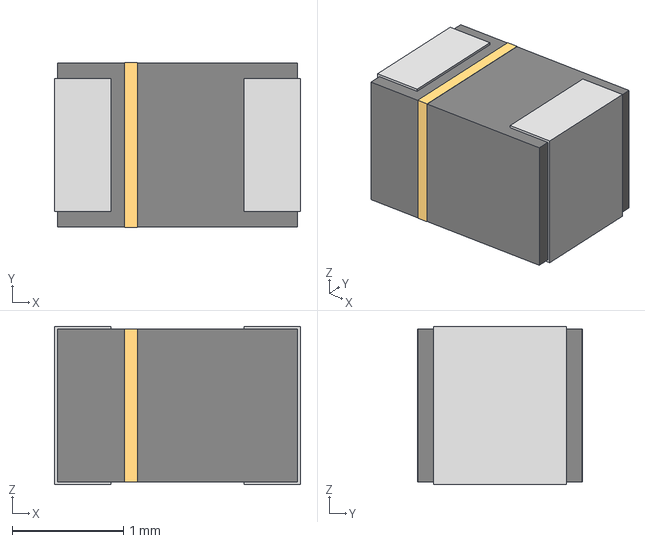
[picture p130: CAD file, 2024-09-05]
DS_models/Inductor_SMD/IND_VISHAY_IMC0805-01_VIS.step
2.21 x 1.48 x 1.42 mm
