DeepSpace00/DeepSpace-KiCad-Global-Source/DS_models/Resistor_SMD/WSL2512-18-0_0005-to-0_00099.STEP

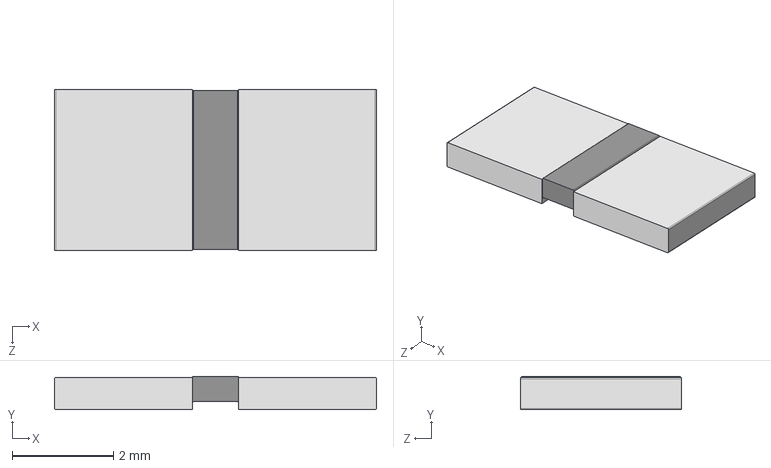
[picture p131: CAD file, 2024-11-03]
DS_models/Resistor_SMD/WSL2512-18-0_0005-to-0_00099.STEP
6.35 x 0.66 x 3.18 mm
