DeepSpace00/DeepSpace-KiCad-Global-Source/DS_models/Capacitor_Ceramic_SMD/C0805C104K5RACTU.stp

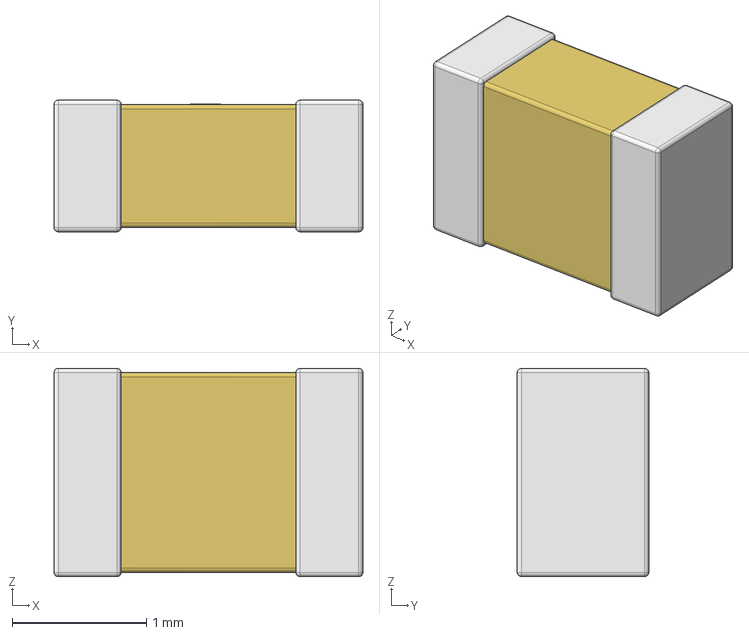
[picture p132: CAD file, 2024-09-05]
DS_models/Capacitor_Ceramic_SMD/C0805C104K5RACTU.stp
2.30 x 0.98 x 1.55 mm
