DeepSpace00/DeepSpace-KiCad-Global-Source/DS_models/Inductor_SMD/WE-PD_7345P_STP.STEP

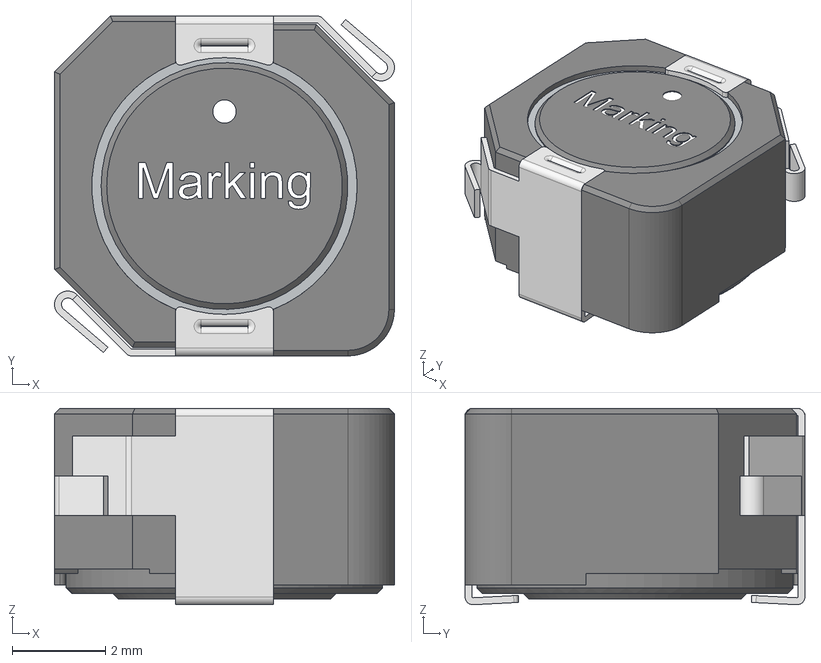
[picture p134: CAD file, 2024-09-05]
DS_models/Inductor_SMD/WE-PD_7345P_STP.STEP
7.30 x 7.30 x 4.22 mm
base x 2
core
shielding ring
glue
