DeepSpace00/DeepSpace-KiCad-Global-Source/DS_models/Resistor_SMD/D10-CRCW0402.STEP

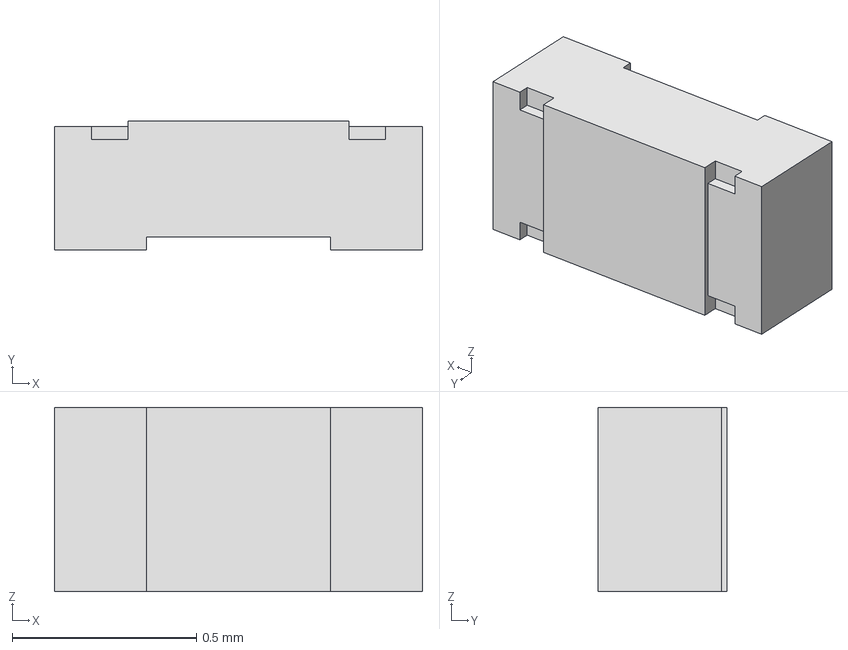
[picture p135: CAD file, 2024-11-03]
DS_models/Resistor_SMD/D10-CRCW0402.STEP
1.00 x 0.35 x 0.5 mm
