DeepSpace00/DeepSpace-KiCad-Global-Source/DS_models/Capacitor_Ceramic_SMD/C0603C104K5RACTU.stp

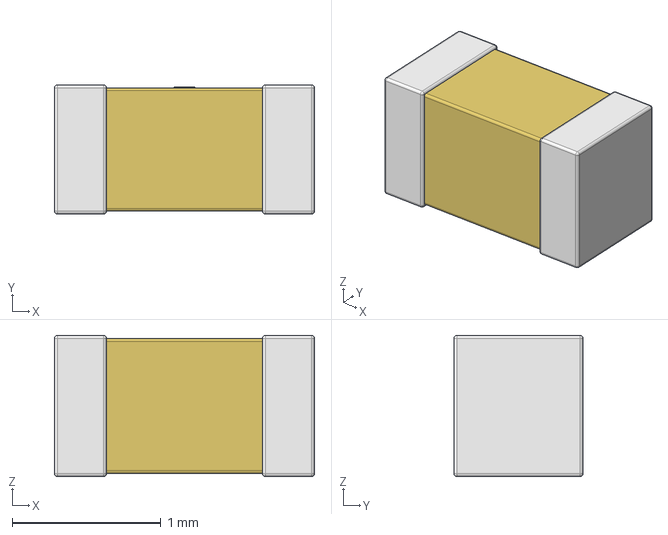
[picture p136: CAD file, 2024-09-05]
DS_models/Capacitor_Ceramic_SMD/C0603C104K5RACTU.stp
1.75 x 0.87 x 0.95 mm
