DeepSpace00/DeepSpace-KiCad-Global-Source/DS_models/Connector_PinHeader_2.54mm/PinHeader_1x34_P2.54mm_Horizontal.step

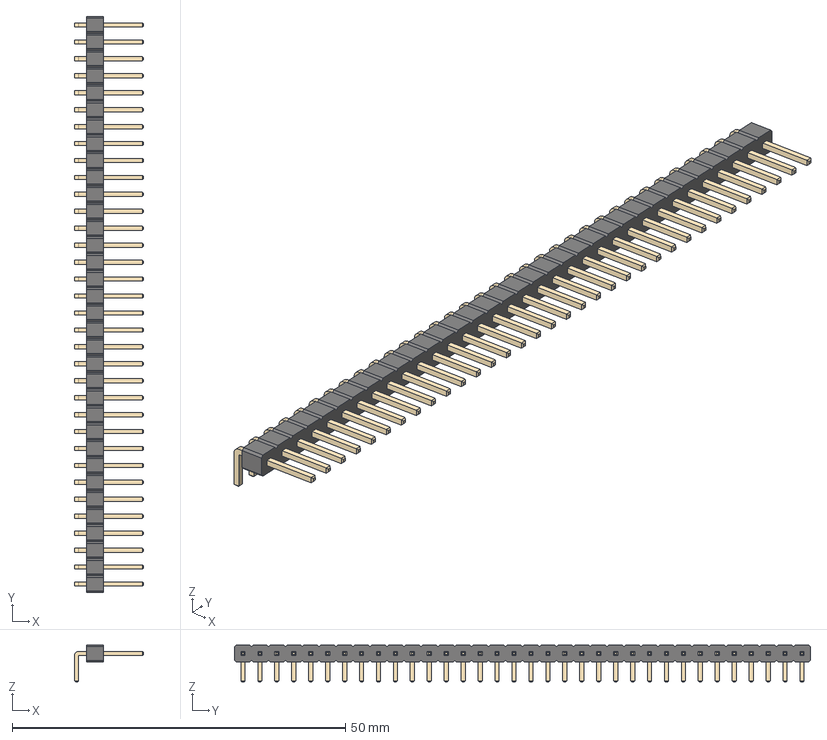
[picture p137: CAD file, 2025-07-27]
DS_models/Connector_PinHeader_2.54mm/PinHeader_1x34_P2.54mm_Horizontal.step
10.4 x 86.4 x 5.54 mm
