DeepSpace00/DeepSpace-KiCad-Global-Source/DS_models/Inductor_SMD/WE-PD_1030P_STP.STEP

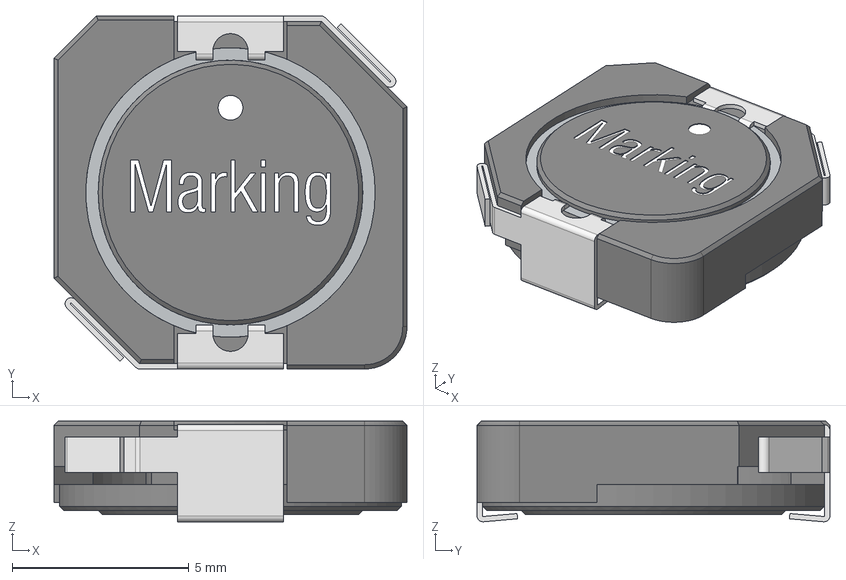
[picture p138: CAD file, 2024-09-05]
DS_models/Inductor_SMD/WE-PD_1030P_STP.STEP
10.0 x 10.0 x 2.85 mm
core
shielding ring
base x 2
glue
