DeepSpace00/DeepSpace-KiCad-Global-Source/DS_models/Resistor_SMD/WSL2010-18-0_007-to-0_5.STEP

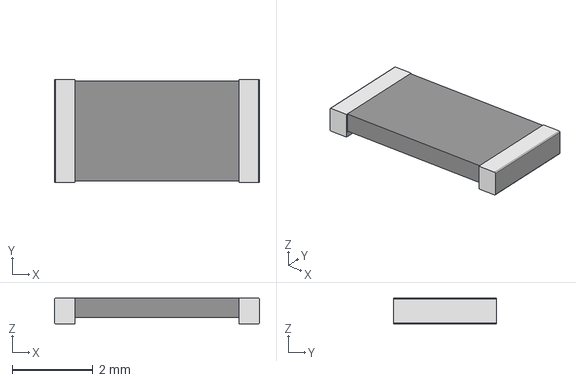
[picture p139: CAD file, 2024-11-03]
DS_models/Resistor_SMD/WSL2010-18-0_007-to-0_5.STEP
5.08 x 2.54 x 0.635 mm
