DeepSpace00/DeepSpace-KiCad-Global-Source/(list of files, cad)

Other CAD files:
DS_models/xiaoC6.FCStd
DS_models/Capacitor_Ceramic_SMD/GRT21BR71C475KE13L.STEP
DS_models/Package_TO_SOT_SMD/BSS138K.STEP
DS_models/XKTF-015-N.stp
DS_models/10162581-3134111lf.stp
DS_models/10162583-411111lf.stp
DS_models/105450-0101.step
DS_models/1935161--3DModel-STEP-56544.STEP
DS_models/1935161.stp
DS_models/2041-1X08G00SA.stp
DS_models/4383 1.14in TFT Display.step
DS_models/5646 NeoPixel Grid 5x5 BFF.step
DS_models/BME280--3DModel-STEP-56544.STEP
DS_models/BSS138K.STEP
DS_models/Button_Switch_SMD/JS102011SAQN.stp
DS_models/CGA0402.STEP
DS_models/CGA0603.STEP
DS_models/CGA0805.STEP
DS_models/CGA1206.STEP
DS_models/CRCW0402.STEP
DS_models/CRCW0603.STEP
DS_models/CRCW0805.STEP
DS_models/Capacitor_Ceramic_SMD/C0402C104K4RACTU.stp
DS_models/Capacitor_Ceramic_SMD/C1206C104K5RACTU.stp
DS_models/Connector_JST/JST-XH SMD Parametric.f3d
DS_models/Connector_Mezzanine/10162581-3134111lf.stp
DS_models/Connector_Mezzanine/10162583-411111lf.stp
DS_models/Connector_PinHeader_2.54mm/PinHeader_1x01_P2.54mm_Horizontal.step
DS_models/Connector_PinHeader_2.54mm/PinHeader_1x01_P2.54mm_Vertical.step
DS_models/Connector_PinHeader_2.54mm/PinHeader_1x02_P2.54mm_Horizontal.step
DS_models/Connector_PinHeader_2.54mm/PinHeader_1x02_P2.54mm_Vertical.step
DS_models/Connector_PinHeader_2.54mm/PinHeader_1x02_P2.54mm_Vertical_SMD_Pin1Left.step
DS_models/Connector_PinHeader_2.54mm/PinHeader_1x02_P2.54mm_Vertical_SMD_Pin1Right.step
DS_models/Connector_PinHeader_2.54mm/PinHeader_1x03_P2.54mm_Horizontal.step
DS_models/Connector_PinHeader_2.54mm/PinHeader_1x03_P2.54mm_Vertical.step
DS_models/Connector_PinHeader_2.54mm/PinHeader_1x03_P2.54mm_Vertical_SMD_Pin1Left.step
DS_models/Connector_PinHeader_2.54mm/PinHeader_1x03_P2.54mm_Vertical_SMD_Pin1Right.step
DS_models/Connector_PinHeader_2.54mm/PinHeader_1x04_P2.54mm_Horizontal.step
DS_models/Connector_PinHeader_2.54mm/PinHeader_1x04_P2.54mm_Vertical.step
DS_models/Connector_PinHeader_2.54mm/PinHeader_1x04_P2.54mm_Vertical_SMD_Pin1Left.step
DS_models/Connector_PinHeader_2.54mm/PinHeader_1x04_P2.54mm_Vertical_SMD_Pin1Right.step
DS_models/Connector_PinHeader_2.54mm/PinHeader_1x05_P2.54mm_Horizontal.step
DS_models/Connector_PinHeader_2.54mm/PinHeader_1x05_P2.54mm_Vertical.step
DS_models/Connector_PinHeader_2.54mm/PinHeader_1x05_P2.54mm_Vertical_SMD_Pin1Left.step
DS_models/Connector_PinHeader_2.54mm/PinHeader_1x05_P2.54mm_Vertical_SMD_Pin1Right.step
DS_models/Connector_PinHeader_2.54mm/PinHeader_1x06_P2.54mm_Horizontal.step
DS_models/Connector_PinHeader_2.54mm/PinHeader_1x06_P2.54mm_Vertical.step
DS_models/Connector_PinHeader_2.54mm/PinHeader_1x06_P2.54mm_Vertical_SMD_Pin1Left.step
DS_models/Connector_PinHeader_2.54mm/PinHeader_1x06_P2.54mm_Vertical_SMD_Pin1Right.step
DS_models/Connector_PinHeader_2.54mm/PinHeader_1x07_P2.54mm_Horizontal.step
DS_models/Connector_PinHeader_2.54mm/PinHeader_1x07_P2.54mm_Vertical.step
DS_models/Connector_PinHeader_2.54mm/PinHeader_1x07_P2.54mm_Vertical_SMD_Pin1Right.step
DS_models/Connector_PinHeader_2.54mm/PinHeader_1x08_P2.54mm_Horizontal.step
DS_models/Connector_PinHeader_2.54mm/PinHeader_1x08_P2.54mm_Vertical.step
DS_models/Connector_PinHeader_2.54mm/PinHeader_1x08_P2.54mm_Vertical_SMD_Pin1Left.step
DS_models/Connector_PinHeader_2.54mm/PinHeader_1x08_P2.54mm_Vertical_SMD_Pin1Right.step
DS_models/Connector_PinHeader_2.54mm/PinHeader_1x09_P2.54mm_Horizontal.step
DS_models/Connector_PinHeader_2.54mm/PinHeader_1x09_P2.54mm_Vertical.step
DS_models/Connector_PinHeader_2.54mm/PinHeader_1x09_P2.54mm_Vertical_SMD_Pin1Left.step
DS_models/Connector_PinHeader_2.54mm/PinHeader_1x09_P2.54mm_Vertical_SMD_Pin1Right.step
DS_models/Connector_PinHeader_2.54mm/PinHeader_1x10_P2.54mm_Horizontal.step
DS_models/Connector_PinHeader_2.54mm/PinHeader_1x10_P2.54mm_Vertical.step
DS_models/Connector_PinHeader_2.54mm/PinHeader_1x10_P2.54mm_Vertical_SMD_Pin1Left.step
DS_models/Connector_PinHeader_2.54mm/PinHeader_1x10_P2.54mm_Vertical_SMD_Pin1Right.step
DS_models/Connector_PinHeader_2.54mm/PinHeader_1x11_P2.54mm_Horizontal.step
DS_models/Connector_PinHeader_2.54mm/PinHeader_1x11_P2.54mm_Vertical.step
DS_models/Connector_PinHeader_2.54mm/PinHeader_1x11_P2.54mm_Vertical_SMD_Pin1Left.step
DS_models/Connector_PinHeader_2.54mm/PinHeader_1x11_P2.54mm_Vertical_SMD_Pin1Right.step
DS_models/Connector_PinHeader_2.54mm/PinHeader_1x12_P2.54mm_Horizontal.step
DS_models/Connector_PinHeader_2.54mm/PinHeader_1x12_P2.54mm_Vertical.step
DS_models/Connector_PinHeader_2.54mm/PinHeader_1x12_P2.54mm_Vertical_SMD_Pin1Left.step
DS_models/Connector_PinHeader_2.54mm/PinHeader_1x13_P2.54mm_Horizontal.step
DS_models/Connector_PinHeader_2.54mm/PinHeader_1x13_P2.54mm_Vertical.step
DS_models/Connector_PinHeader_2.54mm/PinHeader_1x13_P2.54mm_Vertical_SMD_Pin1Left.step
DS_models/Connector_PinHeader_2.54mm/PinHeader_1x13_P2.54mm_Vertical_SMD_Pin1Right.step
DS_models/Connector_PinHeader_2.54mm/PinHeader_1x14_P2.54mm_Horizontal.step
DS_models/Connector_PinHeader_2.54mm/PinHeader_1x14_P2.54mm_Vertical.step
DS_models/Connector_PinHeader_2.54mm/PinHeader_1x14_P2.54mm_Vertical_SMD_Pin1Left.step
DS_models/Connector_PinHeader_2.54mm/PinHeader_1x14_P2.54mm_Vertical_SMD_Pin1Right.step
DS_models/Connector_PinHeader_2.54mm/PinHeader_1x15_P2.54mm_Horizontal.step
DS_models/Connector_PinHeader_2.54mm/PinHeader_1x15_P2.54mm_Vertical.step
DS_models/Connector_PinHeader_2.54mm/PinHeader_1x15_P2.54mm_Vertical_SMD_Pin1Left.step
DS_models/Connector_PinHeader_2.54mm/PinHeader_1x15_P2.54mm_Vertical_SMD_Pin1Right.step
DS_models/Connector_PinHeader_2.54mm/PinHeader_1x16_P2.54mm_Horizontal.step
DS_models/Connector_PinHeader_2.54mm/PinHeader_1x16_P2.54mm_Vertical.step
DS_models/Connector_PinHeader_2.54mm/PinHeader_1x16_P2.54mm_Vertical_SMD_Pin1Right.step
DS_models/Connector_PinHeader_2.54mm/PinHeader_1x17_P2.54mm_Horizontal.step
DS_models/Connector_PinHeader_2.54mm/PinHeader_1x17_P2.54mm_Vertical.step
DS_models/Connector_PinHeader_2.54mm/PinHeader_1x17_P2.54mm_Vertical_SMD_Pin1Left.step
DS_models/Connector_PinHeader_2.54mm/PinHeader_1x17_P2.54mm_Vertical_SMD_Pin1Right.step
DS_models/Connector_PinHeader_2.54mm/PinHeader_1x18_P2.54mm_Horizontal.step
DS_models/Connector_PinHeader_2.54mm/PinHeader_1x18_P2.54mm_Vertical.step
DS_models/Connector_PinHeader_2.54mm/PinHeader_1x18_P2.54mm_Vertical_SMD_Pin1Right.step
DS_models/Connector_PinHeader_2.54mm/PinHeader_1x19_P2.54mm_Horizontal.step
DS_models/Connector_PinHeader_2.54mm/PinHeader_1x19_P2.54mm_Vertical.step
DS_models/Connector_PinHeader_2.54mm/PinHeader_1x19_P2.54mm_Vertical_SMD_Pin1Left.step
DS_models/Connector_PinHeader_2.54mm/PinHeader_1x19_P2.54mm_Vertical_SMD_Pin1Right.step
DS_models/Connector_PinHeader_2.54mm/PinHeader_1x20_P2.54mm_Horizontal.step
DS_models/Connector_PinHeader_2.54mm/PinHeader_1x20_P2.54mm_Vertical.step
DS_models/Connector_PinHeader_2.54mm/PinHeader_1x20_P2.54mm_Vertical_SMD_Pin1Left.step
DS_models/Connector_PinHeader_2.54mm/PinHeader_1x20_P2.54mm_Vertical_SMD_Pin1Right.step
DS_models/Connector_PinHeader_2.54mm/PinHeader_1x21_P2.54mm_Horizontal.step
DS_models/Connector_PinHeader_2.54mm/PinHeader_1x21_P2.54mm_Vertical_SMD_Pin1Left.step
DS_models/Connector_PinHeader_2.54mm/PinHeader_1x21_P2.54mm_Vertical_SMD_Pin1Right.step
DS_models/Connector_PinHeader_2.54mm/PinHeader_1x22_P2.54mm_Horizontal.step
DS_models/Connector_PinHeader_2.54mm/PinHeader_1x22_P2.54mm_Vertical.step
DS_models/Connector_PinHeader_2.54mm/PinHeader_1x22_P2.54mm_Vertical_SMD_Pin1Left.step
DS_models/Connector_PinHeader_2.54mm/PinHeader_1x22_P2.54mm_Vertical_SMD_Pin1Right.step
DS_models/Connector_PinHeader_2.54mm/PinHeader_1x23_P2.54mm_Horizontal.step
DS_models/Connector_PinHeader_2.54mm/PinHeader_1x23_P2.54mm_Vertical.step
DS_models/Connector_PinHeader_2.54mm/PinHeader_1x23_P2.54mm_Vertical_SMD_Pin1Left.step
DS_models/Connector_PinHeader_2.54mm/PinHeader_1x23_P2.54mm_Vertical_SMD_Pin1Right.step
DS_models/Connector_PinHeader_2.54mm/PinHeader_1x24_P2.54mm_Horizontal.step
DS_models/Connector_PinHeader_2.54mm/PinHeader_1x24_P2.54mm_Vertical.step
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
