DeepSpace00/DeepSpace-KiCad-Global-Source/(commit log)

2024-09-13 added BQ25798 batt charger
2024-09-14 modified batt charger symbol
2024-10-10 renamed folders
    [1-292303-1.step, 10162581-3134111lf.stp, 10162583-411111lf.stp, 105450-0101.step, 1935161--3DModel-STEP-56544.STEP, 1935161.STEP, 1935161.stp, 1x12ShortHeader.stp]
2024-10-14 renamed library and added power symbols
2024-10-14 added LED symbols
2024-10-14 formatted MOSFET symbols and added some new ones
2024-10-14 renamed capacitors
2024-10-14 renamed resistors
2024-10-14 fixed footprint layers
2024-10-14 added footprint for 2010 WSL-HP resistor
2024-10-19 added fuse footprint
2024-10-23 created symbol for 1206 PTS resettable fuse
2024-10-23 created footprint for HCM inductor
2024-10-23 created footprint for 1206 LED
2024-10-23 created footprint for generic SOT404 / DPak
2024-10-23 created footprint for TI chip
2024-10-28 added symbol for spdt switch and mom-on button
2024-10-28 added symbol and footprint for stm32l4
2024-10-28 added footprints for TI PMICs
2024-10-28 added footprint for mosfet
2024-10-30 added symbol for STM32L052K6
2024-10-31 MOLEX USBC footprint
2024-10-31 Tag-Connect footprint
2024-10-31 4SMD oscillator footprint
2024-10-31 ESC 2pin crystal footprint
2024-10-31 TI CANbus transceiver footprint
2024-10-31 AP211K-3.3 footprint
2024-10-31 added symbol for TI CANbus transceiver
2024-11-01 added barrel jack footprint
2024-11-01 added XT60 footprint
2024-11-01 removed tag-connect solder paste layer
2024-11-01 added SOD523 footprint
2024-11-01 created 01x02 pin header footprint
2024-11-01 created 01x03 pin header footprint
2024-11-01 created 01x09 pin header 90deg footprint
2024-11-01 added JST XH S3B footprint
2024-11-01 added JST connector symbols
2024-11-03 added 3D models
    [CRCW1210.STEP, CRCW1218.STEP, CRCW2010.STEP, CRCW2512.STEP, D10-CRCW0402.STEP, D11-CRCW0603.STEP, D12-CRCW0805.STEP, D25-CRCW1206.STEP]
2024-11-03 removed 3D models
    [EXB2HV103JV.stp, WSLT2010...18 (0.01 to 0.5).stp]
2024-11-03 modified footprints
2024-11-09 added 2x2 resistor
2024-11-15 footprint for M.2 E-key
2024-11-15 added single TVS diode symbol
2024-11-18 added testpoint footprint and 0805 LED footprint
2024-11-22 AVX 0402 MLCC model
    [KAM0402.STEP]
2024-11-22 created diodes lib
2024-11-22 added vertical LED symbol
2024-11-22 added power symbols
2024-11-25 added footprints
2024-11-26 added footprint
2024-11-26 renamed SOD123 3d model
    [SOD-123.STEP]
2024-11-28 fixed footprints and added some
2024-12-01 merged in KiCAD symbols FP lib
2024-12-01 footprint for TI level shifter
2024-12-02 added A+E key footprint
2024-12-02 added cut trace footprint
2024-12-04 added sim card slot symbol
2024-12-04 added power symbols for 3V8 and VSIM
2024-12-06 added footprint for u-blox SARA modems
2024-12-06 footprint for SIM card holder
2024-12-06 1212 inductor footprint
2024-12-06 footprint for TI LM51571-Q1
2024-12-22 added models
    [WSL0612.STEP, WSL1020.STEP]
2025-01-14 created M3 mountinghole FP
2025-04-14 removed models
    [WE-PD_1030P_STP.stp, WE-PD_7345P_STP.stp]
2025-04-26 sma connector footprints
